nebraska-silicon-lab/Hardware/ETL/FNAL Tooling Designs/Chuck/ETL assy gantry layout.JPG

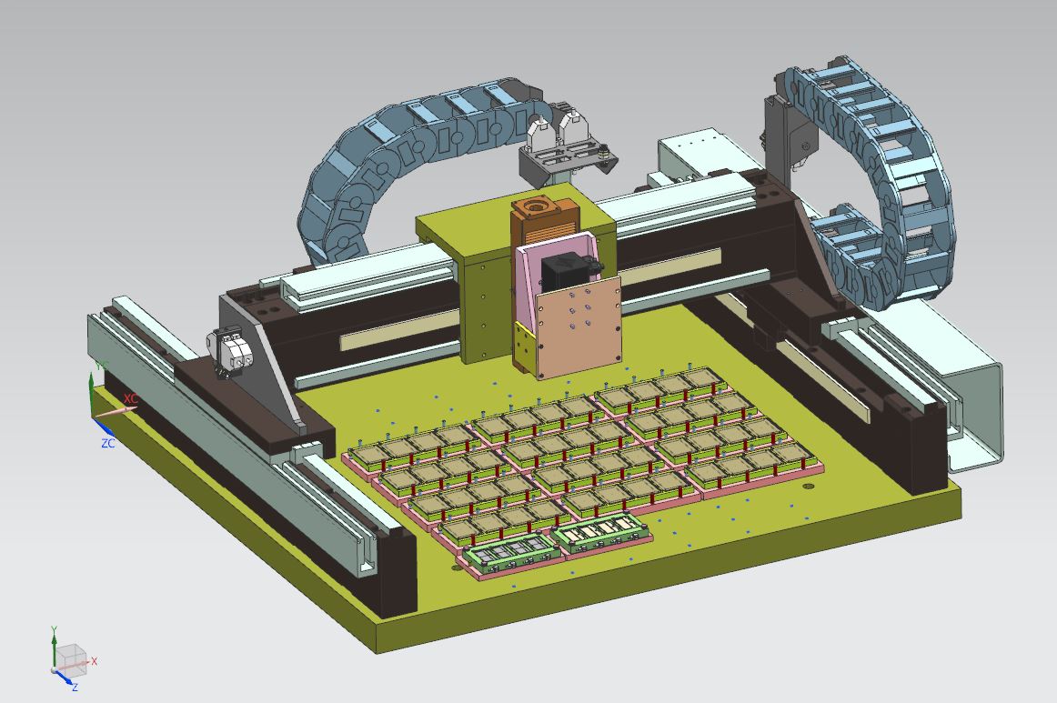
ETL/FNAL Tooling Designs/Chuck/ETL assy gantry layout.JPG
