nebraska-silicon-lab/Hardware/General Gantry/Gantry Hub/Graphics/Front Barrel Jack Label.png

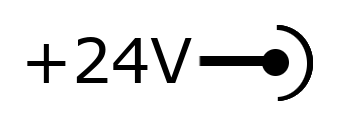
General Gantry/Gantry Hub/Graphics/Front Barrel Jack Label.png
