nebraska-silicon-lab/Hardware/General Gantry/Gantry Hub/Graphics/Front Graphic.png

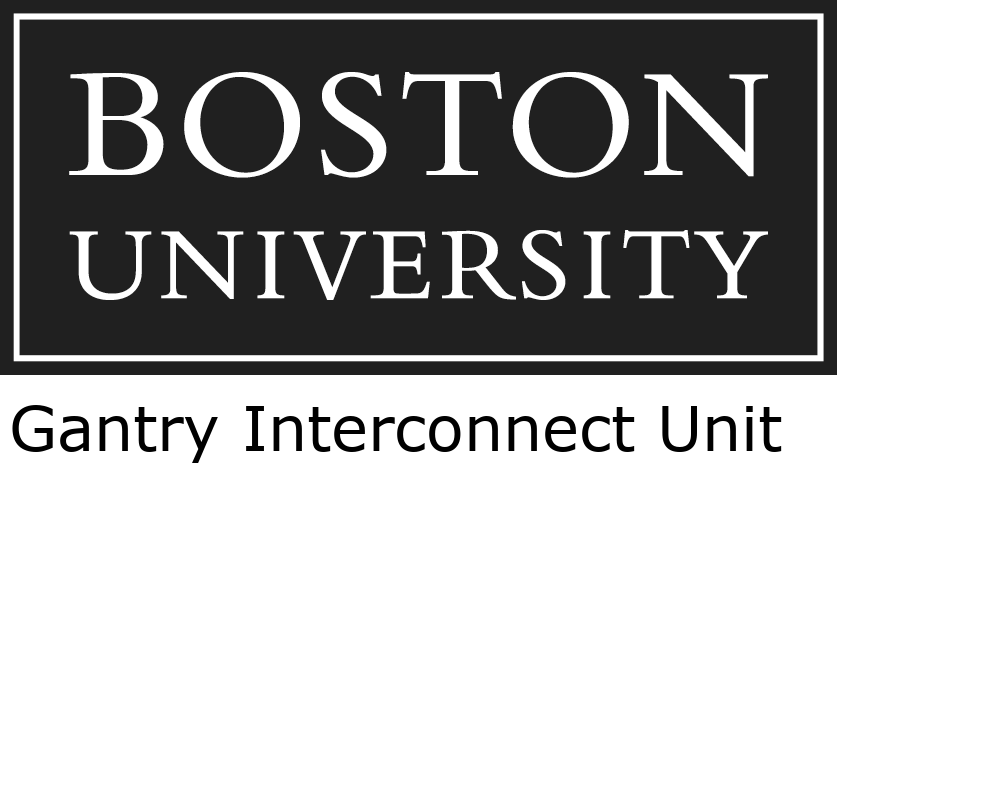
General Gantry/Gantry Hub/Graphics/Front Graphic.png
