nebraska-silicon-lab/Hardware/Wirebonder/Chuck spacer.JPG

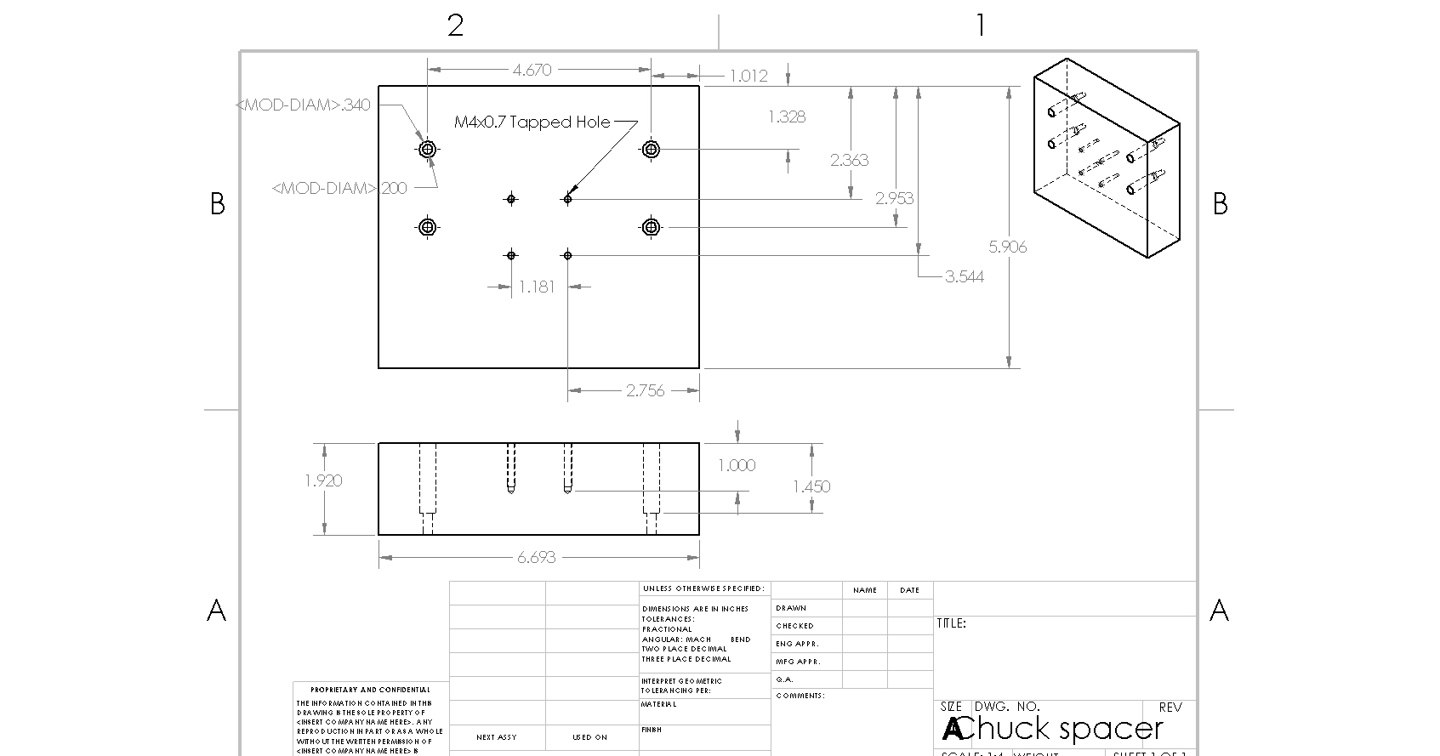
Wirebonder/Chuck spacer.JPG
