nebraska-silicon-lab/Hardware/Work Orders/ETL_blank_inst_workorder.xlsx

Chemistry and Physics & Astronomy |  |  |  |  |  | Daily Work Log
 |  |  |  |  |  | Name | Date | Hrs.
Instrument Shop Billing
Bob Rhynalds rrhynalds@unl.edu
177 JH 0299
472-2780
Cost Object | Department |  |  | Today's Date
26-0521-0189-002 M&S 26-0521-0189-003 labor | Physics & Astronomy
Requested by | Requestor's Phone |  |  | Requestors email
Requestor's Supervisor | Supervisor's Phone |  |  | Supervisor's Dept.
 |  |  |  | Physics & Astronomy
Equipment Name:
Work Instructions:
Comments:
Materials |  | QTY | Unit Cost |  | Total Cost
 |  |  |  |  | $0.00
 |  |  |  |  | $0.00
 |  |  |  |  | $0.00
 |  |  |  |  | $0.00
 |  |  |  |  | $0.00
 |  |  |  |  | $0.00
 |  |  |  |  | $0.00
 |  |  |  |  | $0.00
 |  |  |  |  | $0.00
 |  |  |  |  | $0.00
 |  |  |  |  | $0.00
 |  |  |  |  | $0.00
 |  |  |  |  | $0.00
 |  |  |  |  | $0.00
 |  |  |  |  | $0.00
 |  |  |  |  | $0.00
 |  |  |  |  | $0.00
 |  |  |  |  | $0.00
 |  |  |  |  | $0.00
Total Material Cost: |  |  |  |  | $0.00
 |  |  |  |  |  | Total Hours: |  | 0.00
Date Billed: | Total Hours: |  | SAP#
Total Materials: |  |  |  |  |  |  | Revised 18 Jan. 2013
© 2004-2013 University of Nebraska-Lincoln Physics and Astronomy Department
