nebraska-silicon-lab/Hardware/Work Orders/ETL_blank_elec_workorder.xlsx

Physics Electronic Shop Billing for ETL
Requested by: |  |  | Cost Object: | Supervisor: | Date: |  | Info:
 |  |  | 26-0521-0189-002 M&S -003 Labor | Frank Golf
Purpose:
Material |  |  |  |  |  | Qty | Unit $ | Total $
 |  |  |  |  |  |  |  | $0.00
 |  |  |  |  |  |  |  | $0.00
 |  |  |  |  |  |  |  | $0.00
 |  |  |  |  |  |  |  | $0.00
 |  |  |  |  |  |  |  | $0.00
 |  |  |  |  |  |  |  | $0.00
 |  |  |  |  |  |  |  | $0.00
 |  |  |  |  |  |  |  | $0.00
 |  |  |  |  |  |  |  | $0.00
 |  |  |  |  |  |  |  | $0.00
 |  |  |  |  |  |  |  | $0.00
Total amount $ |  |  |  |  |  |  |  | $0.00
Date | Name | Hours | Comments/Purpose
Total Hours: |  | 0
Date Billed: |  |  | SAP Doc Number:
Total Materials:
Total Hours:
© 2018 University of Nebraska-Lincoln Physics and Astronomy Department
