nebraska-silicon-lab/Hardware/Work Orders/2022_01_MilliQan_Wrapping-Stencil.xlsx

Chemistry and Physics & Astronomy |  |  |  |  |  |  | Daily Work Log
 |  |  |  |  |  |  | Name | Date | Hrs.
Instrument Shop Billing
Bob Rhynalds rrhynalds@unl.edu
177 JH 0299
472-2780
Cost Object |  | Department |  |  | Today's Date
21-0521-4139 |  | Physics & Astronomy |  |  | 2022-01-21
Requested by |  | Requestor's Phone |  |  | Requestors email
Miranda Bryson |  | (3369051250 |  |  | mbryson4@unl.edu
Requestor's Supervisor |  | Supervisor's Phone |  |  | Supervisor's Dept.
Frank Golf |  | (4024726151 |  |  | Physics & Astronomy
Equipment Name: | Milliqan Wrapping Stencil
Work Instructions: |  | Fabricate metal stencil for Milliqan scintillator wrapping
Comments:
Materials |  |  | QTY | Unit Cost |  | Total Cost
 |  |  |  |  |  | $0.00
 |  |  |  |  |  | $0.00
 |  |  |  |  |  | $0.00
 |  |  |  |  |  | $0.00
 |  |  |  |  |  | $0.00
 |  |  |  |  |  | $0.00
 |  |  |  |  |  | $0.00
 |  |  |  |  |  | $0.00
 |  |  |  |  |  | $0.00
 |  |  |  |  |  | $0.00
 |  |  |  |  |  | $0.00
 |  |  |  |  |  | $0.00
 |  |  |  |  |  | $0.00
 |  |  |  |  |  | $0.00
 |  |  |  |  |  | $0.00
 |  |  |  |  |  | $0.00
 |  |  |  |  |  | $0.00
 |  |  |  |  |  | $0.00
 |  |  |  |  |  | $0.00
Total Material Cost: |  |  |  |  |  | $0.00
 |  |  |  |  |  |  | Total Hours: |  | 0.00
Date Billed: |  | Total Hours: |  | SAP#
Total Materials: |  |  |  |  |  |  |  | Revised 18 Jan. 2013
© 2004-2013 University of Nebraska-Lincoln Physics and Astronomy Department
