nebraska-silicon-lab/Hardware/Work Orders/2021_02_TFPX_weight_for_HDI.xlsx

Chemistry and Physics & Astronomy |  |  |  |  |  |  |  | Daily Work Log
 |  |  |  |  |  |  |  | Name | Date | Hrs.
Instrument Shop Billing |  |  |  |  |  |  |  | Keith | 2021-02-16 | 3.00
Bob Rhynalds rrhynalds@unl.edu
177 JH 0299 |  |  |  |  |  |  |  | Keith | 2021-02-17 | 3.00
472-2780
Cost Object |  |  | Department |  |  | Today's Date
M&S | 26-0521-0195-003 |  | Physics |  |  | Feb / 5th / 2021
labor | 26-0521-0195-001
Requested by |  |  | Requestor's Phone |  |  | Requestors email
Changwoo Joo |  |  | 531-218-8542 |  |  | gopchang24@gmail.com
Requestor's Supervisor |  |  | Supervisor's Phone |  |  | Supervisor's Dept.
Ilya Kravchenko |  |  | 402-617-5736 |  |  | Physics
Equipment Name: |  | weight for HDI
Work Instructions: |  |  | Simple wight to press HDI. Making a new one with
more holes to measure the HDI position
Comments:
Materials |  |  |  | QTY | Unit Cost |  | Total Cost
 |  |  |  |  |  |  | $0.00
1/8" endmill |  |  |  | 1.00 | $10.00 |  | $10.00
#56 Dill Bit |  |  |  | 1.00 | $2.50 |  | $2.50
1.0mm Carbide endmill |  |  |  | 1.00 | $8.25 |  | $8.25
 |  |  |  |  |  |  | $0.00
 |  |  |  |  |  |  | $0.00
 |  |  |  |  |  |  | $0.00
 |  |  |  |  |  |  | $0.00
 |  |  |  |  |  |  | $0.00
 |  |  |  |  |  |  | $0.00
 |  |  |  |  |  |  | $0.00
 |  |  |  |  |  |  | $0.00
 |  |  |  |  |  |  | $0.00
 |  |  |  |  |  |  | $0.00
 |  |  |  |  |  |  | $0.00
 |  |  |  |  |  |  | $0.00
 |  |  |  |  |  |  | $0.00
 |  |  |  |  |  |  | $0.00
 |  |  |  |  |  |  | $0.00
Total Material Cost: |  |  |  |  |  |  | $20.75
 |  |  |  |  |  |  |  | Total Hours: |  | 6.00
Date Billed: |  |  | Total Hours: |  | SAP#
Total Materials: |  |  |  |  |  |  |  |  | Revised 18 Jan. 2013
© 2004-2013 University of Nebraska-Lincoln Physics and Astronomy Department
