nebraska-silicon-lab/Hardware/General Gantry/Gantry Tool Rack/Tool Rack Assembly.xlsx

Part Name | File Path (from Gantry folder) | Model Checked | Drawing Name | Drawing Checked | Machined | Assembled | Notes
Top | NewGantryParts\Gantry Full Assembly\Tool Rack | X | Top.idw | X | X | X | working
Sides | NewGantryParts\Gantry Full Assembly\Tool Rack | X | Side.idw | X | X | X | working
Bottom | NewGantryParts\Gantry Full Assembly\Tool Rack | X | Base Plate.idw | X | X | X | working
BackStrap1 | NewGantryParts\Gantry Full Assembly\Tool Rack | X | Back Strap.idw | X | X | X | working
Spring Plungers 84985A58 | NewGantryParts\Gantry Full Assembly\Tool Rack | n/a | n/a | n/a | n/a | X | ordered from McMaster-Carr
SHCS-steel 8-32x0.5 | NewGantryParts\NewParts | n/a | n/a | n/a | n/a | X | ordered from McMaster-Carr
Spring Plungers 84985A15 | NewGantryParts\Gantry Full Assembly\Tool Rack | n/a | n/a | n/a | n/a | X | ordered from McMaster-Carr
