nebraska-silicon-lab/Hardware/General Gantry/Gantry Tool Holder/ToolHolder.xlsx

Sheet: Assembly
Assembly Name | File Path (from Gantry folder) | Model Checked | Drawing Name | Drawing Checked | Machined | Assembled | Notes
ToolHolderAssembly | NewGantryParts>OriginalUCSB>ToolHolder | XX | ToolHolderAssembly | XX |  |  | All machined parts for this assembly are needed at PURDUE and NEBRASKA.
ToolHolderAdapterAssy | \NewGantryParts\NewParts\ToolHolderAdapter | XX | ToolHolderAdapterAssy | XX |  |  | PURDUE does not need another ToolHolderAdapter machined.

Sheet: Tool Holder
Part Name | File Path (from Gantry folder) | Model Checked | Drawing Name | Drawing Checked | Machined | Assembled | Notes
HoseBarbAddOn | NewGantryParts>OriginalUCSB>ToolHolder | XX | HoseBarbAddOn | XX
ContactPuck | NewGantryParts>OriginalUCSB>ToolHolder | XX | ContactPuck | XX |  |  | adjust relief depth for actual micro switch height
DispenserHolder | NewGantryParts>OriginalUCSB>ToolHolder | XX | DispenserHolder | XX
DispenserHolderArm | NewGantryParts>OriginalUCSB>ToolHolder | XX | DispenserHolderArm | XX
DispenserHolderCapturePlate | NewGantryParts>OriginalUCSB>ToolHolder | XX | DispenserHolderCapturePlate | XX
ToolHolderSlugBody | NewGantryParts>OriginalUCSB>ToolHolder | XX | ToolHolderSlugBody | XX
ToolHolderSpool | NewGantryParts>OriginalUCSB>ToolHolder | XX | ToolHolderSpool | XX
Rolling bearing Type 51000 51105(ID 26mm Part) | NewGantryParts>OriginalUCSB>ToolHolder | X | n/a | n/a | n/a |  | 51105 Thrust Bearing 25x42x11 Thrust Bearings(VXB Ball Bearings)
BallBearingBall | NewGantryParts>OriginalUCSB>ToolHolder | X | n/a | n/a | n/a
5454K63_0.125ID_Tube_Barb | NewGantryParts>OriginalUCSB>ToolHolder | n/a | n/a | n/a | n/a
5454K740_0.0625ID_Tube_Barb | NewGantryParts>OriginalUCSB>ToolHolder | n/a | n/a | n/a | n/a
91772A030 | NewGantryParts>OriginalUCSB>ToolHolder | n/a | n/a | n/a | n/a
9396K27 Silicone O-Ring | NewGantryParts>OriginalUCSB>ToolHolder | n/a | n/a | n/a | n/a
9396K153 Silicone O-Ring | NewGantryParts>OriginalUCSB>ToolHolder | n/a | n/a | n/a | n/a
91251A831 | NewGantryParts>OriginalUCSB>ToolHolder | n/a | n/a | n/a | n/a
9452K87 Buna-N O-Ring | NewGantryParts>OriginalUCSB>ToolHolder | n/a | n/a | n/a | n/a
9452K14 Buna-N O-Ring | NewGantryParts>OriginalUCSB>ToolHolder | n/a | n/a | n/a | n/a
9452K15 Buna-N O-Ring | NewGantryParts>OriginalUCSB>ToolHolder | n/a | n/a | n/a | n/a
KSR MicroSwitch | NewGantryParts>OriginalUCSB>ToolHolder | n/a | n/a | n/a | n/a |  | Digi Key Number: 401-1703-1-ND, Manufacturers Number: KSR221GLFS
ToolHolderAdapter | NewGantryParts\NewParts\ToolHolderAdapter | XX | ToolHolderAdapter | XX | X | X | PURDUE does not need another ToolHolderAdapter machined.
92125A211 | NewGantryParts\NewParts\ToolHolderAdapter | n/a | n/a | n/a | n/a
9262K645 Buna-N O-Ring | NewGantryParts\NewParts\ToolHolderAdapter | n/a | n/a | n/a | n/a
92210A151 | NewGantryParts\NewParts\ToolHolderAdapter | n/a | n/a | n/a | n/a
