nebraska-silicon-lab/Hardware/FPIX/UNLHEP-14-01-partlist.txt

Assemblies
==========
UNLHEP-14-01-A-001_BonderChuckWplate.iam
UNLHEP-14-01-A-002_GantryChuckWplate.iam
UNLHEP-14-01-A-003_ChuckW4modules.iam
UNLHEP-14-01-A-004_ChuckOnTrspChuck.iam
UNLHEP-14-01-A-005_HdiGlueWeight.iam
UNLHEP-14-01-A-006_Rubberstamp.iam
UNLHEP-14-01-A-007_Picker.iam
UNLHEP-14-01-A-008_PickerWStamp.iam
UNLHEP-14-01-A-009_StampStorage.iam
UNLHEP-14-01-A-010_GlueResOnChuck.iam

Parts
=====
UNLHEP-14-01-P-001_ModuleChuck.ipt
UNLHEP-14-01-P-002_ChuckForBonder.ipt
UNLHEP-14-01-P-003_Tube4mmID20mm.ipt
UNLHEP-14-01-P-004_ChuckForGantry.ipt
UNLHEP-14-01-P-005_ModuleStencil.ipt
UNLHEP-14-01-P-006_SensorMock.ipt
UNLHEP-14-01-P-007_TransportChuck.ipt
UNLHEP-14-01-P-008_ValveStopper.ipt
UNLHEP-14-01-P-009_BrassWeight.ipt
UNLHEP-14-01-P-010_WeightBlade.ipt
UNLHEP-14-01-P-011_Rubberstamp.ipt
UNLHEP-14-01-P-012_StampPlate.ipt
UNLHEP-14-01-P-013_PickerPlate.ipt
UNLHEP-14-01-P-014_PickerDistanceRing.ipt
UNLHEP-14-01-P-015_PickerStrip.ipt
UNLHEP-14-01-P-016_StampStoragePlate.ipt
UNLHEP-14-01-P-017_GlueReservoit.ipt
UNLHEP-14-01-P-018_PickerRubberPiece.ipt
