nebraska-silicon-lab/Hardware/Work Orders/TFPX_blank_elec_workorder.xlsx

Physics Electronic Shop Billing for TFPX
Requested by: |  |  | Cost Object: | Supervisor: | Date: |  | Info:
 |  |  | M&S 26-0521-0195-003 labor 26-0521-0195-001 | Frank Golf
Purpose:
Material |  |  |  |  |  | Qty | Unit $ | Total $
 |  |  |  |  |  |  |  | $0.00
 |  |  |  |  |  |  |  | $0.00
 |  |  |  |  |  |  |  | $0.00
 |  |  |  |  |  |  |  | $0.00
 |  |  |  |  |  |  |  | $0.00
 |  |  |  |  |  |  |  | $0.00
 |  |  |  |  |  |  |  | $0.00
 |  |  |  |  |  |  |  | $0.00
 |  |  |  |  |  |  |  | $0.00
 |  |  |  |  |  |  |  | $0.00
 |  |  |  |  |  |  |  | $0.00
Total amount $ |  |  |  |  |  |  |  | $0.00
Date | Name | Hours | Comments/Purpose
Total Hours: |  | 0
Date Billed: |  |  | SAP Doc Number:
Total Materials:
Total Hours:
© 2018 University of Nebraska-Lincoln Physics and Astronomy Department
