nebraska-silicon-lab/Hardware/ETL/Irradiation Fixture/Module Holder Full Cover V1.stl

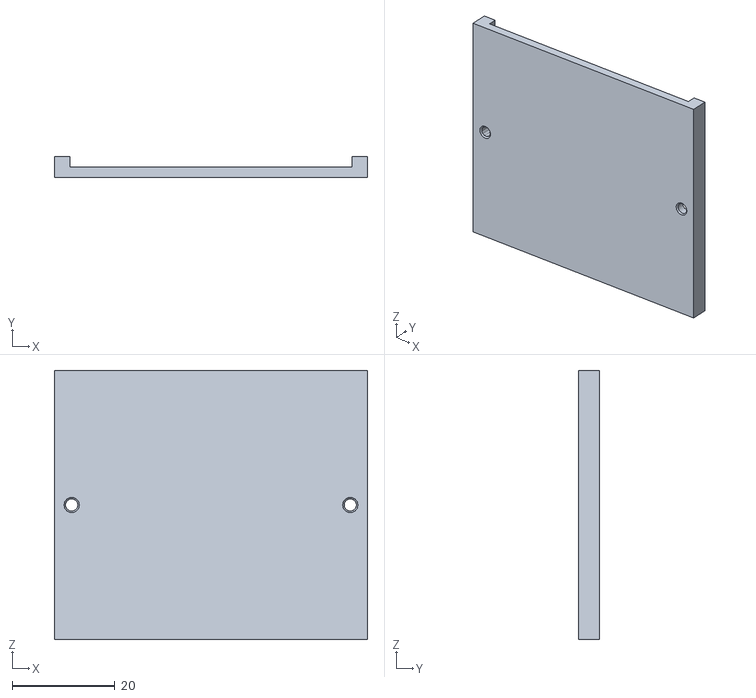
[picture p5: CAD file, 2024-06-04]
ETL/Irradiation Fixture/Module Holder Full Cover V1.stl
61.0 x 4.00 x 52.5
