nebraska-silicon-lab/Hardware/ETL/Module Assembly/Assembly Plate/Assembly Plate Assembly.stp

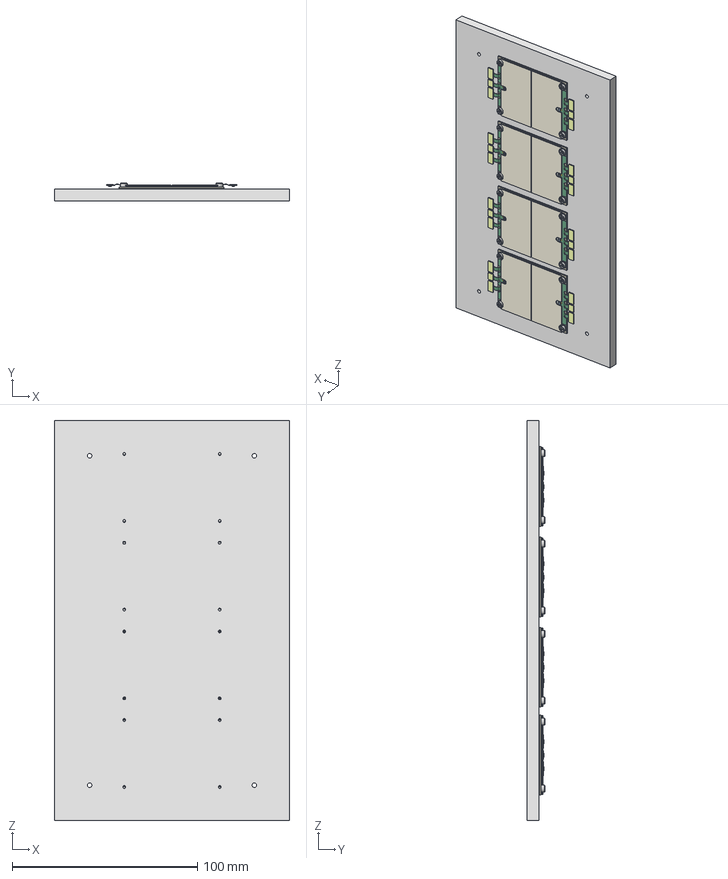
[picture p6: CAD file, 2021-02-12]
ETL/Module Assembly/Assembly Plate/Assembly Plate Assembly.stp
127.0 x 9.64 x 215.9 mm
Assembly Plate
F10109317--_1-MODULE_ CMS2 ETL_ FLEX CIRCUIT x 8
F10109316--_1-MODULE_ CMS2 ETL_ ALN SUBSTRATE x 4
F10112318--_1-MODULE_ CMS2 ETL_ PIXEL SENSOR 1X2 x 8
F10112320--_1-MODULE_ CMS2 ETL_ PIXEL SENSOR UNDERFILL x 8
F10112319--_1-MODULE_ CMS2 ETL_ PIXEL SENSOR READOUT CHIP x 16
F10110221--_1-MODULE_ CMS2 ETL_ FLEX CIRCUIT WIREBONDS x 8
F10112322--_1-MODULE_ CMS2 ETL_ READOUT CHIP MOUNTING FILM x 4
F10112323--_1-MODULE_ CMS2 ETL_ FLEX CIRCUIT MOUNTING FILM x 8
F10110888--_1-MODULE_ CMS2 ETL_ SUBSTRATE MOUNTING THERMAL PAD x 4
F10112938--_1-MODULE_ CMS2 ETL_ SENSOR COVER PLT x 8
F10116301--_1-MODULE_ CMS2 ETL_ SENSOR COVER PLT ADHESIVE x 8
F10109326--_1-WASHER_ BELLEVILLE_ .093IDx.187ODx.01THK_ 17-7 PH STAIN LESS STEEL x 16
FC0041908--_1-SHCS_M2x.4x5LGxFT_SS316L_ROLLED_EP x 16
