nebraska-silicon-lab/Hardware/ETL/modules/throughput mockups/Throughput Mockup Assembly.stp

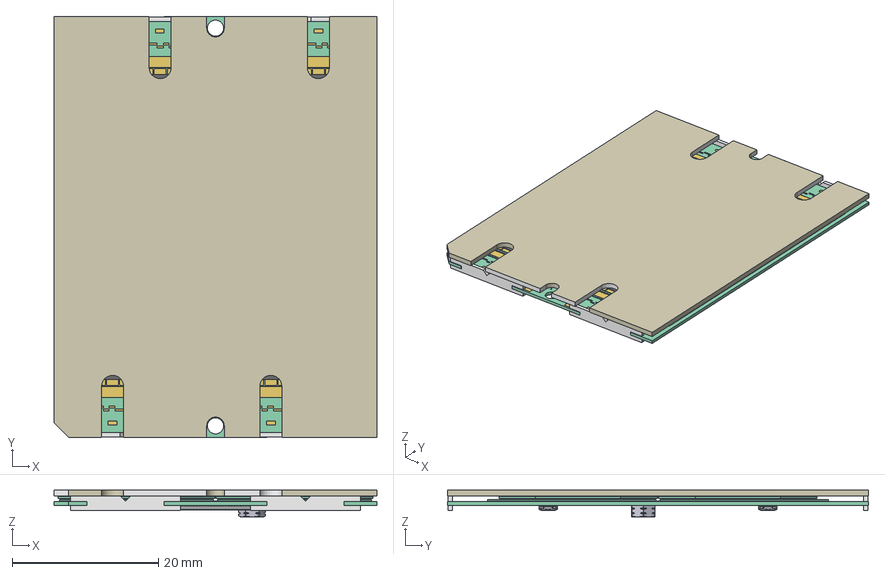
[picture p7: CAD file, 2024-06-04]
ETL/modules/throughput mockups/Throughput Mockup Assembly.stp
44.1 x 57.5 x 3.67 mm
etl_etroc_mockup_v1p1 x 4
etl_lgad_mockup_v1p2 x 4
Coverplate Film
Sensor Placement Film
etl standard baseplate with cutouts
etl_module_pcb_mockup_v3p3p1
insert spacer - v1 x 4
