nebraska-silicon-lab/Hardware/ETL/modules/throughput mockups/throughput mockups/Throughput Mockup Assembly.stp

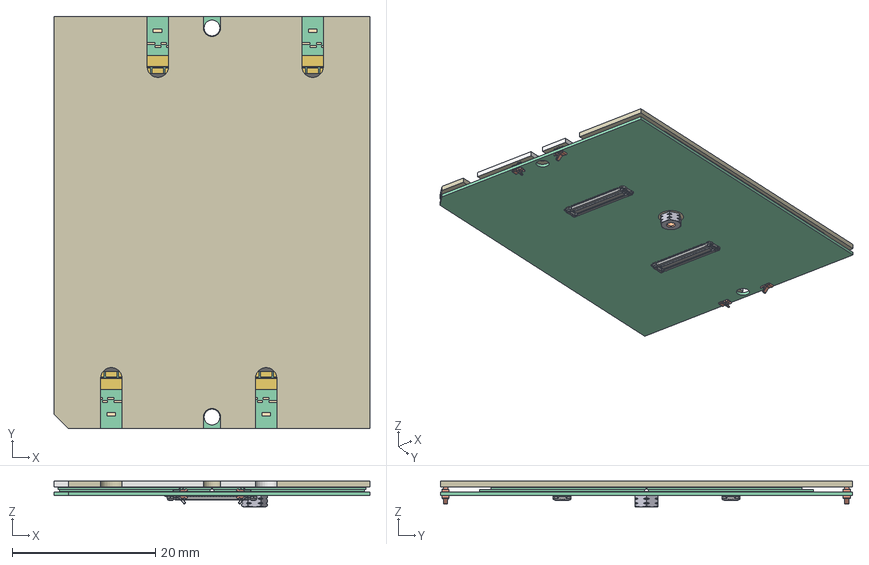
[picture p8: CAD file, 2023-03-06]
ETL/modules/throughput mockups/throughput mockups/Throughput Mockup Assembly.stp
44.1 x 57.5 x 3.60 mm
Pcb_3ce5
PCB_Sketch_3ce5
topPads_3ce5
botPads_3ce5
REF_C-2306334-3_inf x 8
REF_PRODUCT_NAME_1_62E086DE
J2_Board to board, M_613027AA x 2
etl_lgad_mockup_v1p1 x 4
etl_etroc_mockup_v1p1 x 4
Board to board, M x 2
Coverplate Film
Sensor Placement Film
etl standard baseplate with cutouts
