nebraska-silicon-lab/Hardware/ETL/Module Assembly/Weight - V2/step/Weight Assembly.stp

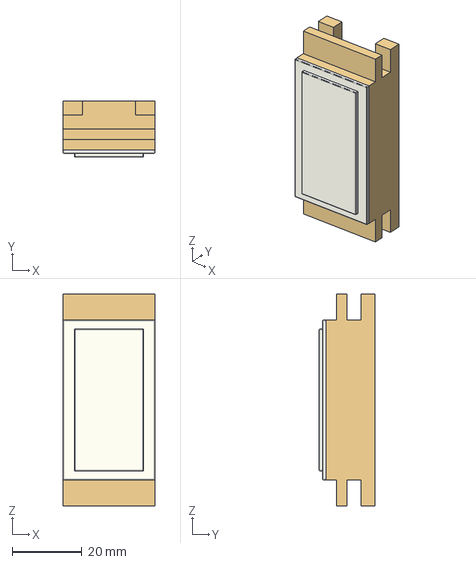
[picture p9: CAD file, 2021-07-19]
ETL/Module Assembly/Weight - V2/step/Weight Assembly.stp
26.3 x 16.0 x 60.7 mm
Stamp Body
Bottom Surface
