nebraska-silicon-lab/Hardware/MilliQan/PMT Mounts/Slab Mount - Fabricated - V2/Slab Mount Assembly - Fabricated - V2.stp

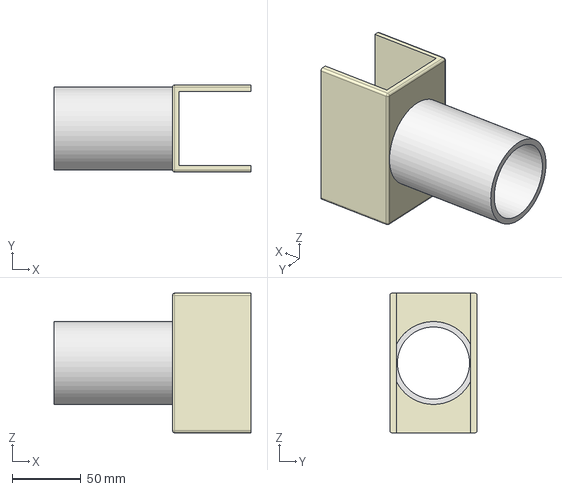
[picture p10: CAD file, 2022-04-20]
MilliQan/PMT Mounts/Slab Mount - Fabricated - V2/Slab Mount Assembly - Fabricated - V2.stp
143.4 x 63.5 x 101.6 mm
U Channel
48925K96_Standard-Wall Unthreaded Rigid PVC Pipe for Water
