nebraska-silicon-lab/Hardware/ETL/Irradiation Fixture/Module Holder Full V1.stl

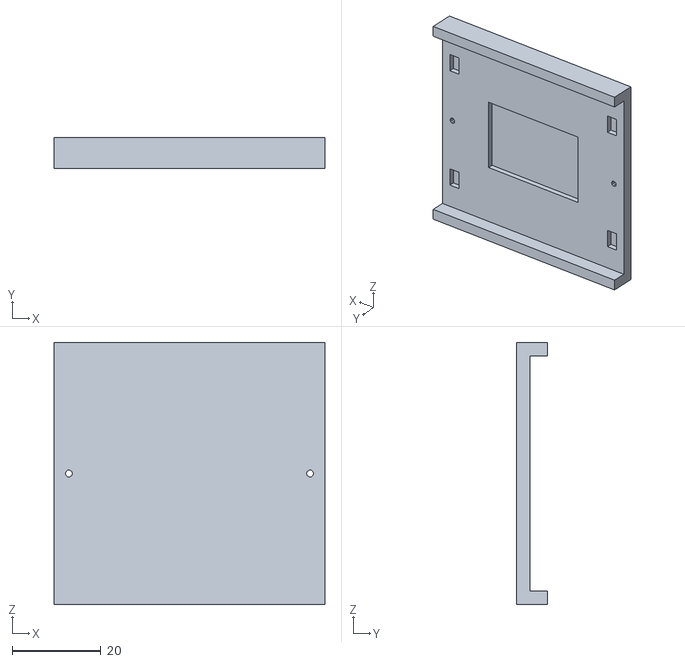
[picture p11: CAD file, 2024-06-04]
ETL/Irradiation Fixture/Module Holder Full V1.stl
61.0 x 7.00 x 59.0
