nebraska-silicon-lab/Hardware/ETL/bump_bonding/ASIC Alignment Tool.stp

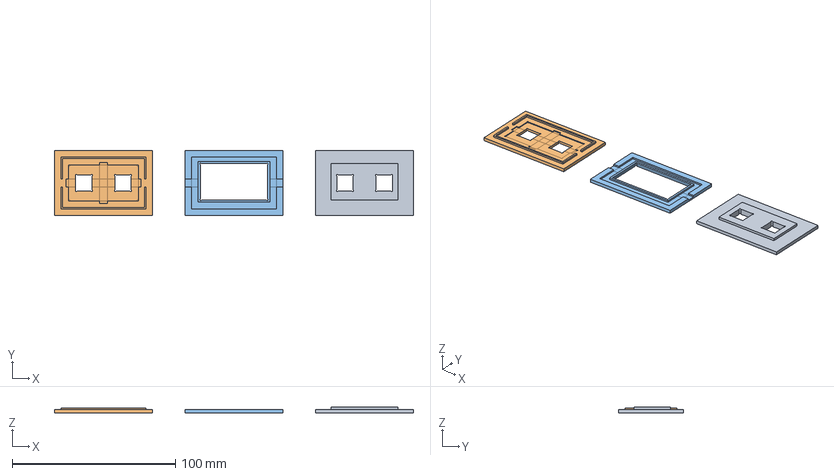
[picture p12: CAD file, 2020-09-22]
ETL/bump_bonding/ASIC Alignment Tool.stp
220.0 x 40.0 x 3.50 mm
