nebraska-silicon-lab/Hardware/ETL/Jigs/Sensor Mount Film Applicator - V2/Module PCB Stencil - V3.dxf

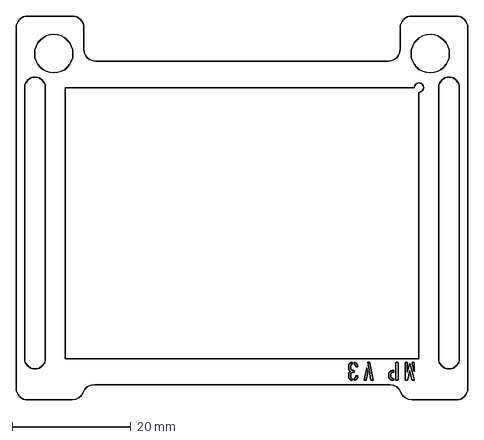
[picture p13: CAD file, 2023-07-11]
ETL/Jigs/Sensor Mount Film Applicator - V2/Module PCB Stencil - V3.dxf
76.2 x 64.8 mm
