nebraska-silicon-lab/Hardware/ETL/Module Assembly/BBM Staging Plate - V2/BBM Staging Plate - V2.stp

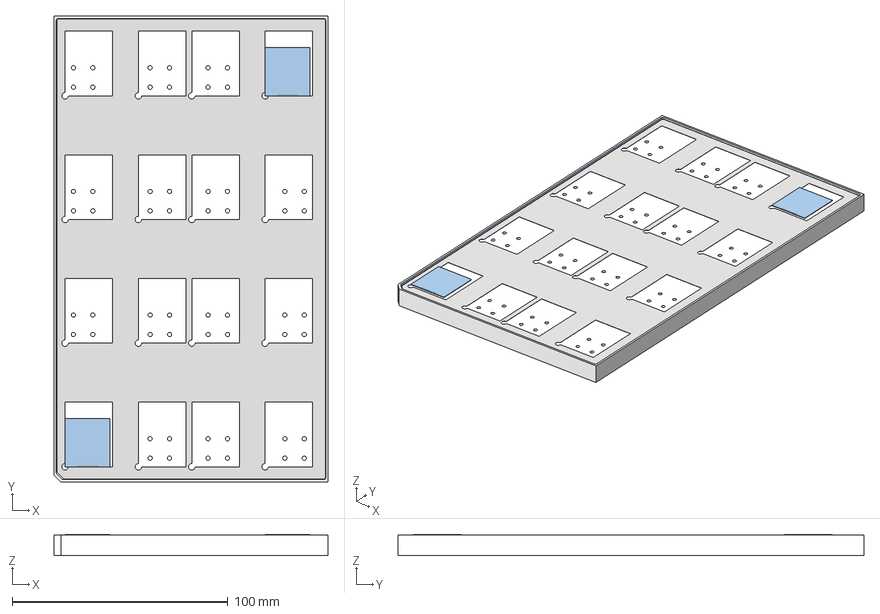
[picture p14: CAD file, 2022-10-10]
ETL/Module Assembly/BBM Staging Plate - V2/BBM Staging Plate - V2.stp
127.0 x 215.9 x 9.78 mm
Assembly Plate
Assembly Stencil
F10112319--_1-MODULE_ CMS2 ETL_ PIXEL SENSOR READOUT CHIP x 2
