nebraska-silicon-lab/Hardware/ETL/Module Assembly/Chuck - 16-pocket V1F/Chuck - 16-pocket - V1F.stp

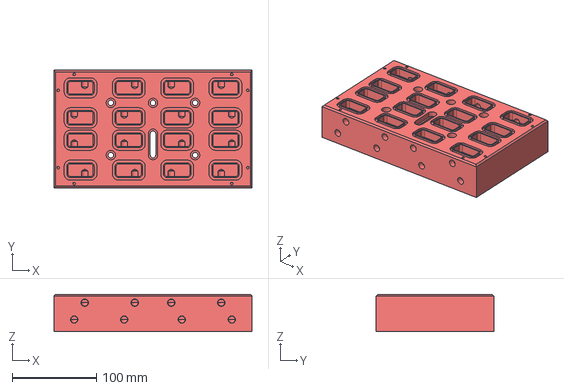
[picture p15: CAD file, 2022-10-10]
ETL/Module Assembly/Chuck - 16-pocket V1F/Chuck - 16-pocket - V1F.stp
234.9 x 139.7 x 44.4 mm
