nebraska-silicon-lab/Hardware/ETL/Module Assembly/Chuck - Octopocket/Chuck - Octopocket.stp

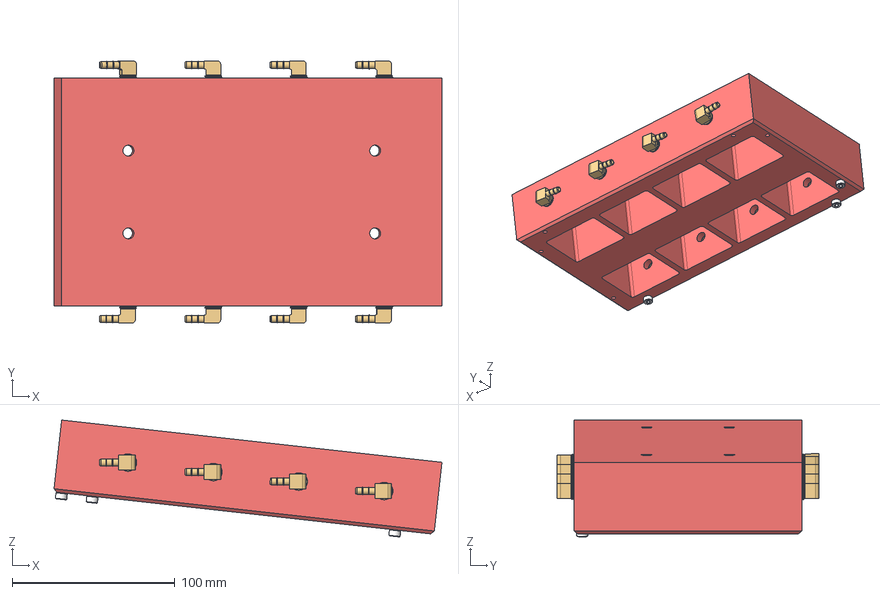
[picture p16: CAD file, 2021-04-07]
ETL/Module Assembly/Chuck - Octopocket/Chuck - Octopocket.stp
238.2 x 161.1 x 71.8 mm
UNLHEP-14-01-P-004_ChuckForGantry
90128A212_ZNC-PLTD ALLOY STL SCKT HEAD CAP SCREW x 3
44555K147_BRASS BARBED TUBE FITTING FOR VACUUM x 8
