nebraska-silicon-lab/Hardware/ETL/Module Assembly/Chuck - V2F/Chuck - V2F.stp

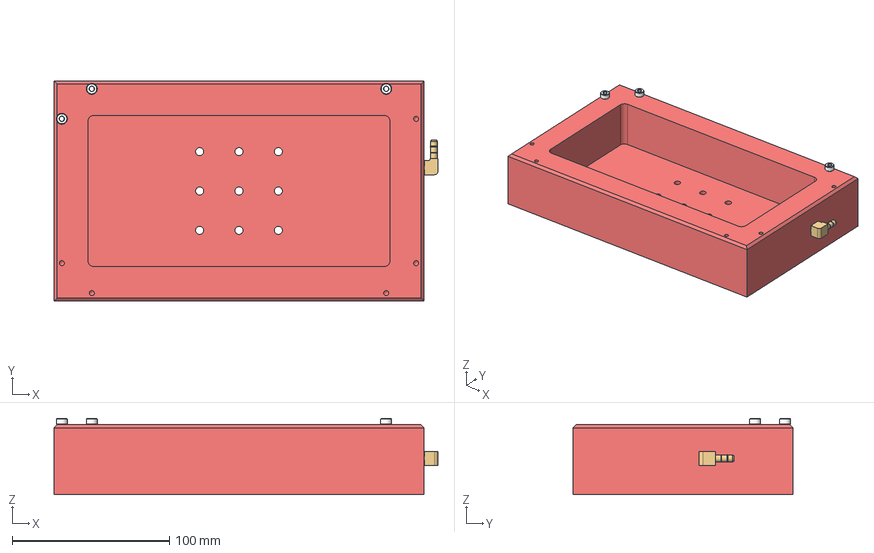
[picture p17: CAD file, 2021-07-19]
ETL/Module Assembly/Chuck - V2F/Chuck - V2F.stp
243.8 x 139.7 x 48.5 mm
UNLHEP-14-01-P-004_ChuckForGantry
90128A212_ZNC-PLTD ALLOY STL SCKT HEAD CAP SCREW x 3
44555K147_BRASS BARBED TUBE FITTING FOR VACUUM
