nebraska-silicon-lab/Hardware/ETL/Module Assembly/Glue Reservoir Plate - V2/Glue Reservoir Plate - V2.stp

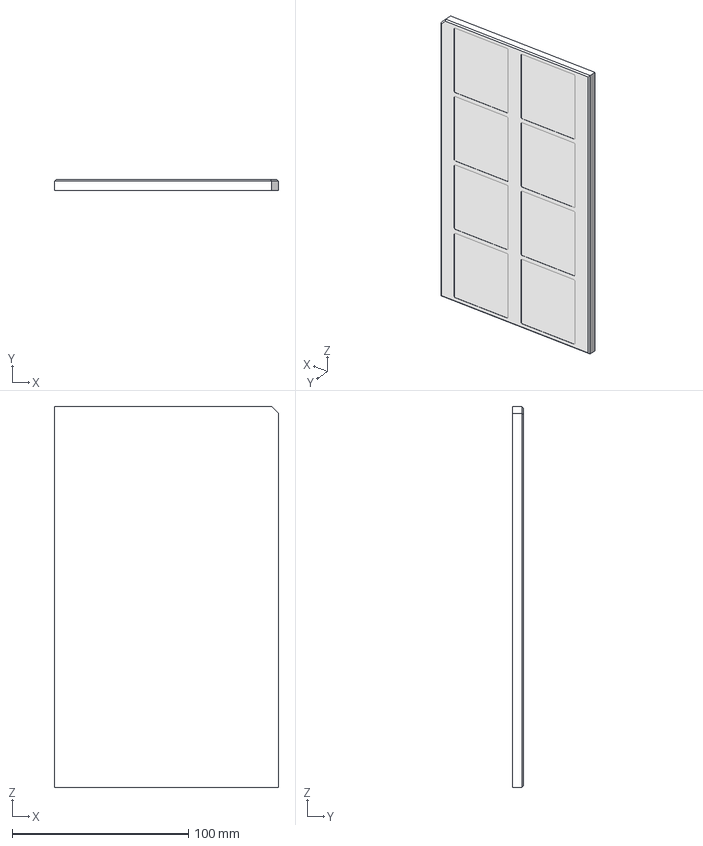
[picture p18: CAD file, 2022-02-14]
ETL/Module Assembly/Glue Reservoir Plate - V2/Glue Reservoir Plate - V2.stp
127.0 x 6.35 x 215.9 mm
