nebraska-silicon-lab/Hardware/ETL/Module Assembly/Grabber Tool - V2/Grabber Tool - V2.stp

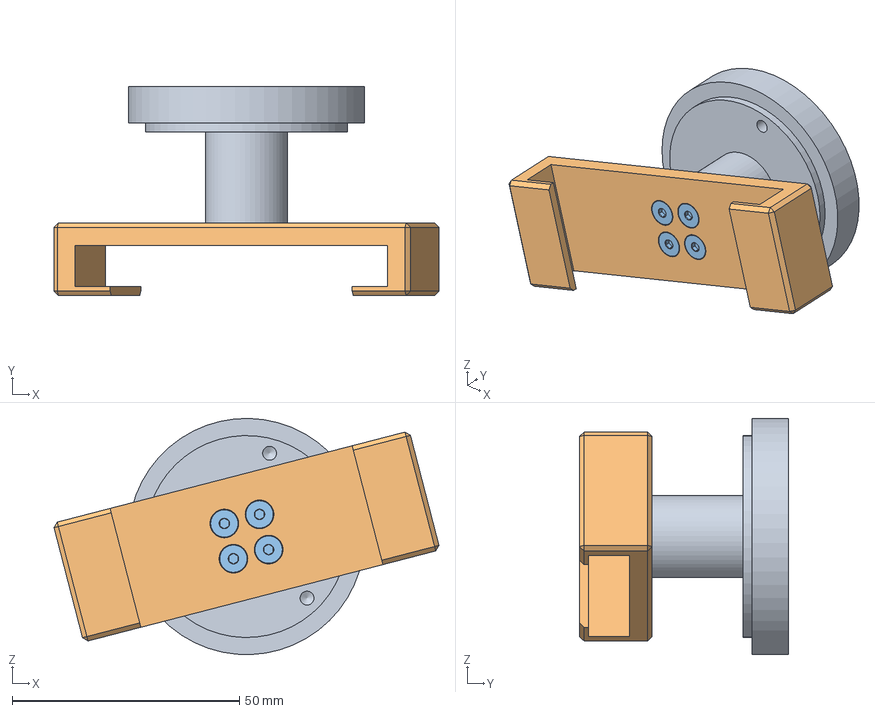
[picture p19: CAD file, 2022-02-14]
ETL/Module Assembly/Grabber Tool - V2/Grabber Tool - V2.stp
84.7 x 46.0 x 51.9 mm
Grabber Base
Grabber Platform
92125A130_TYPE 18-8 SS FLAT-HEAD SOCKET CAP SCREW x 4
