nebraska-silicon-lab/Hardware/ETL/Module Assembly/Module PCB Mockup/etl_module_pcb_mockup_v1.step

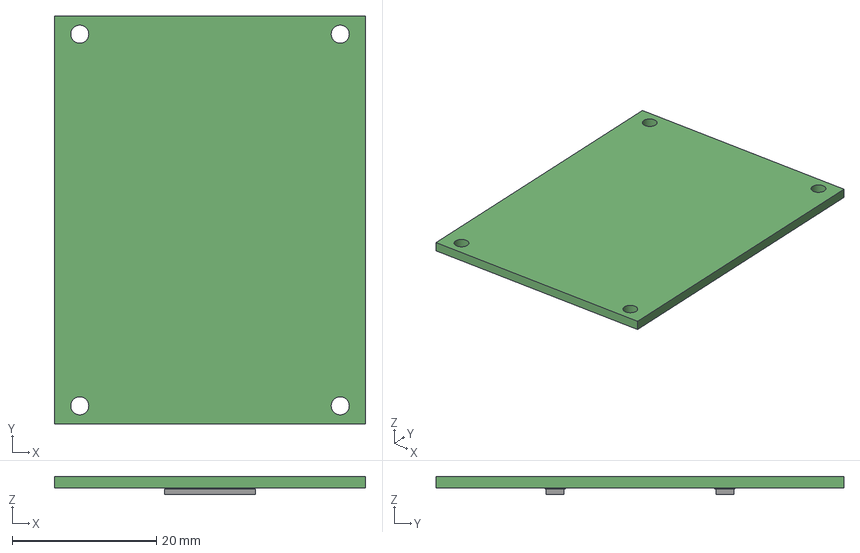
[picture p20: CAD file, 2021-11-09]
ETL/Module Assembly/Module PCB Mockup/etl_module_pcb_mockup_v1.step
43.1 x 56.5 x 2.55 mm
