nebraska-silicon-lab/Hardware/ETL/Module Assembly/Weight - V2/step/Bottom Surface.stp

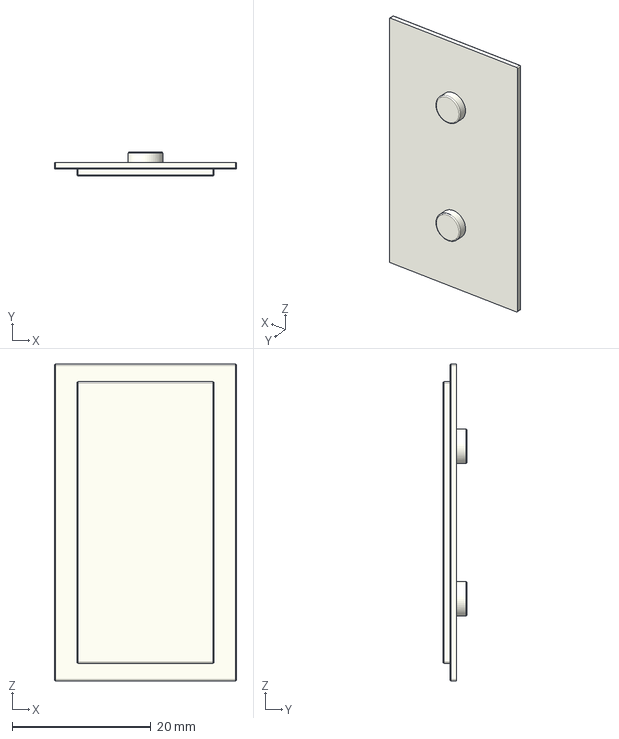
[picture p22: CAD file, 2021-07-19]
ETL/Module Assembly/Weight - V2/step/Bottom Surface.stp
26.3 x 3.50 x 45.7 mm
