nebraska-silicon-lab/Hardware/ETL/Module Assembly/Weight - V2/Weight - V2.stp

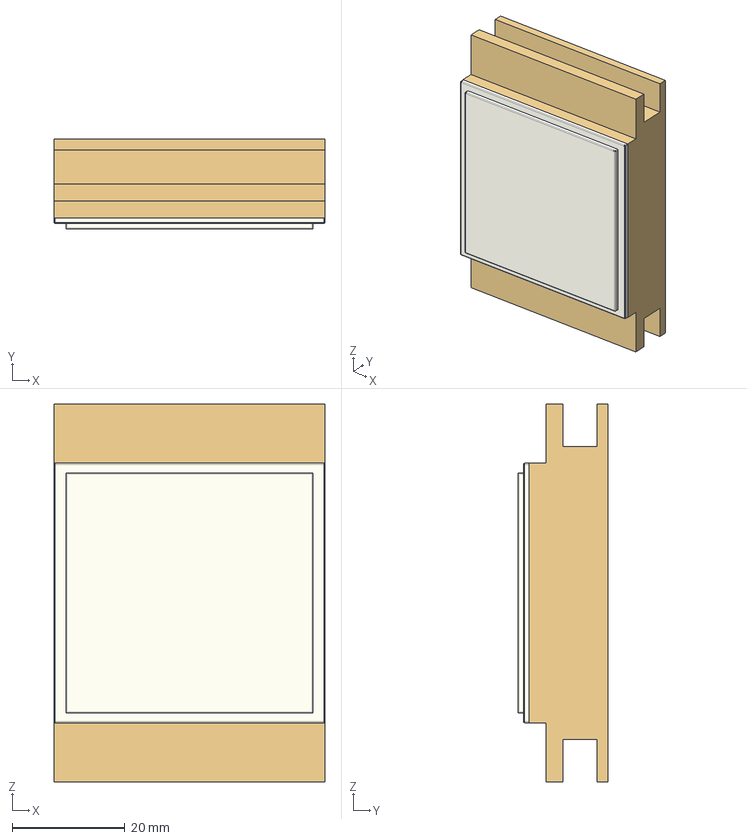
[picture p23: CAD file, 2022-01-28]
ETL/Module Assembly/Weight - V2/Weight - V2.stp
48.0 x 16.0 x 67.0 mm
Stamp Body
Bottom Surface
