nebraska-silicon-lab/Hardware/ETL/module_commissioning/TReTA/hot_plate_bottom.step

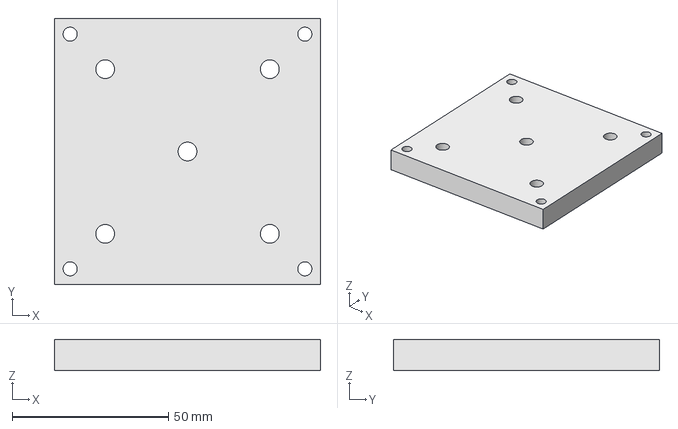
[picture p24: CAD file, 2020-09-22]
ETL/module_commissioning/TReTA/hot_plate_bottom.step
85.0 x 85.0 x 10.0 mm
