nebraska-silicon-lab/Hardware/ETL/modules/BU module V1a/module_V1a.step

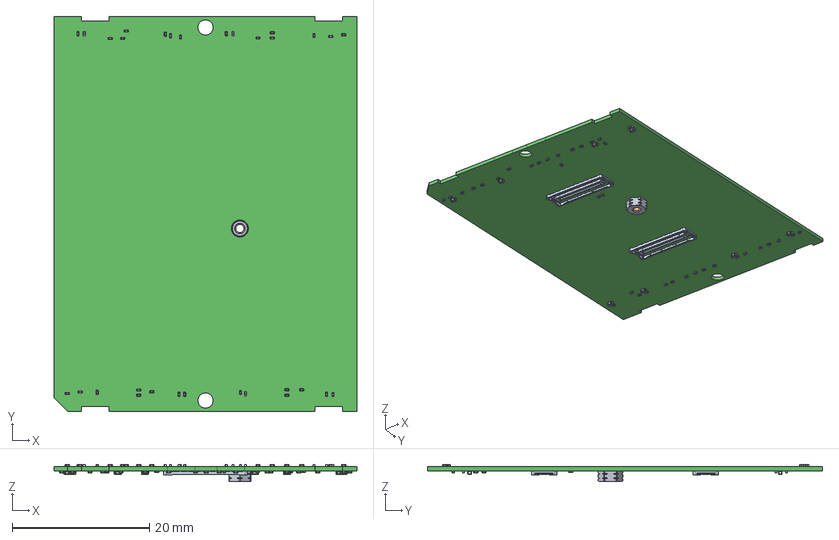
[picture p25: CAD file, 2023-06-12]
ETL/modules/BU module V1a/module_V1a.step
44.1 x 57.5 x 2.54 mm
RESC0603X28N x 12
SMTSO-080-2ET-PennEngineering-3D-03-15-2023
CAPC0603X33N x 56
CAPC1005X55N x 8
