nebraska-silicon-lab/Hardware/ETL/modules/tamale v1.5 Thermal Mockup/etl_module_pcb_thermal_mockup_v3.step

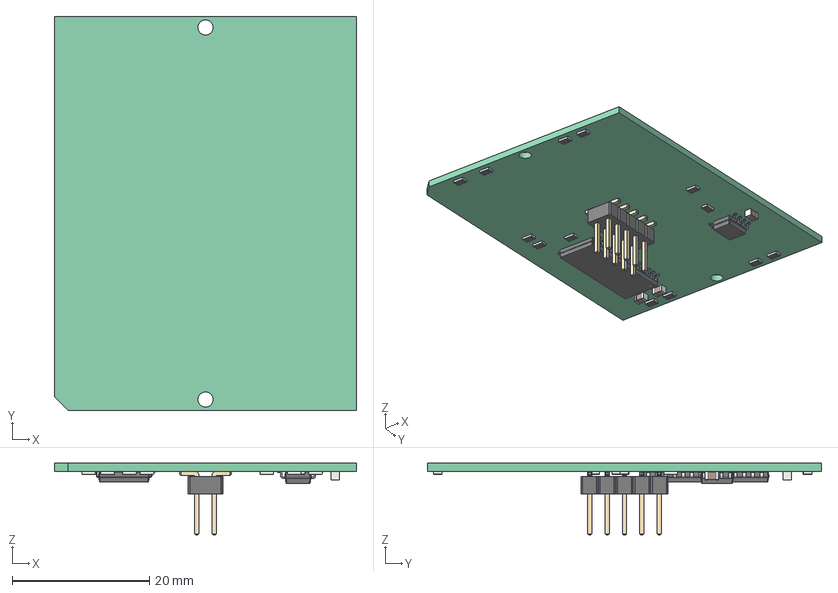
[picture p26: CAD file, 2024-06-04]
ETL/modules/tamale v1.5 Thermal Mockup/etl_module_pcb_thermal_mockup_v3.step
44.1 x 57.5 x 10.5 mm
Local_CS_a824
Pcb_a824
PCB_Sketch_a824
U6_SOIC_8_39x49mm_P127mm_2d7ca25d4c39
R13_R_0805_2012Metric_0bdda5f4ecf0 x 13
C2_C_0805_2012Metric_0e093ad6aa1c x 3
J3_PinHeader_2x05_P254mm_Vertical_SMD_8a7a4e189375
U5_SOIC_28W_75x187mm_P127mm_5574e2bc734c
