nebraska-silicon-lab/Hardware/General Gantry/Gantry Hub/Enclosure/Bottom.stp

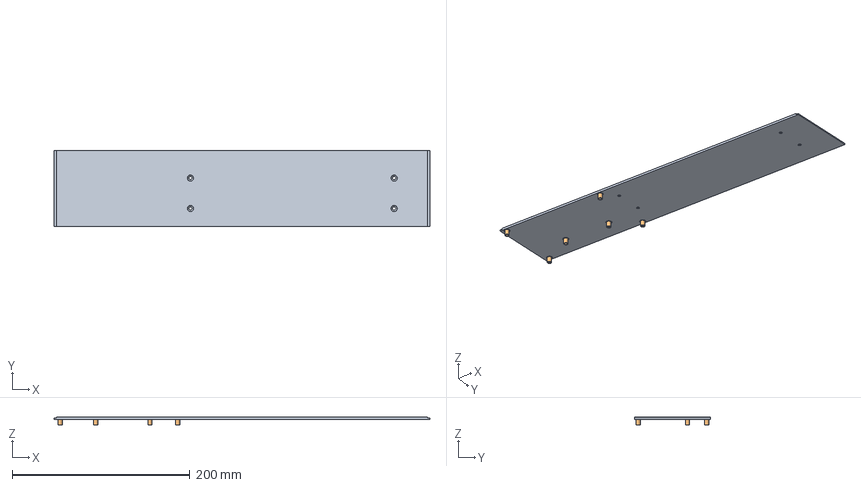
[picture p27: CAD file, 2024-06-12]
General Gantry/Gantry Hub/Enclosure/Bottom.stp
423.0 x 85.0 x 8.50 mm
