nebraska-silicon-lab/Hardware/General Gantry/Gantry Hub/Hub Router PCB/CUI_DEVICES_PJ-037A.step

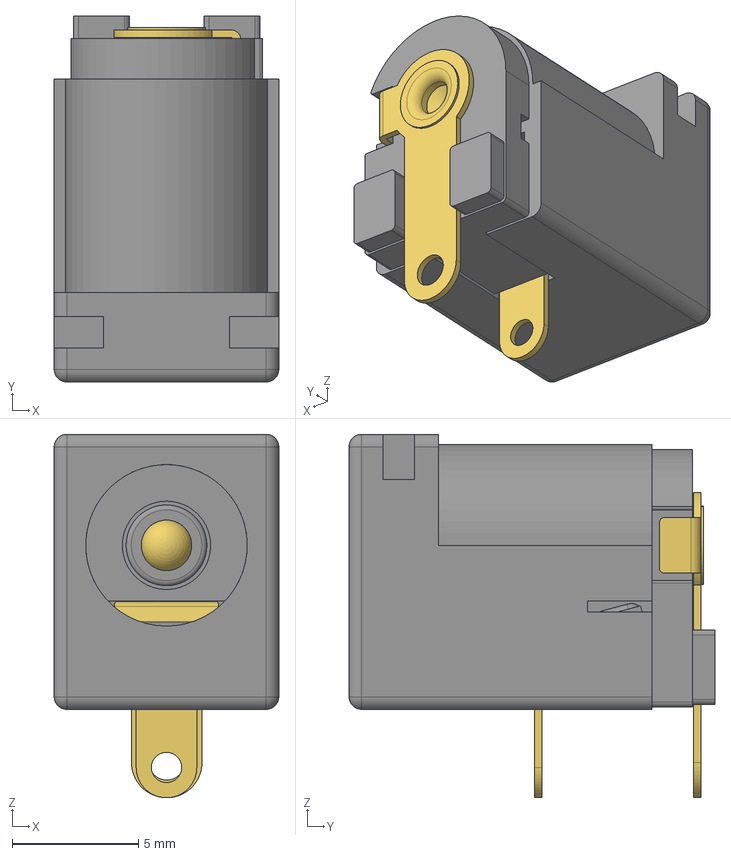
[picture p28: CAD file, 2024-06-12]
General Gantry/Gantry Hub/Hub Router PCB/CUI_DEVICES_PJ-037A.step
8.90 x 14.5 x 14.4 mm
