nebraska-silicon-lab/Hardware/General Gantry/Gantry Hub/R4JxxxxILFFx.stp

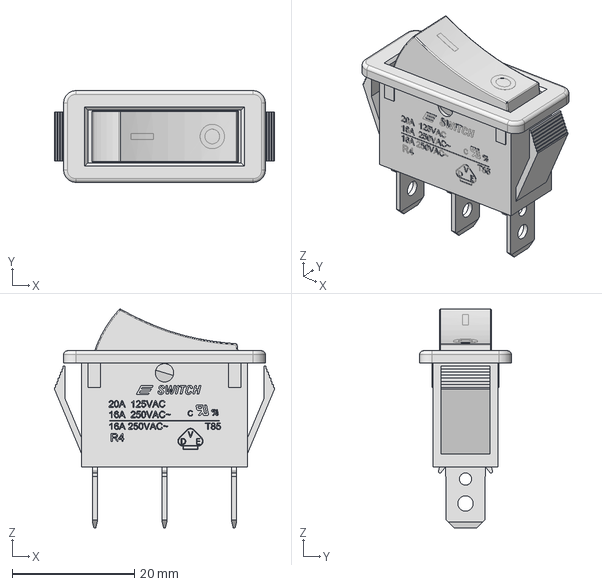
[picture p29: CAD file, 2024-06-12]
General Gantry/Gantry Hub/R4JxxxxILFFx.stp
36.0 x 15.0 x 35.8 mm
