nebraska-silicon-lab/Hardware/MilliQan/PMT Mounts/Slab Mount - 3D Printed - V1/pmtmountbottom.stp

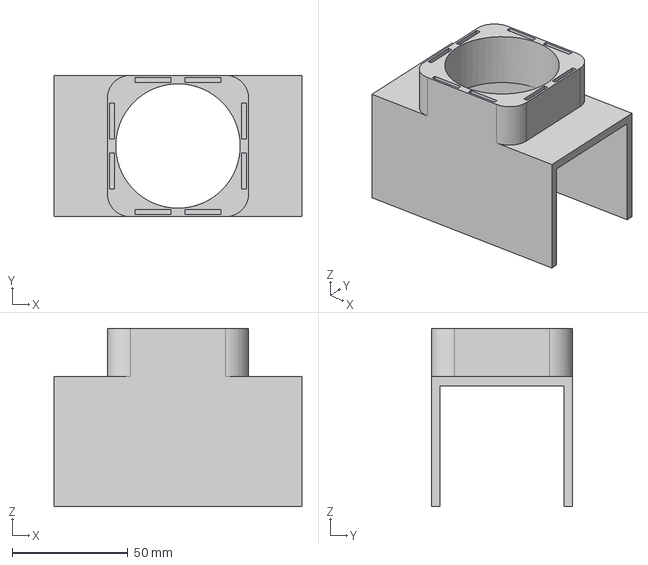
[picture p30: CAD file, 2021-11-08]
MilliQan/PMT Mounts/Slab Mount - 3D Printed - V1/pmtmountbottom.stp
107.0 x 61.0 x 76.8 mm
