nebraska-silicon-lab/Hardware/TFPX/Picker Tool/Platform A.stp

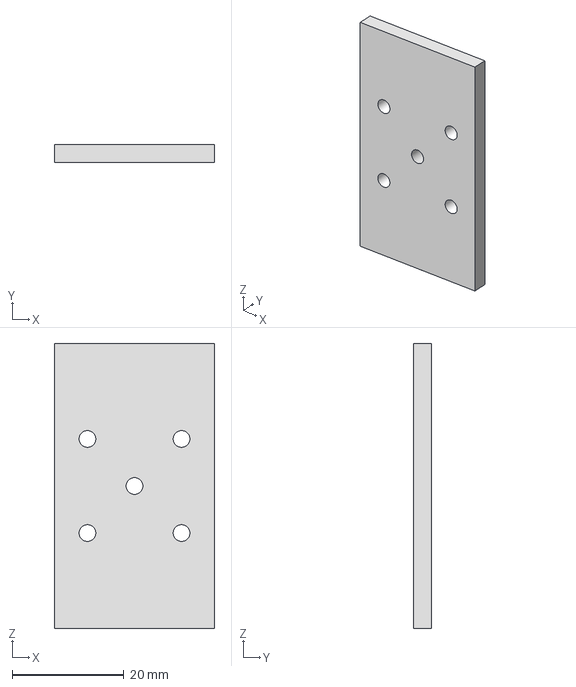
[picture p31: CAD file, 2022-04-20]
TFPX/Picker Tool/Platform A.stp
28.7 x 3.17 x 51.0 mm
