nebraska-silicon-lab/Hardware/ETL/Irradiation Fixture/Module Cradle V1.stp

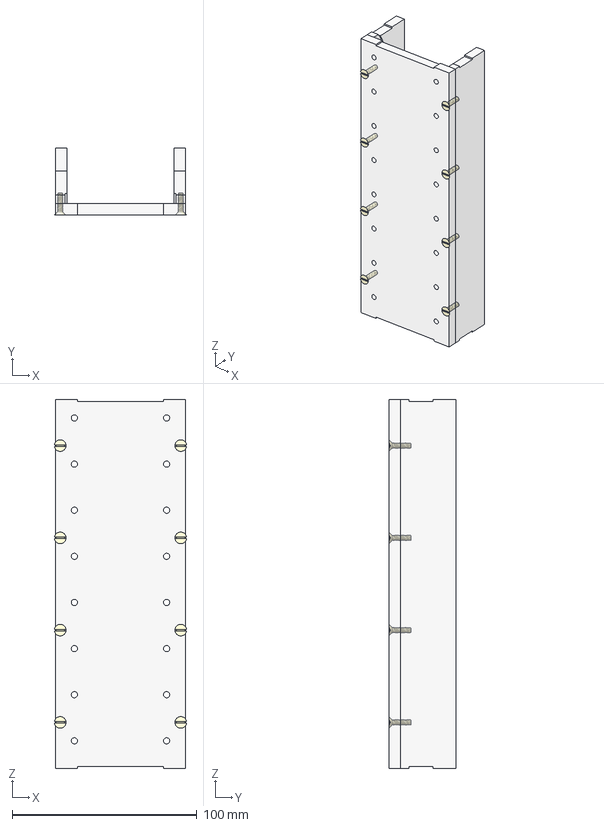
[picture p32: CAD file, 2024-06-04]
ETL/Irradiation Fixture/Module Cradle V1.stp
71.6 x 36.4 x 200.0 mm
Module Cradle Left V1
Base V1
Module Cradle Right V1
93840A122_Off-White Nylon Slotted Flat Head Screws x 8
