nebraska-silicon-lab/Hardware/ETL/modules/tamale v1.5 Thermal Mockup/Module Cover.stl

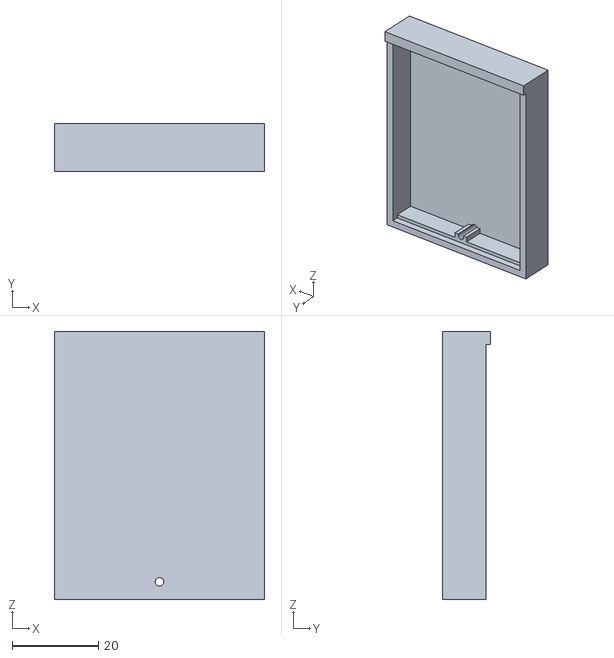
[picture p34: CAD file, 2024-06-04]
ETL/modules/tamale v1.5 Thermal Mockup/Module Cover.stl
48.6 x 11.0 x 62.0
