nebraska-silicon-lab/Hardware/General Gantry/Gantry Hub/178-037-513.STEP

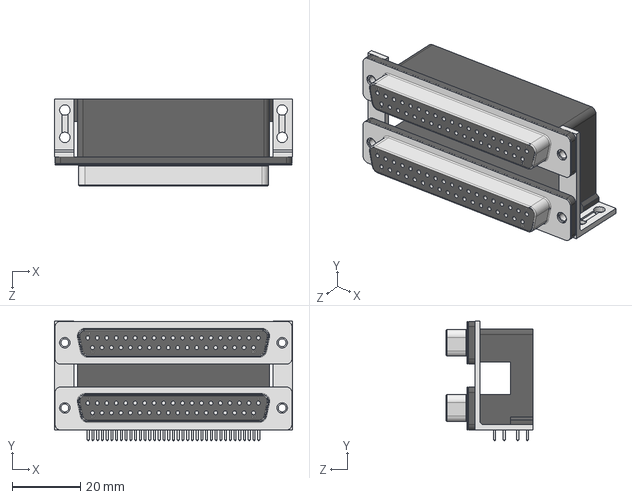
[picture p35: CAD file, 2024-06-12]
General Gantry/Gantry Hub/178-037-513.STEP
69.5 x 35.0 x 25.4 mm
