nebraska-silicon-lab/Hardware/General Gantry/Gantry Hub/Enclosure/Front.stp

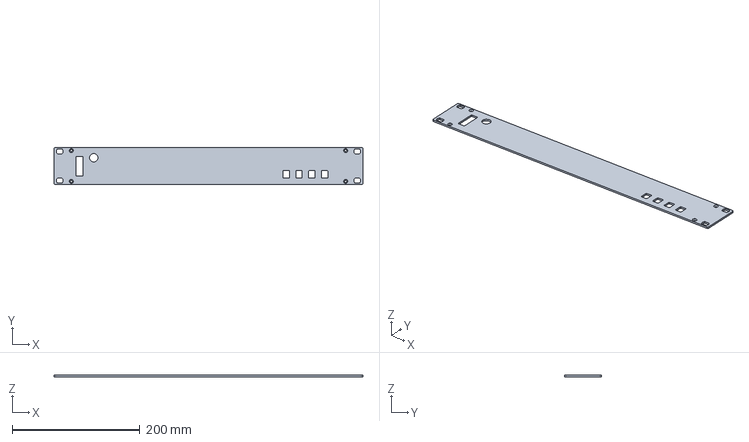
[picture p36: CAD file, 2024-06-12]
General Gantry/Gantry Hub/Enclosure/Front.stp
483.0 x 57.6 x 2.50 mm
