nebraska-silicon-lab/Hardware/MilliQan/PMT Mounts/Slab Mount - 3D Printed - V1/pmtmounttopmale.stp

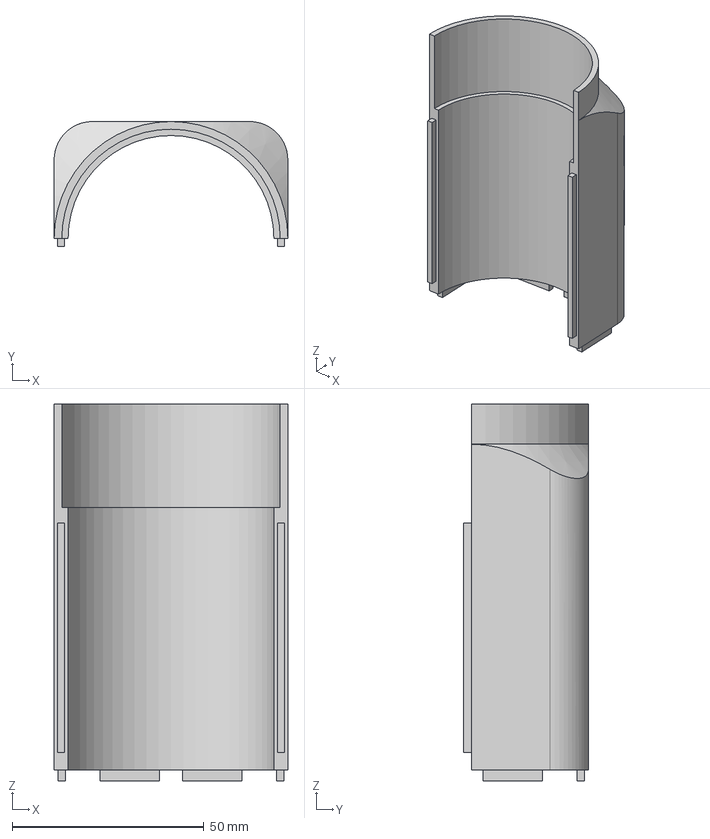
[picture p37: CAD file, 2021-11-08]
MilliQan/PMT Mounts/Slab Mount - 3D Printed - V1/pmtmounttopmale.stp
61.0 x 32.6 x 98.4 mm
