nebraska-silicon-lab/Hardware/TFPX/RD53a Gluing Form/RD53a Gluing Form V2.stl

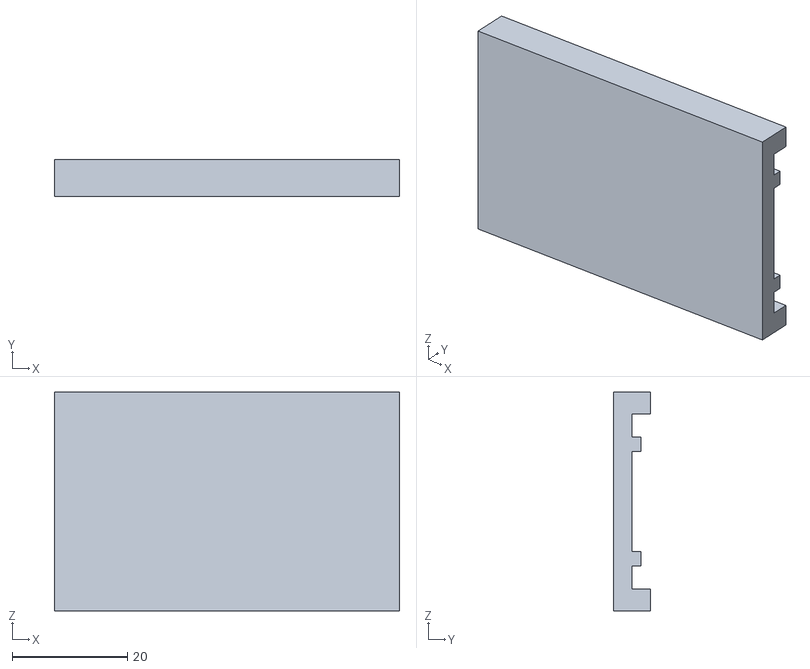
[picture p38: CAD file, 2023-07-11]
TFPX/RD53a Gluing Form/RD53a Gluing Form V2.stl
60.0 x 6.35 x 38.0
