nebraska-silicon-lab/Hardware/ETL/Irradiation Fixture/Module Holder Cover V1.stp

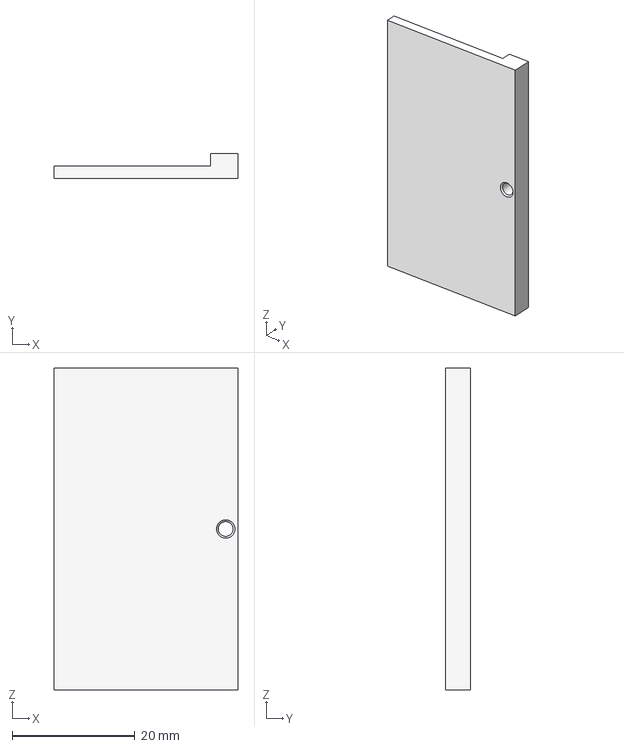
[picture p39: CAD file, 2024-06-04]
ETL/Irradiation Fixture/Module Holder Cover V1.stp
30.0 x 4.00 x 52.5 mm
