nebraska-silicon-lab/Hardware/ETL/Jigs/Sensor Mount Film Applicator - V2/Sensor Mount Film Stencil - V3.dxf

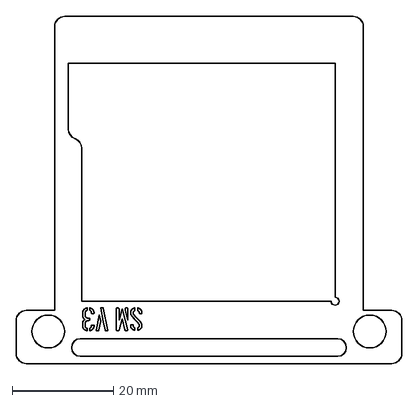
[picture p40: CAD file, 2023-07-11]
ETL/Jigs/Sensor Mount Film Applicator - V2/Sensor Mount Film Stencil - V3.dxf
76.2 x 68.6 mm
