nebraska-silicon-lab/Hardware/ETL/Module Assembly/Weight - V2/step/Weight Body.stp

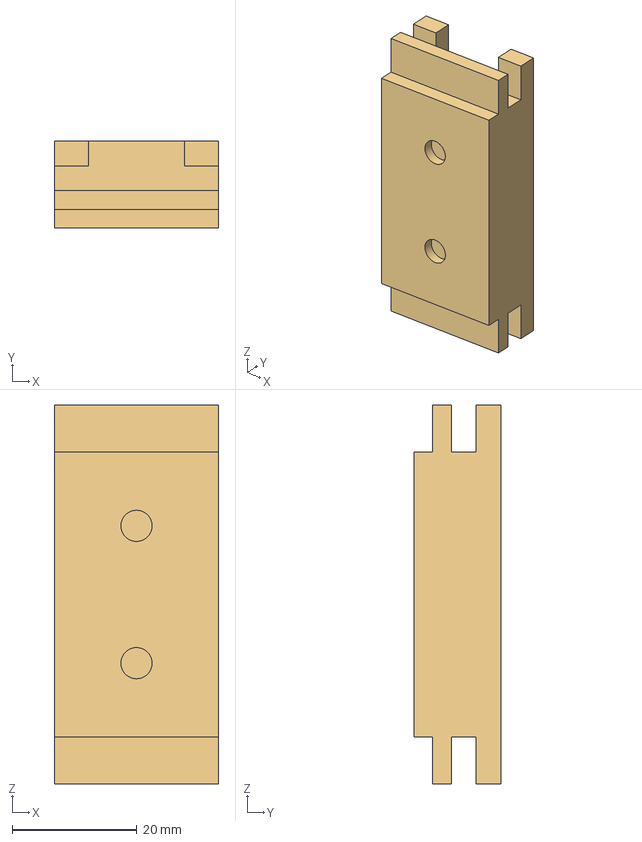
[picture p42: CAD file, 2021-07-19]
ETL/Module Assembly/Weight - V2/step/Weight Body.stp
26.3 x 14.0 x 60.7 mm
