nebraska-silicon-lab/Hardware/ETL/module_commissioning/TReTA/heater_foil.step

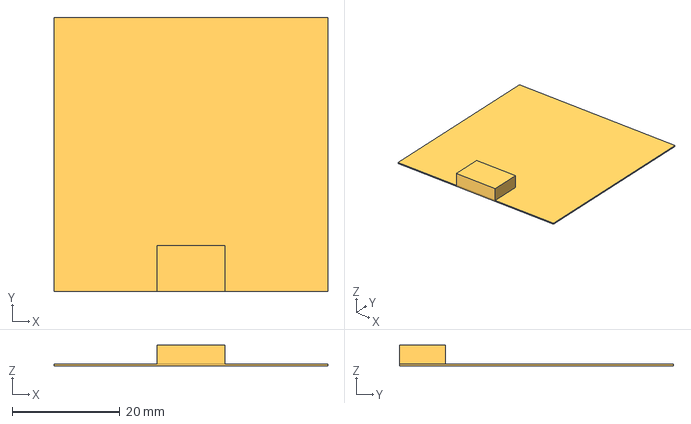
[picture p43: CAD file, 2020-09-22]
ETL/module_commissioning/TReTA/heater_foil.step
50.8 x 50.8 x 3.81 mm
