nebraska-silicon-lab/Hardware/ETL/modules/throughput mockups/Baseplate v1.5.dxf

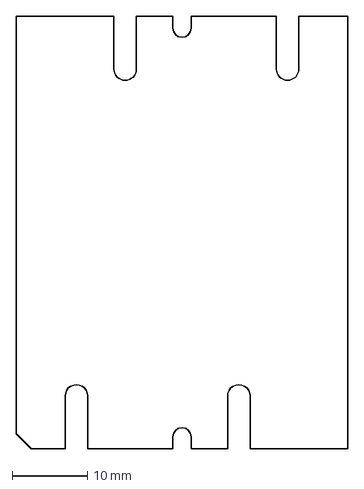
[picture p44: CAD file, 2023-03-06]
ETL/modules/throughput mockups/Baseplate v1.5.dxf
44.1 x 57.5 mm
