nebraska-silicon-lab/Hardware/General Gantry/FNAL Tool Holder Adapter/step/Tool Holder.stp

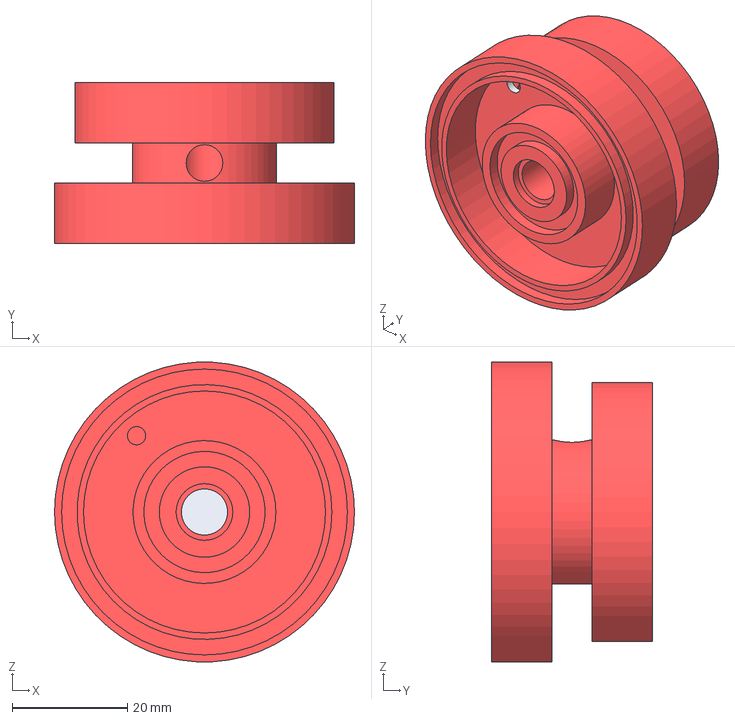
[picture p45: CAD file, 2021-05-21]
General Gantry/FNAL Tool Holder Adapter/step/Tool Holder.stp
52.1 x 27.9 x 52.0 mm
