nebraska-silicon-lab/Hardware/General Gantry/Gantry Hub/e_0870.0001i002.step

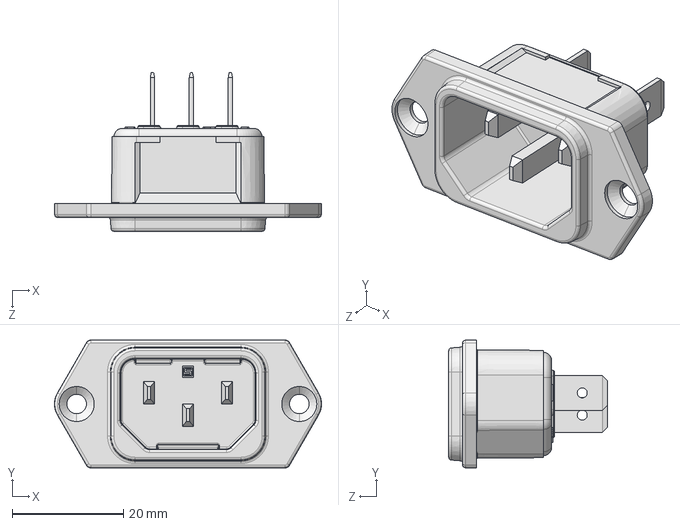
[picture p46: CAD file, 2024-06-12]
General Gantry/Gantry Hub/e_0870.0001i002.step
48.0 x 23.0 x 28.5 mm
