nebraska-silicon-lab/Hardware/General Gantry/Gantry Hub/Enclosure/Back.stp

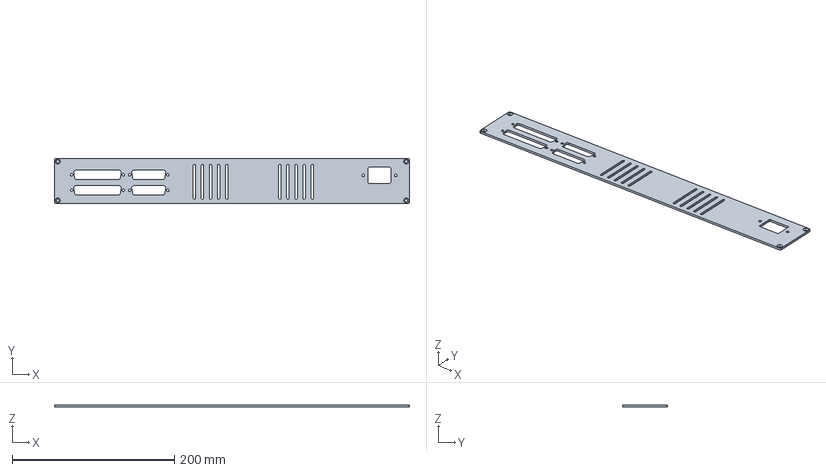
[picture p47: CAD file, 2024-06-12]
General Gantry/Gantry Hub/Enclosure/Back.stp
437.0 x 56.0 x 2.50 mm
