nebraska-silicon-lab/Hardware/General Gantry/Hose Clamp/Hose Clamp.stl

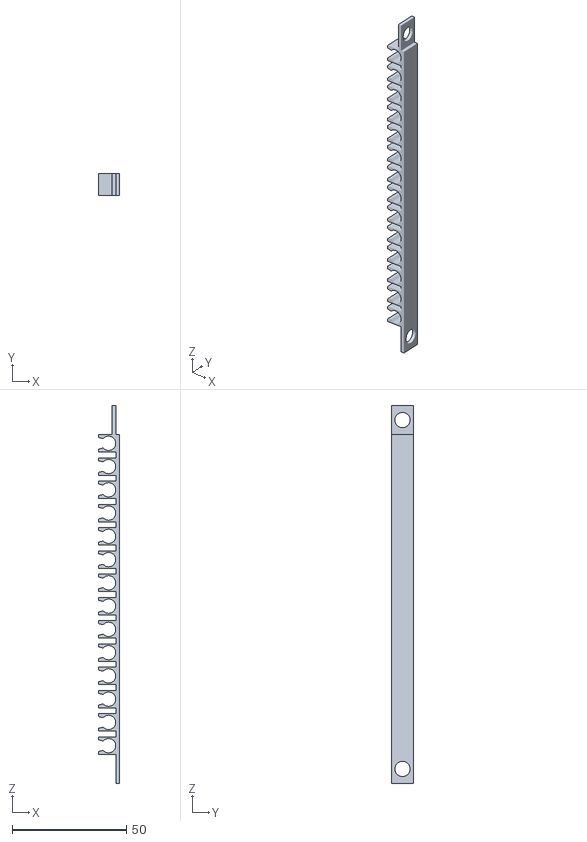
[picture p48: CAD file, 2023-06-12]
General Gantry/Hose Clamp/Hose Clamp.stl
9.14 x 9.52 x 165.1
