nebraska-silicon-lab/Hardware/MilliQan/PMT Mounts/Slab Mount - 3D Printed - V1/pmtmounttopfemale.stp

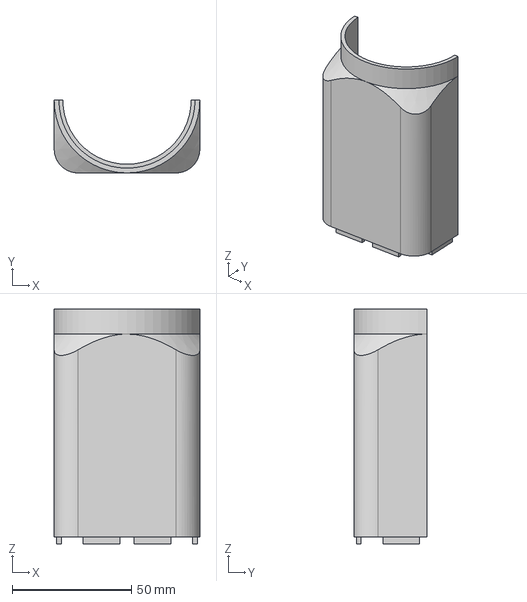
[picture p49: CAD file, 2021-11-08]
MilliQan/PMT Mounts/Slab Mount - 3D Printed - V1/pmtmounttopfemale.stp
61.0 x 30.5 x 98.4 mm
