nebraska-silicon-lab/Hardware/Pull Tester/step_56336.step

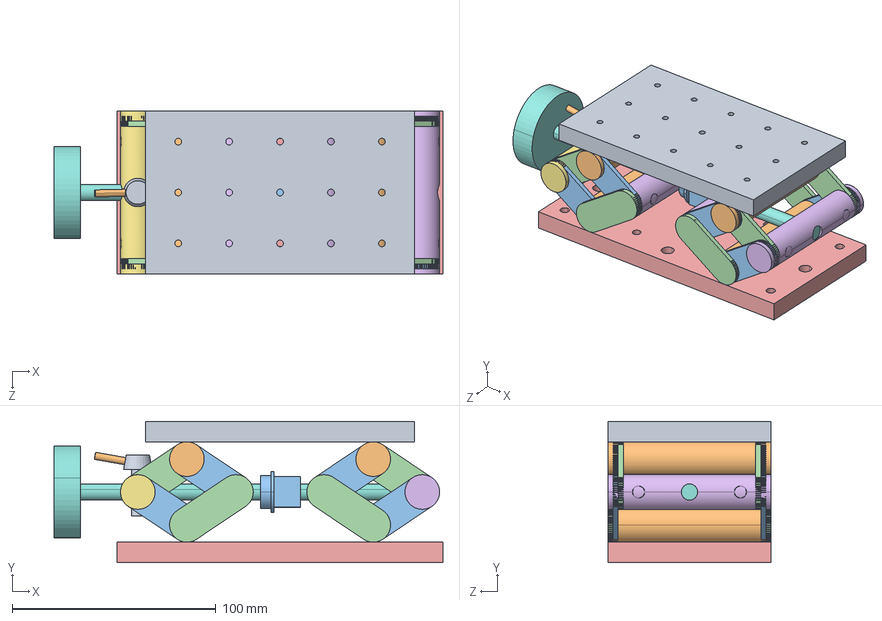
[picture p50: CAD file, 2022-01-28]
Pull Tester/step_56336.step
191.0 x 69.3 x 80.0 mm
