nebraska-silicon-lab/Hardware/ETL/module_commissioning/TReTA/thermister.step

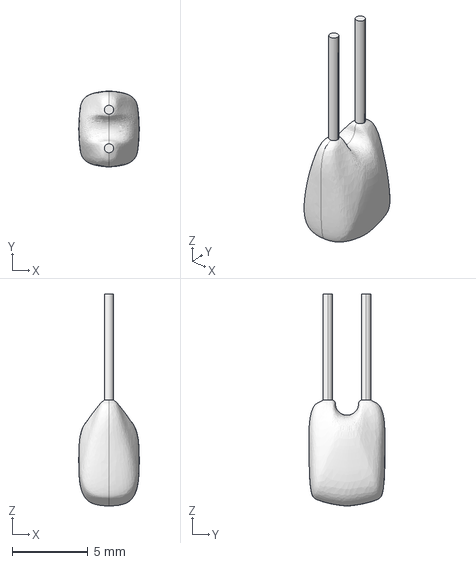
[picture p51: CAD file, 2020-09-22]
ETL/module_commissioning/TReTA/thermister.step
4.00 x 5.01 x 14.0 mm
