nebraska-silicon-lab/Hardware/General Gantry/Gantry Hub/178-025-513.STEP

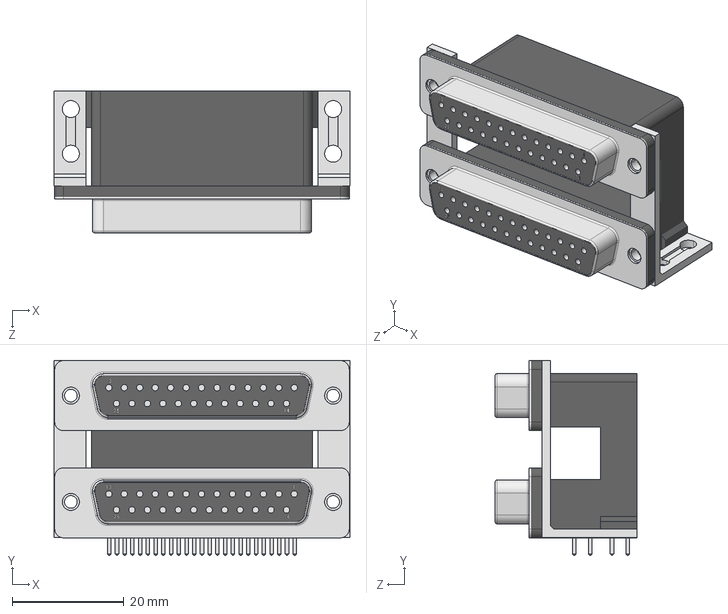
[picture p52: CAD file, 2024-06-12]
General Gantry/Gantry Hub/178-025-513.STEP
53.0 x 35.0 x 25.4 mm
