nebraska-silicon-lab/Hardware/General Gantry/Hose Clamp/Hose Clamp V3.stl

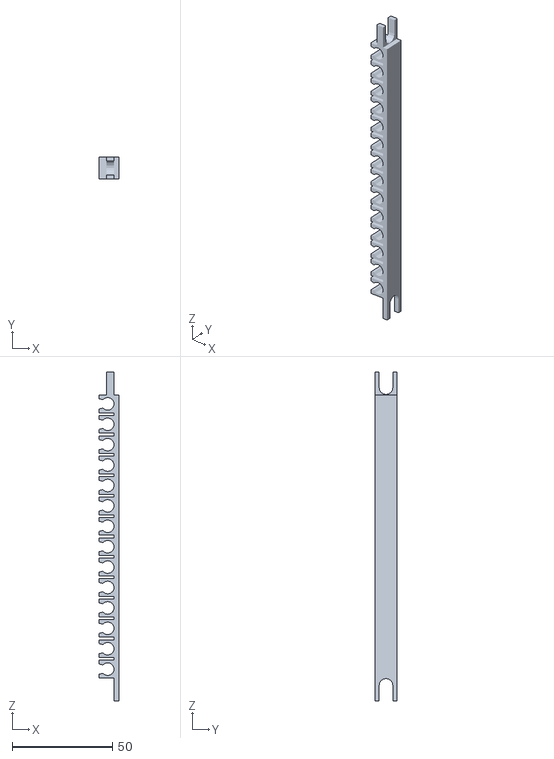
[picture p53: CAD file, 2023-06-12]
General Gantry/Hose Clamp/Hose Clamp V3.stl
10.1 x 11.1 x 163.8
