nebraska-silicon-lab/Hardware/ETL/Irradiation Fixture/Module Holder V1.stp

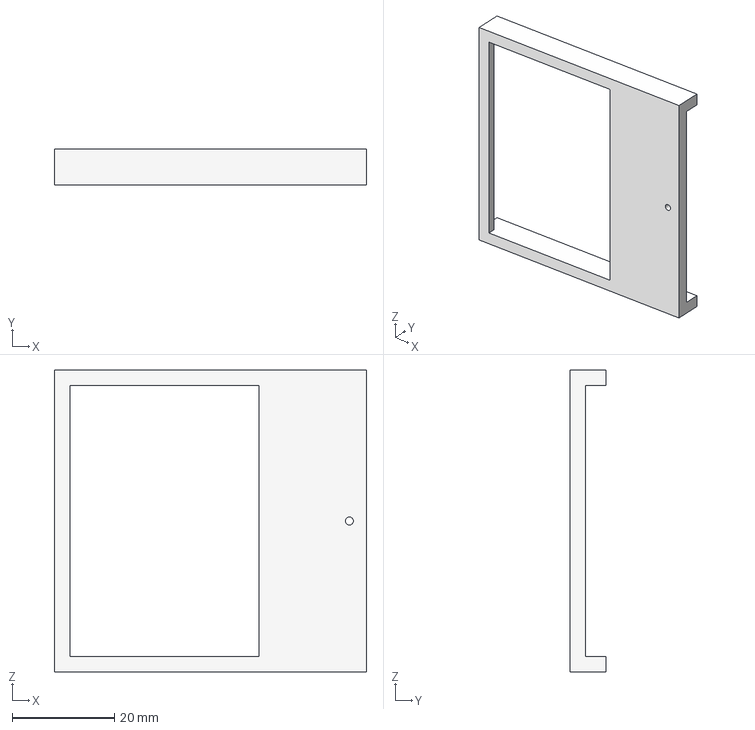
[picture p54: CAD file, 2024-06-04]
ETL/Irradiation Fixture/Module Holder V1.stp
61.0 x 7.00 x 59.0 mm
