nebraska-silicon-lab/Hardware/ETL/module_commissioning/TReTA/cold_plate_bottom.step

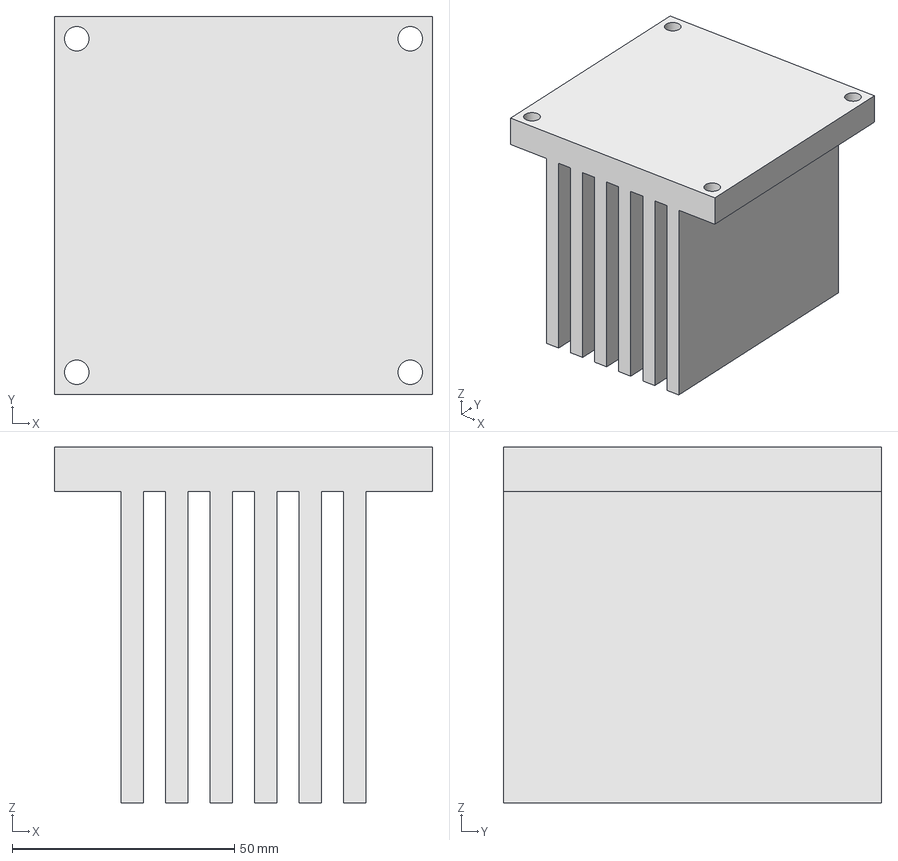
[picture p55: CAD file, 2020-09-22]
ETL/module_commissioning/TReTA/cold_plate_bottom.step
85.0 x 85.0 x 80.0 mm
