nebraska-silicon-lab/Hardware/ETL/module_commissioning/TReTA/thermal_cond_tester.step

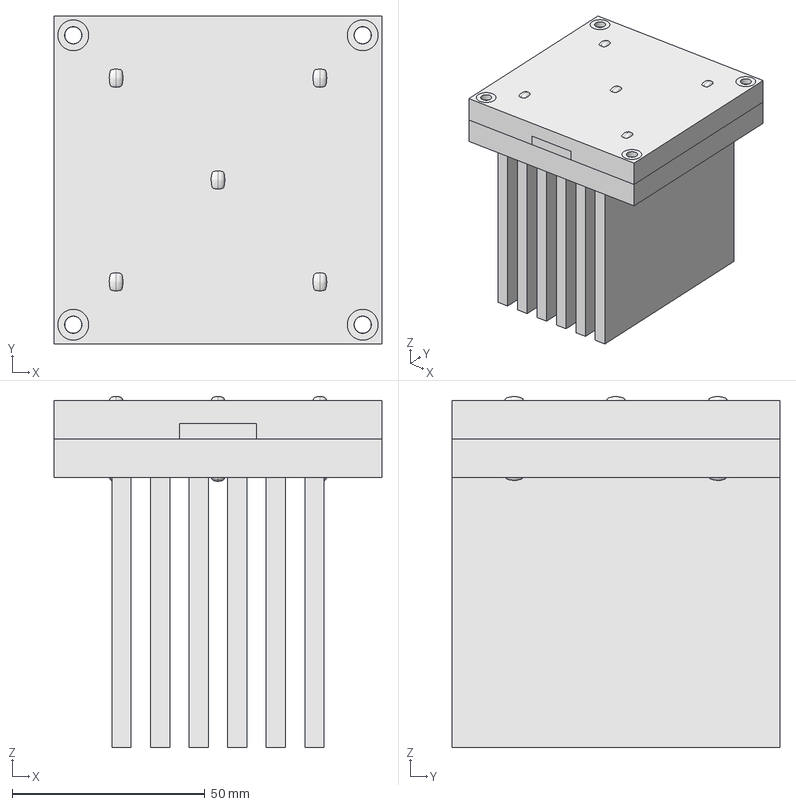
[picture p56: CAD file, 2020-09-22]
ETL/module_commissioning/TReTA/thermal_cond_tester.step
85.0 x 85.0 x 91.0 mm
Heater_Foil
Hot_Plate_Top
Hot_Plate_Bottom
Thermister_1
Thermister_2
Thermister_3
Thermister_4
Thermister_5
Cold_Plate_Top
Thermistor_6
Thermistor_7
Thermistor_8
Thermistor_9
Thermistor_10
Cold_Plate_Bottom
