nebraska-silicon-lab/Hardware/(list of files, cad)

Other CAD files:
ETL/Module Assembly/Assembly Plate - boss mounting/Assembly Plate - boss mounting.dwg
ETL/Module Assembly/Assembly Plate/Assembly Plate.dwg
ETL/Module Assembly/Chuck - OctopocketF/Chuck - OctopocketF.stp
ETL/modules/throughput mockups/throughput mockups/Templates/English/ANSI (in).dwg
ETL/modules/throughput mockups/throughput mockups/Templates/Metric/DIN.dwg
ETL/modules/throughput mockups/throughput mockups/Templates/standard.dwg
MilliQan/Slab Templates/Slab Template- 1 piece v2.step
TFPX/dry air cabinet/Phase II/bigcab-shelf_layout.FCStd
Wirebonder/Chuck.dwg
ETL/module_commissioning/TReTA/cold_plate_top.step
ETL/modules/throughput mockups/throughput mockups/Baseplate v1.5.dwg
ETL/modules/throughput mockups/throughput mockups/Templates/Metric/JIS.dwg
ETL/modules/throughput mockups/wbp.dwg
MilliQan/Slab Templates/Slab Template- 3 piece v2.step
ETL/modules/throughput mockups/throughput mockups/Templates/Metric/ISO.dwg
ETL/modules/throughput mockups/throughput mockups/Templates/Metric/BSI.dwg
ETL/modules/throughput mockups/throughput mockups/Templates/Metric/GOST.dwg
ETL/modules/throughput mockups/throughput mockups/Templates/Metric/GB.dwg
ETL/module_commissioning/TReTA/hot_plate_top.step
ETL/modules/throughput mockups/throughput mockups/Templates/Metric/ANSI (mm).dwg
ETL/FNAL Gantry/F10129268--_1-ASSY_ CMS2 ETL_ SMALLER AEROTECH GANTRY TOP LEVEL ASSEMBLY __ES13805-1__stp.iam
ETL/FNAL Gantry/F10129269--_1-GANTRY_ CMS2 ETL_ SMALLER AEROTECH GANTRY __ES13805-1_.ipt
ETL/FNAL Gantry/F10129270--_1-ASSY_ CMS2 ETL_ CAMERA MOUNT FIXTURE ASSEMBLY_MODEL.iam
ETL/FNAL Gantry/F10129271--_1-MOTOR_ AEROTECH_ Z-AXIS STEPPER MOTOR __ATS100-100-TT2-LI1_.ipt
ETL/FNAL Gantry/F10129272--_1-MOTOR_ AEROTECH_ THETA-AXIS STEPPER MOTOR __BMS100_.ipt
ETL/FNAL Gantry/F10129333--_1-FIXTURE_ AEROTECH_ THETA MOTOR MOUNTING FIXTURE.ipt
ETL/FNAL Gantry/F10129334--_1-REACH_ CMS2 ETL_ SMALLER AEROTECH GANTRY REACHOUT.ipt
ETL/FNAL Gantry/F10129608--_1-FIXTURE_ CMS2 ETL_ CAMERA MOUNT FIXTURE1.ipt
ETL/FNAL Gantry/F10129609--_1-FIXTURE_ CMS2 ETL_ CAMERA MOUNT FIXTURE2.ipt
ETL/FNAL Gantry/F10129610--_1-FIXTURE_ CMS2 ETL_ CAMERA MOUNT FIXTURE3.ipt
ETL/FNAL Gantry/FC0005855--_1-SHCS_M3x.5x8LGxFT_SS18-8.ipt
ETL/FNAL Gantry/FC0005871--_1-SHCS_M4x.7x8LGxFT_SS18-8.ipt
ETL/FNAL Tooling Designs/Chuck/F10112938--_1-MODULE_ CMS2 ETL_ SENSOR COVER PLT.ipt
ETL/FNAL Tooling Designs/Chuck/F10129336--_1-ASSY_ CMS2 ETL_ AL-N BASEPLATE HOLDING ASSEMBLY.stp
ETL/FNAL Tooling Designs/Chuck/F10129572--_1-FIXTURE_ CMS2 ETL_ AL-N BASEPLATE HOLDING BASE FIXTURE1.stp
ETL/FNAL Tooling Designs/Chuck/F10129574--_1-FIXTURE_ CMS2 ETL_ AL-N BASEPLATE HOLDING TOP FIXTURE2.stp
ETL/FNAL Tooling Designs/Chuck/F10129575--_1-FIXTURE_ CMS2 ETL_ VACUUM CHUCK- SENSOR PACKAGE TOP FIXTURE.ipt
ETL/FNAL Tooling Designs/Chuck/F10129575--_1-FIXTURE_ CMS2 ETL_ VACUUM CHUCK- SENSOR PACKAGE TOP FIXTURE.stp
ETL/FNAL Tooling Designs/Chuck/F10129576--_1-FIXTURE_ CMS2 ETL_ VACUUM CHUCK- SENSOR PACKAGE BASE FIXTURE.ipt
ETL/FNAL Tooling Designs/Chuck/F10129576--_1-FIXTURE_ CMS2 ETL_ VACUUM CHUCK- SENSOR PACKAGE BASE FIXTURE.stp
ETL/FNAL Tooling Designs/Chuck/F10129577--_1-ASSY_ CMS2 ETL_ VACUUM CHUCK- SENSOR PACKAGE ASSY.iam
ETL/FNAL Tooling Designs/Chuck/F10129577--_1-ASSY_ CMS2 ETL_ VACUUM CHUCK- SENSOR PACKAGE ASSY.stp
ETL/FNAL Tooling Designs/Chuck/FC0043161--_1-FITTING_ BARBED ADAPTER ELBOW_ 1_8 ID TUBE TO _10-32.ipt
ETL/FNAL Tooling Designs/Chuck/FC0043485--_1-DOWEL PIN_M6ODx16LG_AS.ipt
ETL/FNAL Tooling Designs/Chuck/FC0067267--_1-THUMB SCREW_ M3_0.5_ 16MM LG_ MCMASTER 9601A058.ipt
ETL/FNAL Tooling Designs/Gantry - Glue Reservoir/F10132544--_1-FIXTURE_ CMS2 ETL_ GLUE RESERVOIR FIXTURE.stp
ETL/FNAL Tooling Designs/Gantry - Glue Reservoir/F10132545--_1-ASSY_ CMS2 ETL_ GLUE RESERVOIR ASSY.stp
ETL/Irradiation Fixture/91420A003_Steel Phillips Flat Head Screws/91420A003_Steel Phillips Flat Head Screws.ipt
ETL/Irradiation Fixture/93840A122_Off-White Nylon Slotted Flat Head Screws/93840A122_Off-White Nylon Slotted Flat Head Screws.ipt
ETL/Irradiation Fixture/Beam Profile.ipt
ETL/Irradiation Fixture/Glass Slide Spacer V1.ipt
ETL/Irradiation Fixture/Irradiation Fixture V1.iam
ETL/Irradiation Fixture/Kapton Cover.ipt
ETL/Irradiation Fixture/Module Cradle Base V1.ipt
ETL/Irradiation Fixture/Module Cradle Left V1.ipt
ETL/Irradiation Fixture/Module Cradle Right V1.ipt
ETL/Irradiation Fixture/Module Cradle V1.dwg
ETL/Irradiation Fixture/Module Cradle V1.iam
ETL/Irradiation Fixture/Module Cradle V1.ipn
ETL/Irradiation Fixture/Module Holder Cover V1.ipt
ETL/Irradiation Fixture/Module Holder Full Cover V1.ipt
ETL/Irradiation Fixture/Module Holder Full V1.ipt
ETL/Irradiation Fixture/Module Holder V1.ipt
ETL/Irradiation Fixture/Module with Cover V1.iam
ETL/Irradiation Fixture/Module with Full Cover V1.iam
ETL/Jigs/FNAL - V1/F10148122--_1-ASSY_ CMS2 ETL_ SENSOR _ FLEX FILMS MONUTING ASSY.stp
ETL/Jigs/FNAL - V1/F10148123--_1-FIXTURE_ CMS2 ETL_ AL-N BASE HOLDING FIXTURE.stp
ETL/Jigs/FNAL - V1/F10148124--_1-FIXTURE_ CMS2 ETL_ SENSOR FILM HOLDING FIXTURE.stp
ETL/Jigs/FNAL - V1/F10148125--_1-ASSY_ CMS2 ETL_ SENSOR FILM HOLDING FIXTURE ASSY.stp
ETL/Jigs/FNAL - V1/F10161928--_1-FIXTURE_ CMS2 ETL_ 16X16 SENSOR SUB-ASSY ALIGNMENT FIXTURE.stp
ETL/Jigs/FNAL - V1/F10161929--_1-PIN_ CMS2 ETL_ 16X16 FIXTURE ALIGNMENT PIN.stp
ETL/Jigs/FNAL - V1/F10161930--_1-FIXTURE_ CMS2 ETL_ 16X16 FIXTURE VACUUM BACKPLATE.stp
ETL/Jigs/FNAL - V1/F10161931--_1-ASSY_ CMS2 ETL_ 16X16 SENSOR-SUB ASSY ALIGNMENT FIXTURE ASSY.stp
ETL/Jigs/FNAL - V1/F10161932--_1-ASSY_ CMS2 ETL_ 16X16 SENSOR SUB-ASSY TO Al-N GLUING ASSY.stp
ETL/Jigs/FNAL - V1/F10161944--_1-FIXTURE_ CMS2 ETL_ 16X16 COVERPLATE ALIGNMENT FIXTURE.stp
ETL/Jigs/FNAL - V1/F10161945--_1-FIXTURE_ CMS2 ETL_ 16X16 COVERPLATE FILM HOLDING FIXTURE.stp
ETL/Jigs/FNAL - V1/F10161947--_1-ASSY_ CMS2 ETL_ 16X16 COVERPLATE ALIGNMENT FIXTURE ASSY.stp
ETL/Jigs/FNAL - V1/F10161948--_1-ASSY_ CMS2 ETL_ 16X16 SENSOR SUB-ASSY TO COVERPLATE GLUING ASSY.stp
ETL/Jigs/FNAL - V1/F10161949--_1-ASSY_ CMS2 ETL_ 16X16 COVERPLATE FILM HOLDING FIXTURE ASSY.stp
ETL/Jigs/FNAL - V1/F10161950--_1-ASSY_ CMS2 ETL_ 16X16 SENSOR SUB-ASSY TO COVERPLATE FILM GLUING ASSY.stp
ETL/Jigs/Sensor Mount Film Applicator - V1/51025K323_Brass Push-to-Connect Tube Fitting for Air.ipt
ETL/Jigs/Sensor Mount Film Applicator - V1/91099A104_Passivated 18-8 Stainless Steel Phillips Flat Head Screw.ipt
ETL/Jigs/Sensor Mount Film Applicator - V1/91772A238_Passivated 18-8 Stainless Steel Pan Head Phillips Screw.ipt
ETL/Jigs/Sensor Mount Film Applicator - V1/Base - V1.ipt
ETL/Jigs/Sensor Mount Film Applicator - V1/Baseplate Film Stencil - V1.dxf
ETL/Jigs/Sensor Mount Film Applicator - V1/Baseplate Film Stencil - V1.ipt
ETL/Jigs/Sensor Mount Film Applicator - V1/Hinge - V1.ipt
ETL/Jigs/Sensor Mount Film Applicator - V1/Module PCB Stencil - V1-1.dwg
ETL/Jigs/Sensor Mount Film Applicator - V1/Module PCB Stencil - V1.dxf
ETL/Jigs/Sensor Mount Film Applicator - V1/Module PCB Stencil - V1.ipt
ETL/Jigs/Sensor Mount Film Applicator - V1/Pin - V1.ipt
ETL/Jigs/Sensor Mount Film Applicator - V1/Sensor Mount Film Applicator - V1.iam
ETL/Jigs/Sensor Mount Film Applicator - V1/Sensor Mount Film Stencil - V1.dxf
ETL/Jigs/Sensor Mount Film Applicator - V1/Sensor Mount Film Stencil - V1.ipt
ETL/Jigs/Sensor Mount Film Applicator - V1/Stencil Clamp - V1.ipt
ETL/Jigs/Sensor Mount Film Applicator - V1/Top - V1.ipt
ETL/Jigs/Sensor Mount Film Applicator - V2/3766A81_Extreme-Temperature Food Industry Vacuum Cup.STEP
ETL/Jigs/Sensor Mount Film Applicator - V2/3766A81_Extreme-Temperature Food Industry Vacuum Cup.ipt
ETL/Jigs/Sensor Mount Film Applicator - V2/51025K323_Brass Push-to-Connect Tube Fitting for Air.ipt
ETL/Jigs/Sensor Mount Film Applicator - V2/91099A104_Passivated 18-8 Stainless Steel Phillips Flat Head Screw.ipt
ETL/Jigs/Sensor Mount Film Applicator - V2/91251A168_Black-Oxide Alloy Steel Socket Head Screw.STEP
ETL/Jigs/Sensor Mount Film Applicator - V2/91251A168_Black-Oxide Alloy Steel Socket Head Screw.ipt
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
