nebraska-silicon-lab/Hardware/Work Orders/2023_04_ETL_Tamale-Assembly-Plate-V5.pdf

© 2004-2013 University of Nebraska-Lincoln Physics and Astronomy Department

### Equipment Name:

QTY | Unit Cost | Total Cost

Comments:

Materials

Bob Rhynalds rrhynalds@unl.edu 177 JH 0299

## Instrument Shop Billing

### Daily Work Log

Chemistry and Physics & Astronomy | Name | Date | Hrs.

472-2780

Cost Object | Department | Today's Date
26-0521-0189-002 M&S 26-0521-0189-003 labor | Physics & Astronomy | 4/18/2023
Requested by | Requestor's Phone | Requestors email
Caleb Fangmeier | 402 768 1358 | cfangmeier3@unl.edu
Requestor's Supervisor | Supervisor's Phone | Supervisor's Dept.
Frank Golf | | Physics & Astronomy

Revised 18 Jan. 2013

Total Hours:

Fabrication of 1 Tamale Assembly Plate V5

### Work Instructions:

### Total Material Cost:

Date Billed: | Total Hours: | SAP#
Total Materials:
