nebraska-silicon-lab/Hardware/(threads)

Thread 1 (2020-07-22):

Dry Air Cabinet

cfangmeier, 2020-07-22:
Require a cabinet providing dry storage for ETL and TFPX modules.

The proposed design consists of two boxes, each with dimensions of 21"x24"x18" (height x width x depth). Each box will have its own dry air intake and support 7 drawers with nominal 2 5/8" separation. The top drawer in each unit will be taller to accommodate taller objects. The drawers should be mounted on slides to allow easy access to the whole drawer. The entire body and shelves should be electrically grounded to eliminate the risk of electrostatic shock.

cfangmeier, 2020-08-24:
The shelves for the cabinet have been fabricated and delivered. They are currently in the instrument shop.

cfangmeier, 2020-12-07:
The cabinet body has been assembled. Next steps are constructing and mounting the doors.

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

cfangmeier, 2020-12-16:
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

Doors mounted on dry air cabinet

cfangmeier, 2021-01-19:
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

Closed 2021-01-19.

Thread 2 (2020-07-22):

Tool Holder Assembly and Adapter

cfangmeier, 2020-07-22:
To be fabricated as per the designs in [here](https://github.com/nebraska-silicon-lab/CAD/tree/master/General%20Gantry/Gantry%20Tool%20Holder) with the following modifications:

  - Remove the dispenser holder and dispenser holder arm
  - Remove the microswitches
  - The `ToolHolderSpool` and the `ToolHolderSlug` can be combined into a single piece.
  - The barb supplying the inner vacuum should be shifted to be more easily accessible and the same size as the other barb.

cfangmeier, 2020-07-29:
The updated CAD drawing of the tool holder has been uploaded.

https://github.com/nebraska-silicon-lab/CAD/tree/master/General%20Gantry/Gantry%20Tool%20Holder%20-%20Phase%20II

cfangmeier, 2020-09-16:
The tool holder assembly is finished except for taping the bolt holes. The adapter assembly has not been started yet (but is next in line).

cfangmeier, 2020-09-25:
The tool holder and adapter have been finished and are installed on the gantry

Closed 2020-09-25.

Thread 3 (2020-07-22):

Tool Rack

cfangmeier, 2020-07-22:
To be fabricated as per the [designs](https://github.com/nebraska-silicon-lab/CAD/tree/master/General%20Gantry/Gantry%20Tool%20Rack).

cfangmeier, 2020-09-16:
The tool rack is finished. However, the spring-pins that the tools rest on still need to be ordered and installed. Bob has the part numbers and will order them.

cfangmeier, 2020-09-22:
The Tool rack is finished and installed on the gantry table. However, the spring-pins that were specified in the original drawing are too tall which results in the tools not sitting properly in the rack. Will need to replace with shorter ones.

Closed 2020-10-22.

Thread 4 (2020-07-22):

ETL Prototype Chuck

cfangmeier, 2020-07-22:
Have a chuck made as per the drawings [here](https://github.com/nebraska-silicon-lab/CAD/tree/master/ETL/Chuck)

cfangmeier, 2021-01-13:
The design has been changed. The new design is here: https://github.com/nebraska-silicon-lab/CAD/tree/master/ETL/Module%20Assembly/Chuck

cfangmeier, 2021-02-05:
[final design](https://github.com/nebraska-silicon-lab/Hardware/tree/master/ETL/Module%20Assembly/Chuck)

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

2 chucks are on order.

cfangmeier, 2021-02-19:
2 Chucks delivered. Need to install vacuum fittings to finish. I will order them.
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

Closed 2021-02-19.

Thread 5 (2020-07-29):

ETL Cooling Plate Section

cfangmeier, 2020-07-29:

cfangmeier, 2020-08-26:
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

The plate and tube have been fabricated and holes drilled to support single-side mounting of modules. The modules that will be mounted on the reverse-side will be shifted 50% of their width and will require additional mounting holes.

fgolf, 2020-08-26:
We want the holes on the other (let's call it front) side to be a mirror image of what is here, i.e. the holes shown (back side) have a row of modules along the top and bottom with a service hybrid in between.  The holes on the other (front) side would mount a row of modules shadowing the service hybrid on the back side and rows of service hybrids shadowing the modules on the back side.

cfangmeier, 2020-12-07:
The Plates were glued together today. Below image shows the glue application

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

Keith notes:

> There are a few small areas with no glue dots. I used a q-tip and added some small dots by hand in those areas to hopefully have even coverage.

After applying the glue, Keith filled in any remaining voids around the pipe with thermal paste before placing the top piece and weighing the whole thing down.

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

cfangmeier, 2020-12-10:
I retrieved the plate from the shop. Shown below is the plate staged with 1 service hybrid and 12 modules, of which 4 currently have heaters and only one has the heater glued on.

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

One issue I discovered with the service-hybrid is that when I adjusted the design to use some better connectors I accidentally removed the mounting holes (Dang EDA software!). To compensate for this, we can drill holes through the PCBs ourselves, but will need to use non-conductive screws to avoid shorting out the board. Something in the ballpark of [1] should work. I don't think this will dramatically reduce the usefulness of this mockup because (1) we are more concerned with the modules than the service hybrid and (2) most of the cooling is happening through the PCB-disc contact area, not through the mounting screws.

[1] https://www.mcmaster.com/screws/head-type~socket/material~plastic/

Closed 2020-12-10.

Thread 6 (2020-08-24):

Gel-pak Vacuum Release

cfangmeier, 2020-08-24:
The [gel-pak holders](https://www.si-cnx.com/products/microelectronics-packaging/vacuum-release-tray/) that we routinely use to ship and store silicon pieces require a vacuum base to easily release their cargo. The shop will produce 2 such holders for use in the lab.

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

cfangmeier, 2020-09-16:
A couple of these have been finished by the shop. I did a quick test, however, and found that the gel-paks fit too tightly onto the holder. They will be modified to use a looser fit to avoid this.

cfangmeier, 2020-09-25:
Three gel-pak vacuum releases have been finished and are in the clean room

Closed 2020-09-25.

Thread 7 (2020-08-26):

Bellows and Flange Assemblies

cfangmeier, 2020-08-26:
We need to produce bellows and flange assemblies. We have in hand:

  - 1x completed assembly for reference
  - 6x bare bellows
  - 2x flanges

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

We will need five additional pairs of flanges fabricated and, together with the current pair, they need to be attached to the bellows.

Drawings of the flanges are here:
[Flange 1](https://github.com/nebraska-silicon-lab/CAD/files/5130687/VacuumBellowsFlange_1.pdf)
[Flange 2](https://github.com/nebraska-silicon-lab/CAD/files/5130689/VacuumBellowsFlange_2.pdf)

They are identical but for slightly different hole sizes.

cfangmeier, 2020-08-26:
At Purdue, it was found that keeping the top and bottom flanges parallel during gluing is a challenge. To help with this an alignment jig was produced. Unfortunately, the original jig (and it's drawings) have been lost to the sands of time, but the designer was able to sketch out the basic idea of the jig:

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

The scale of the base is 2" x 2" x 1/2". The rods seem to support the flanges from their outside edge, but I could be wrong about that.

cfangmeier, 2020-09-22:
Finished and shipped to Purdue

Closed 2020-09-22.

Thread 8 (2020-08-26):

Bump bond alignment jig

cfangmeier, 2020-08-26:
A modified version of the bump bonding alignment jig for Santa Barbara has been designed and we have been asked to produce a couple of sets. Here are some photos hilighting the changes:

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

And here is the design file: [ASIC Alignment Tool.stp](https://github.com/nebraska-silicon-lab/CAD/raw/master/ETL/bump_bonding/ASIC%20Alignment%20Tool.stp)

cfangmeier, 2020-09-16:
This has been fabricated and shipped to UCSB.

Closed 2020-09-16.

Thread 9 (2020-08-26):

TFPX Vacuum Picker Assembly

cfangmeier, 2020-08-26:
Using the new vacuum picker "head" (right) as well as scavenged parts from a Phase I stamp tool (left), we can assembly a TFPX-style vacuum picker tool.

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

cfangmeier, 2020-09-16:
The assembly is complete and in the clean room.

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

Closed 2020-09-16.

Thread 10 (2020-09-02):

TFPX Adapter for wirebonder

cfangmeier, 2020-09-02:
See description here:

https://docs.google.com/presentation/d/1nTy8LJqv1Ra1XPof8GMl2GLWNYe8yZCwbIcrrU_f4FA/edit?usp=sharing

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

cfangmeier, 2020-09-03:
From Matthew:

> The pins are parts from McMaster but I will have to dig up the purchase order when I am in at work tomorrow or Thursday.  They need to be placed fairly precisely so that the module carrier will not get stuck, so I would recommend also buying an undersize stubby drill bit and an undersize reamer which will allow you to press fit them to about 10 um precision.  If you just let your machinists know that the spacing between them is a critical dimension (which I will have to look up) then they can probably do the machining better than I could, but it will be important to explain the constraints to them.

And

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

This information, together with some measurements of the existing Phase I plate, should be sufficient to design an prototype chuck for the wirebonder.

cfangmeier, 2020-11-23:
The design for the new plate is available here:
https://github.com/nebraska-silicon-lab/CAD/blob/master/Pull%20Tester/TFPX%20Plate.ipt

cfangmeier, 2021-02-05:
[Updated design](https://github.com/nebraska-silicon-lab/Hardware/tree/master/TFPX/Wirebonding%20Plate) for new chuck

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

cfangmeier, 2021-04-08:
Finished. Copy of #23

Closed 2021-04-08.

Thread 12 (2021-01-08):

ETL Picker Tool

cfangmeier, 2021-01-08:
Designs here:

https://github.com/nebraska-silicon-lab/CAD/tree/master/ETL/Module%20Assembly/Picker%20Tool

cfangmeier, 2021-02-05:
The picker tool has been finished placed on the gantry tool rack. The shop didn't order a pair of suction cups, but it turns out that the suction cups it uses are the same as what are used in the TFPX picker. So I temporarily just installed some of the extra suction cups that Matthew sent us.

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

Closed 2021-02-05.

Thread 14 (2021-01-08):

ETL Glue Stamp

cfangmeier, 2021-01-08:
Designs here:

https://github.com/nebraska-silicon-lab/CAD/tree/master/ETL/Module%20Assembly/Glue%20Stamp

cfangmeier, 2021-01-19:
Received and placed on gantry table.

cfangmeier, 2021-02-11:
The rubber stamp arrived. I trimmed the excess and used double-sided tape to attach it to the brass piece. Note that having the stamp perfectly centered/straight is not necessary since it will need to be calibrated anyway.

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

Closed 2021-01-19.

Thread 15 (2021-02-05):

ETL Assembly Plate

cfangmeier, 2021-02-05:
1 [Assembly Plate](https://github.com/nebraska-silicon-lab/Hardware/tree/master/ETL/Module%20Assembly/Assembly%20Plate)

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

cfangmeier, 2021-02-19:
Received 2 plates.

1 @ 1/2" thickness (original design)
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

and 1 @ 1/4" thickness (above and final-ish) design, shown w/ 4 ETL base-plates attached.
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

Closed 2021-02-19.

Thread 16 (2021-02-05):

ETL BBM Staging Plate

cfangmeier, 2021-02-05:
1 [BBM Staging Plate](https://github.com/nebraska-silicon-lab/Hardware/tree/master/ETL/Module%20Assembly/BBM%20Staging%20Plate)

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

cfangmeier, 2021-03-04:
Received. I attempted to glue the stencil onto the base, but I put on too much glue and it leaked out onto the staging areas. However, 3 positions are still usable and this isn't the final design anyway.

Bottom line: we can use this part for some initial studies of pick & place w/ ETL tooling.

Closed 2021-03-04.

Thread 17 (2021-02-05):

Wirebonder Chuck

cfangmeier, 2021-02-05:
[New chuck](https://github.com/nebraska-silicon-lab/Hardware/tree/master/Wirebonder) for wirebonder. Shown below with existing spacer.

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

Work Order: [link](https://github.com/nebraska-silicon-lab/Hardware/blob/master/Work%20Orders/2021_02_TFPX_wirebonder-chuck.pdf)

cfangmeier, 2021-03-23:
Fabrication complete. Shipped to Omaha for hard coating.

cfangmeier, 2021-04-08:
Hard coating complete. In lab, but requires different vacuum adapter than currently installed. [this](https://www.mcmaster.com/7397N114/) should work

cfangmeier, 2021-04-21:
New adapter arrived and chuck installed.

Closed 2021-04-21.

Thread 18 (2021-02-05):

Wirebond Pull-tester

cfangmeier, 2021-02-05:
[Design](https://github.com/nebraska-silicon-lab/Hardware/tree/master/Pull%20Tester) of wirebond pull-tester is in progress. Current version is shown below with an ETL assembly plate.

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

Outstanding issues

- [ ] Find way to rotate hook
- [ ] Find working Camera/microscope setup to assist alignment.

cfangmeier, 2021-02-05:
I tested one [camera option](https://www.amazon.com/gp/product/B06WD843ZM/ref=ppx_yo_dt_b_asin_title_o00_s00?ie=UTF8&psc=1) by seeing the quality and ease of use in imaging wirebonds.

The image quality is just barely passable. Shown below is about the best I could manage, and another image showing the overall arrangement.

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

My biggest complaint is that the quality of the capture software is horrendous. It is also not so easy to adjust any camera parameters. Based on this, I don't recommend this camera for the pull tester.

cfangmeier, 2021-02-07:
A higher quality version of this device might be promising. Here's one option:

https://www.mcmaster.com/1058T24/

cfangmeier, 2021-02-09:
Another higher quality version

  - Camera: https://www.edmundoptics.com/p/10x-200x-usb-digital-microscope-high-resolution/29122/
  - Stand: https://www.edmundoptics.com/p/flex-arm-stand/28629/

Closed 2022-10-10.

Thread 20 (2021-02-22):

2nd ETL Cooling Plate Section

cfangmeier, 2021-02-22:
Fabricate another disc section just as in #5. Build to same design as before.

Work order: [link](https://github.com/nebraska-silicon-lab/Hardware/blob/master/Work%20Orders/2021_02_ETL_Second-Cooling-Plate.pdf)

cfangmeier, 2021-03-01:
Additional details:

The fitting for connecting to the CO2 system is:

https://www.swagelok.com/en/catalog/Product/Detail?part=SS-4-VCR-6-400

This unit must be pressure tested to 150 bar. This should be done at UNL.

fgolf, 2021-03-01:
@cfangmeier Thanks.  Can you check with the shop if they are able to perform the pressure test?

cfangmeier, 2021-03-01:
Will do.

cfangmeier, 2021-04-08:
Design has had to be modified due to high pressure requirements of C02 cooling leading to the replacement of aluminum tubing with stainless steel tubing. The SS tubing cannot be easily bent to the small bending radius.

Modified design: [Al mockup plate.pdf](https://github.com/nebraska-silicon-lab/Hardware/files/6280811/Al.mockup.plate.pdf)

cfangmeier, 2021-04-27:
After discussion with Keith, the decision was made to build a custom tool for bending the tubing. This is just because the bending radius, while not unreasonably small anymore, is not one of the standard values that benders are made in.

fgolf, 2021-04-27:
Before embarking on this let's get an estimate so that it isn't crazy
expensive.

On Tue, Apr 27, 2021 at 2:33 PM Caleb Fangmeier ***@***.***>
wrote:

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

--
Best regards,
Frank

cfangmeier, 2021-04-27:
I discussed this with Keith and he estimated it would be on the order of a few hundred bucks (certainly <1000). Do you want a more formal estimate?

fgolf, 2021-04-27:
That's fine then, go ahead.

On Tue, Apr 27, 2021 at 2:38 PM Caleb Fangmeier ***@***.***>
wrote:

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

--
Best regards,
Frank

cfangmeier, 2021-07-29:
Finished and pressure tested.

Closed 2021-07-29.

Thread 21 (2021-03-08):

ETL Gantry chuck rework

cfangmeier, 2021-03-08:
Two existing chucks should be reworked to V2 designs. One to V2 and one to V2F.

[work order](https://github.com/nebraska-silicon-lab/Hardware/blob/master/Work%20Orders/2021_03_ETL_gantryChuckRework.pdf)

cfangmeier, 2021-03-23:
Reworks are complete. Shipped to Omaha for hard coating.

cfangmeier, 2021-04-08:
Hard coating complete. 1 shipped to FNAL, other in lab.

Closed 2021-04-08.

Thread 23 (2021-03-09):

TFPX Wirebonder Plate

cfangmeier, 2021-03-09:
Fabrication of 1 TFPX Wirebonder Plate

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

[work order](https://github.com/nebraska-silicon-lab/Hardware/blob/master/Work%20Orders/2021_03_TFPX_WirebondingPlate.pdf)

cfangmeier, 2021-04-08:
Done and in lab.

Closed 2021-04-08.

Thread 26 (2021-04-08):

BBM Staging Plate

cfangmeier, 2021-04-08:
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

[work order](https://github.com/nebraska-silicon-lab/Hardware/blob/master/Work%20Orders/2021_04_ETL_BBMStagingPlate.pdf)

cfangmeier, 2021-05-03:
Components complete. Shop will glue together to finish.

cfangmeier, 2021-05-21:
Finished and in lab.

Closed 2021-05-21.

Thread 28 (2021-04-08):

Glue Stamp Staging Plate

cfangmeier, 2021-04-08:
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

[work order](https://github.com/nebraska-silicon-lab/Hardware/blob/master/Work%20Orders/2021_04_ETL_GlueStampStagingPlate.pdf)

cfangmeier, 2021-04-19:
Finished and in lab

Closed 2021-04-19.

Thread 29 (2021-04-21):

TFPX Carrier blank for wirebonding

cfangmeier, 2021-04-21:
The TFPX wirebonding plate has 2 spots for module carriers. This is a blank to cover the vacuum of an unused spot.

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

[work order](https://github.com/nebraska-silicon-lab/Hardware/blob/master/Work%20Orders/2021_04_TFPX_CarrierBlank.pdf)

cfangmeier, 2021-05-03:
Finished and in lab.

Closed 2021-05-03.
