nebraska-silicon-lab/Hardware/Pull Tester/prnt_12692.pdf

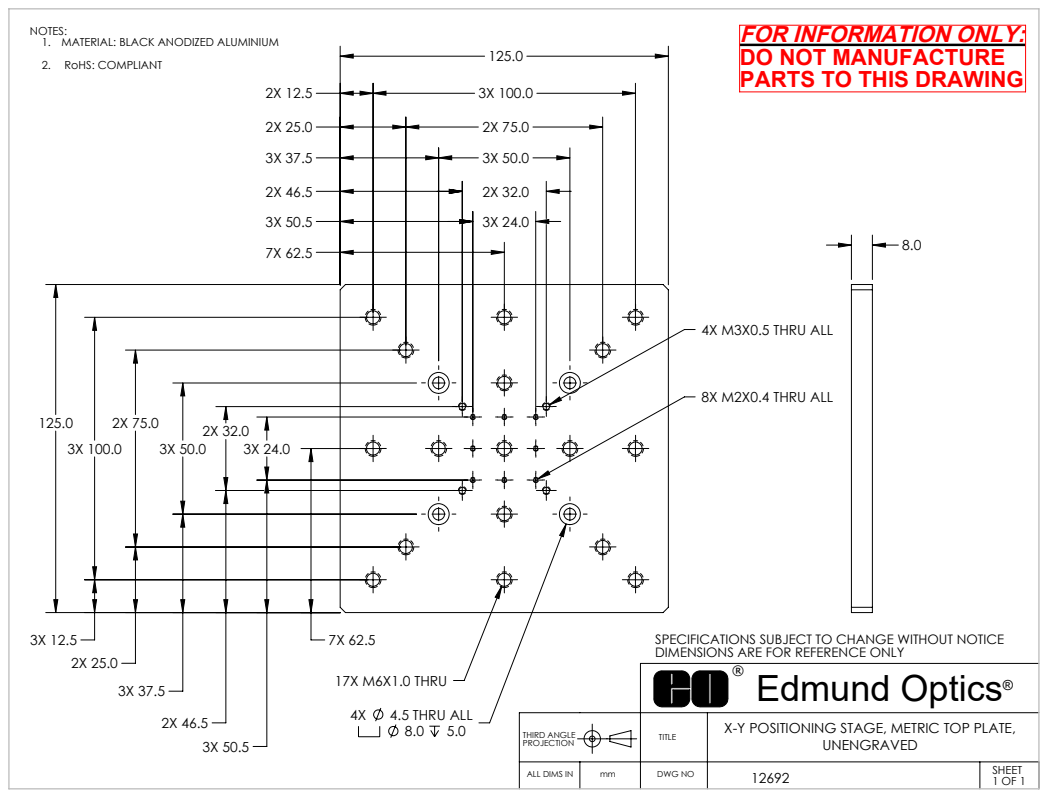
[picture p57: page 1]
THIRD ANGLE; 17X M6X1.0 THRU; 4.5 THRU ALL; 4X M3X0.5 THRU ALL; 8X M2X0.4 THRU ALL; DWG NO; 1 OF 1 ALL DIMS IN

NOTES:
1. MATERIAL: BLACK ANODIZED ALUMINIUM
2. RoHS: COMPLIANT

FOR INFORMATION ONLY:
DO NOT MANUFACTURE
PARTS TO THIS DRAWING

SPECIFICATIONS SUBJECT TO CHANGE WITHOUT NOTICE
DIMENSIONS ARE FOR REFERENCE ONLY
Edmund Optics®

X-Y POSITIONING STAGE, METRIC TOP PLATE,
