nebraska-silicon-lab/Hardware/ETL/Module Assembly/Picker Tool - V2/Picker Tool - V2.pdf

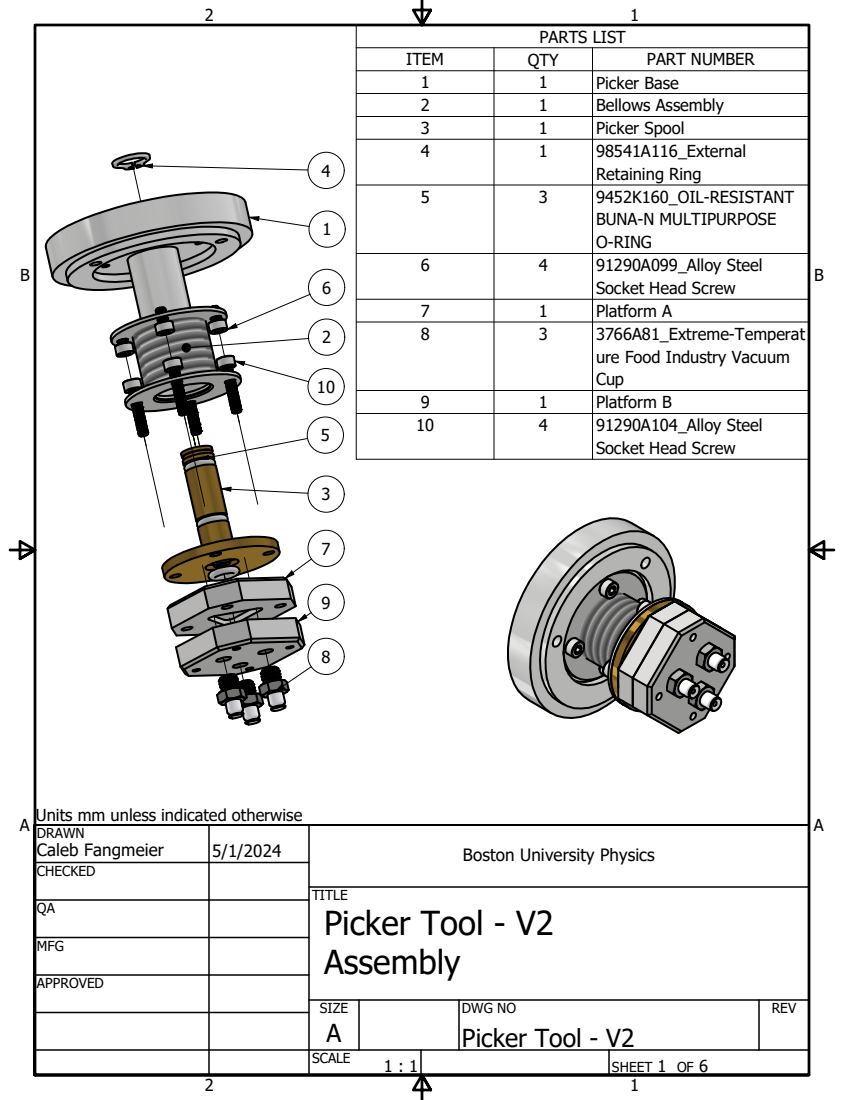
[picture p58: page 1]
Picker Tool - V2

PARTS LIST

ITEM | QTY | PART NUMBER
1 | 1 | Picker Base
2 | 1 | Bellows Assembly
3 | 1 | Picker Spool
4 | 1 | 98541A116_External Retaining Ring

5 | 3 | 9452K160_OIL-RESISTANT BUNA-N MULTIPURPOSE O-RING

6 | 4 | 91290A099_Alloy Steel Socket Head Screw

7 | 1 | Platform A
8 | 3 | 3766A81_Extreme-Temperat ure Food Industry Vacuum Cup

9 | 1 | Platform B
10 | 4 | 91290A104_Alloy Steel Socket Head Screw

Units mm unless indicated otherwise

DRAWN Caleb Fangmeier | 5/1/2024 | Boston University Physics

CHECKED

MFG

APPROVED

SIZE A | DWG NO Picker Tool - V2 | REV

SCALE | | SHEET 1 OF 6

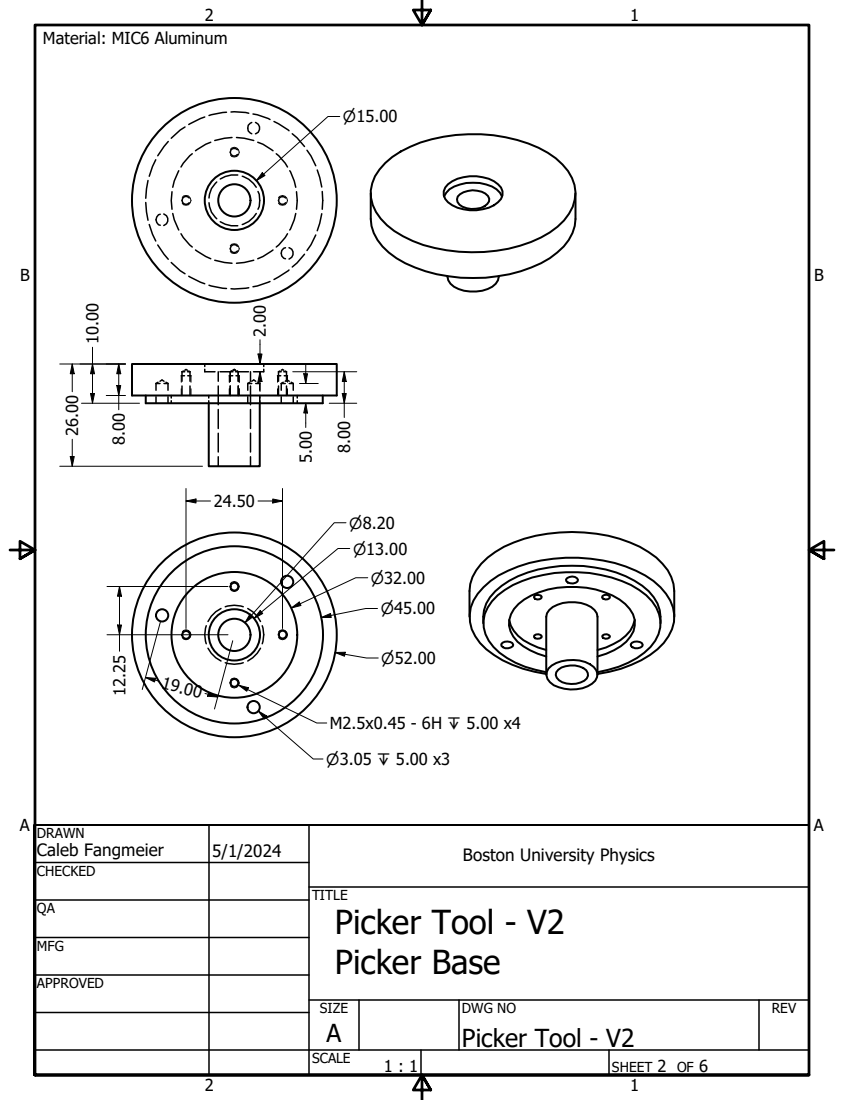
[picture p59: page 2]
Picker Tool - V2 Picker Base; Material: MIC6 Aluminum

DRAWN Caleb Fangmeier | 5/1/2024 | Boston University Physics

CHECKED

MFG

APPROVED

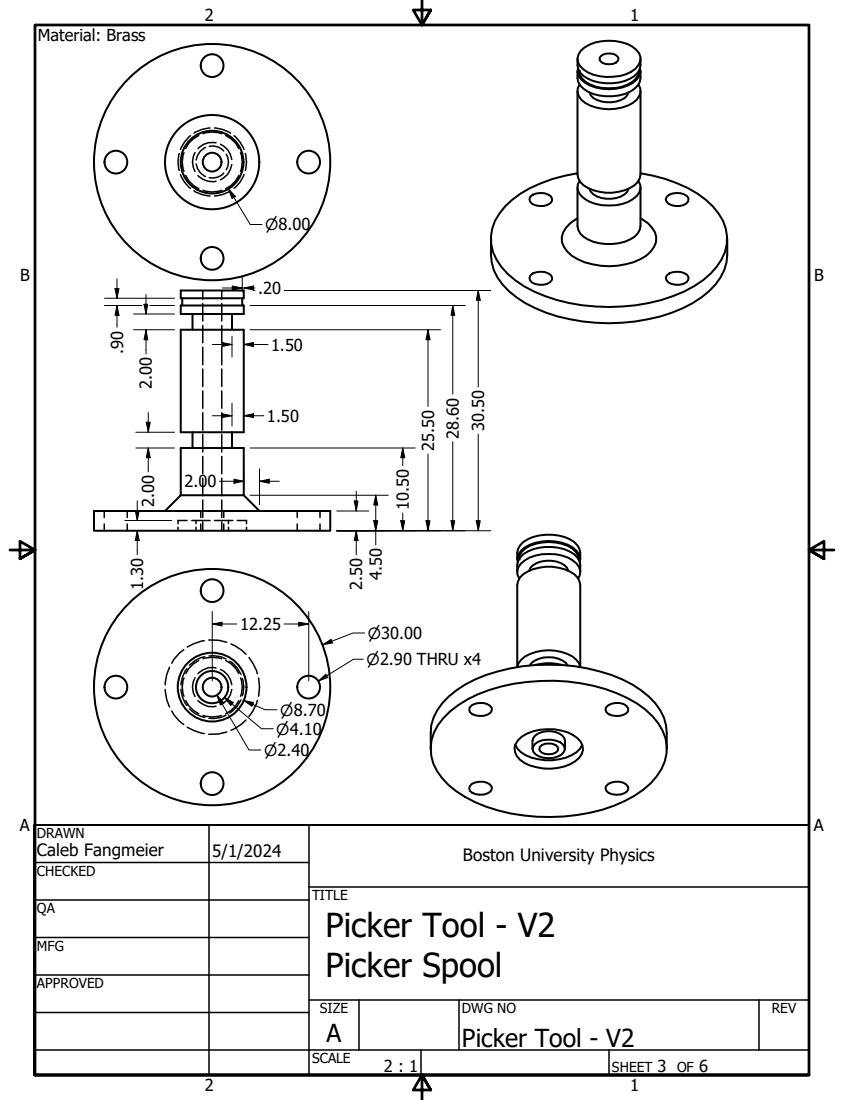
[picture p60: page 3]
Picker Tool - V2 Picker Spool; ⌀2.90 THRU x4; Material: Brass

DRAWN Caleb Fangmeier | 5/1/2024 | Boston University Physics

CHECKED

MFG

APPROVED

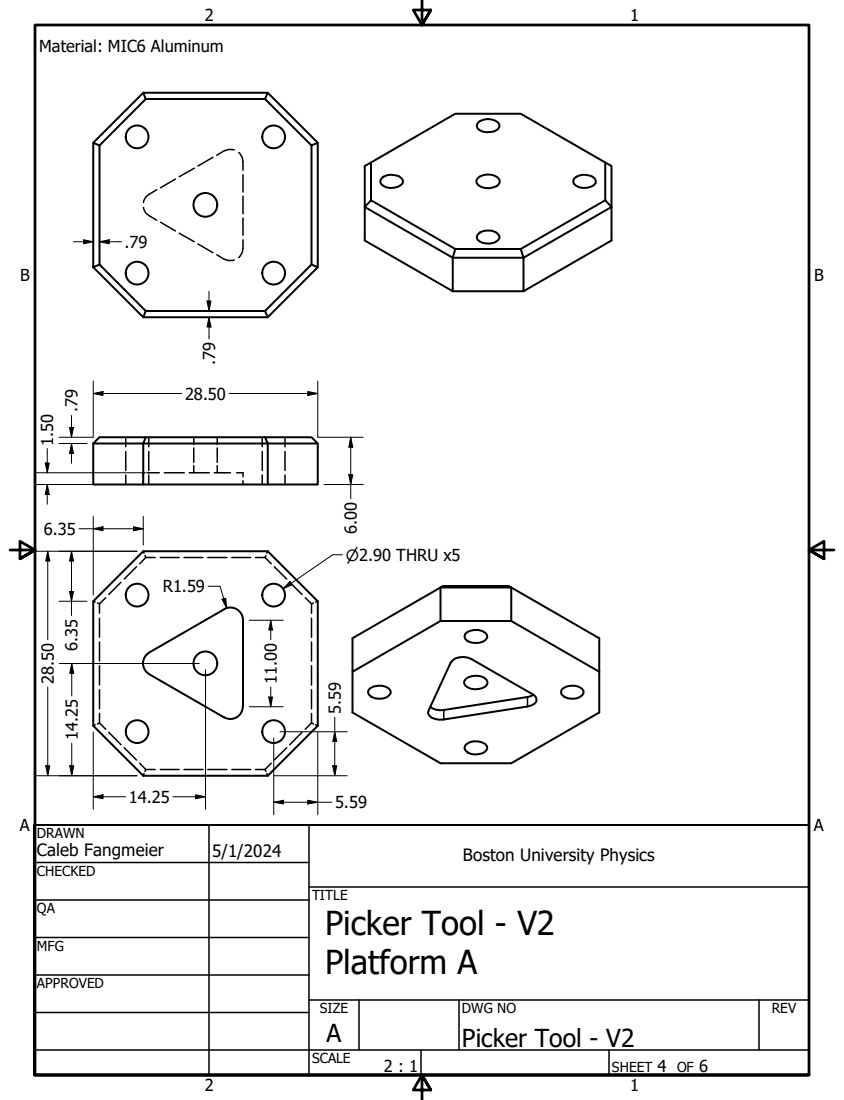
[picture p61: page 4]
Picker Tool - V2 Platform A; ⌀2.90 THRU x5

DRAWN Caleb Fangmeier | 5/1/2024 | Boston University Physics

CHECKED

MFG

APPROVED

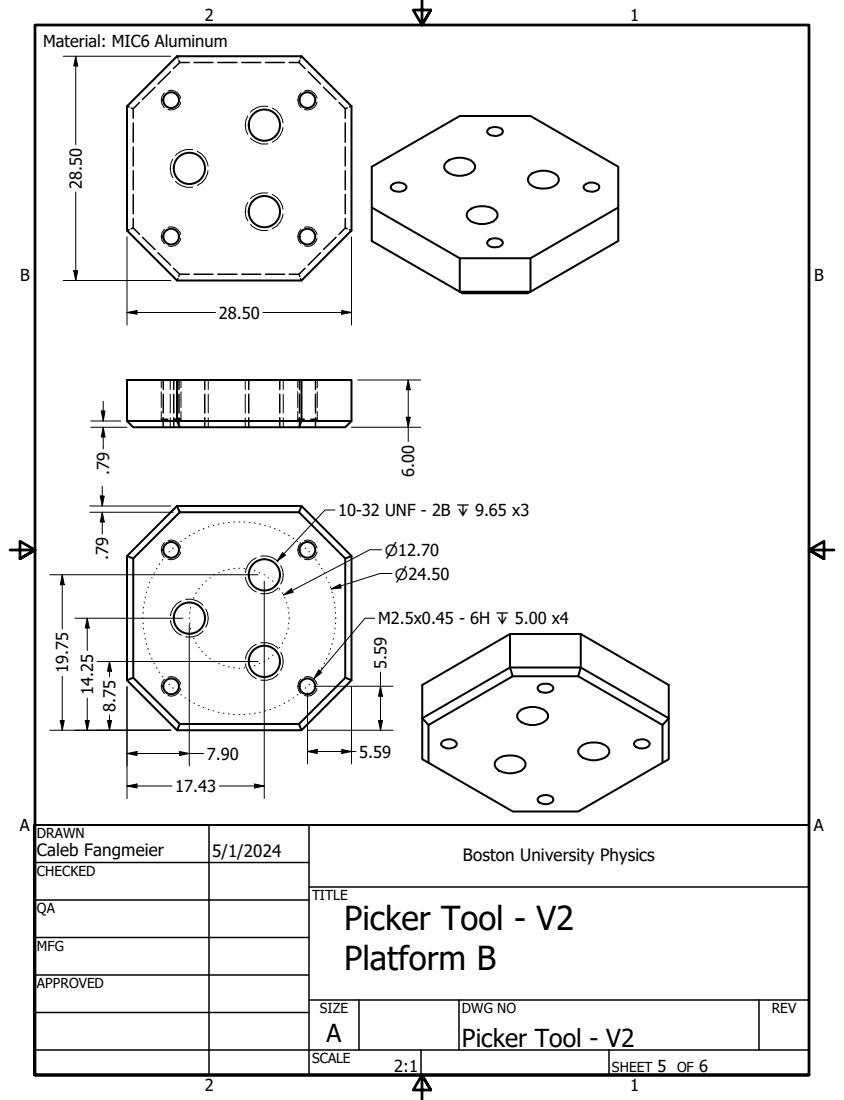
[picture p62: page 5]
Picker Tool - V2 Platform B; 10-32 UNF - 2B ↧ 9.65 x3

DRAWN Caleb Fangmeier | 5/1/2024 | Boston University Physics

CHECKED

MFG

APPROVED

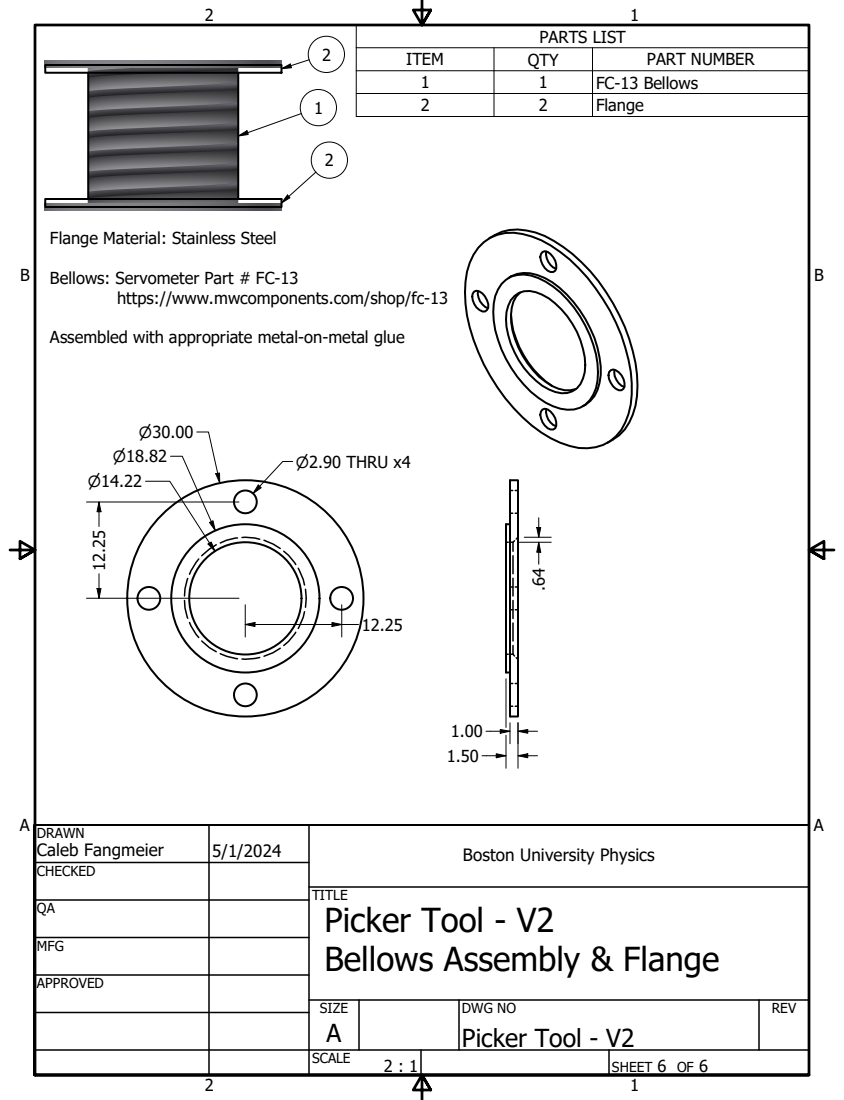
[picture p63: page 6]
⌀2.90 THRU x4

PARTS LIST

ITEM | QTY | PART NUMBER
1 | 1 | FC-13 Bellows
2 | 2 | Flange

Flange Material: Stainless Steel

Bellows: Servometer Part # FC-13

https://www.mwcomponents.com/shop/fc-13

Assembled with appropriate metal-on-metal glue

DRAWN Caleb Fangmeier | 5/1/2024 | Boston University Physics

CHECKED

TITLE
Picker Tool - V2
Bellows Assembly & Flange

MFG

APPROVED
