nebraska-silicon-lab/Hardware/ETL/Module Assembly/Assembly Plate/Assembly Plate.pdf

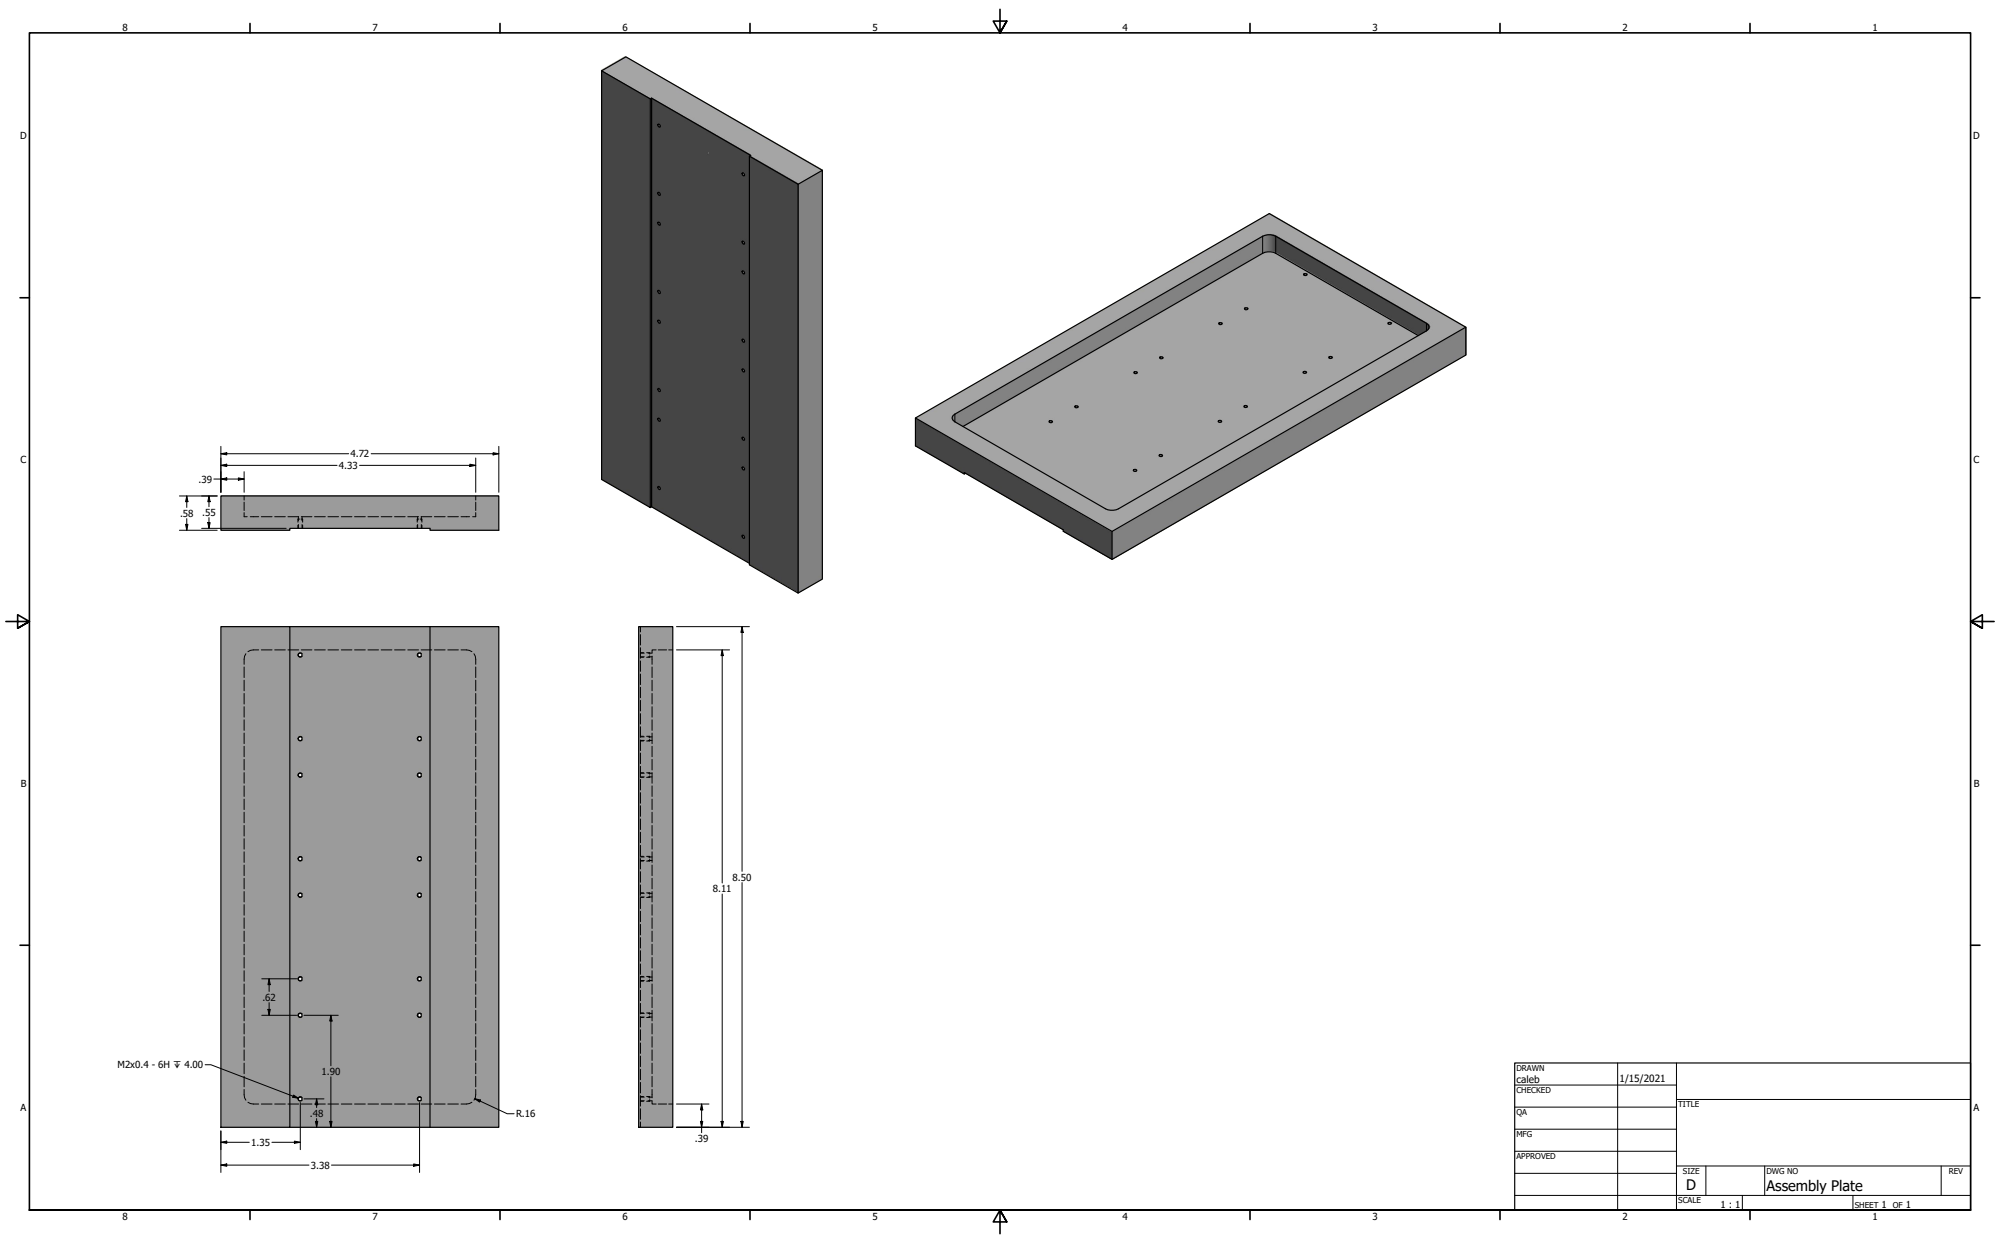
[picture p64: page 1]

DRAWN caleb | 1/15/2021

CHECKED

MFG

APPROVED

SIZE D | DWG NO Assembly Plate | REV

SCALE 1 : 1 | | SHEET 1 OF 1
