nebraska-silicon-lab/Hardware/General Gantry/Gantry Tool Rack/PDF Drawing Files/Tool Rack Assembly.pdf

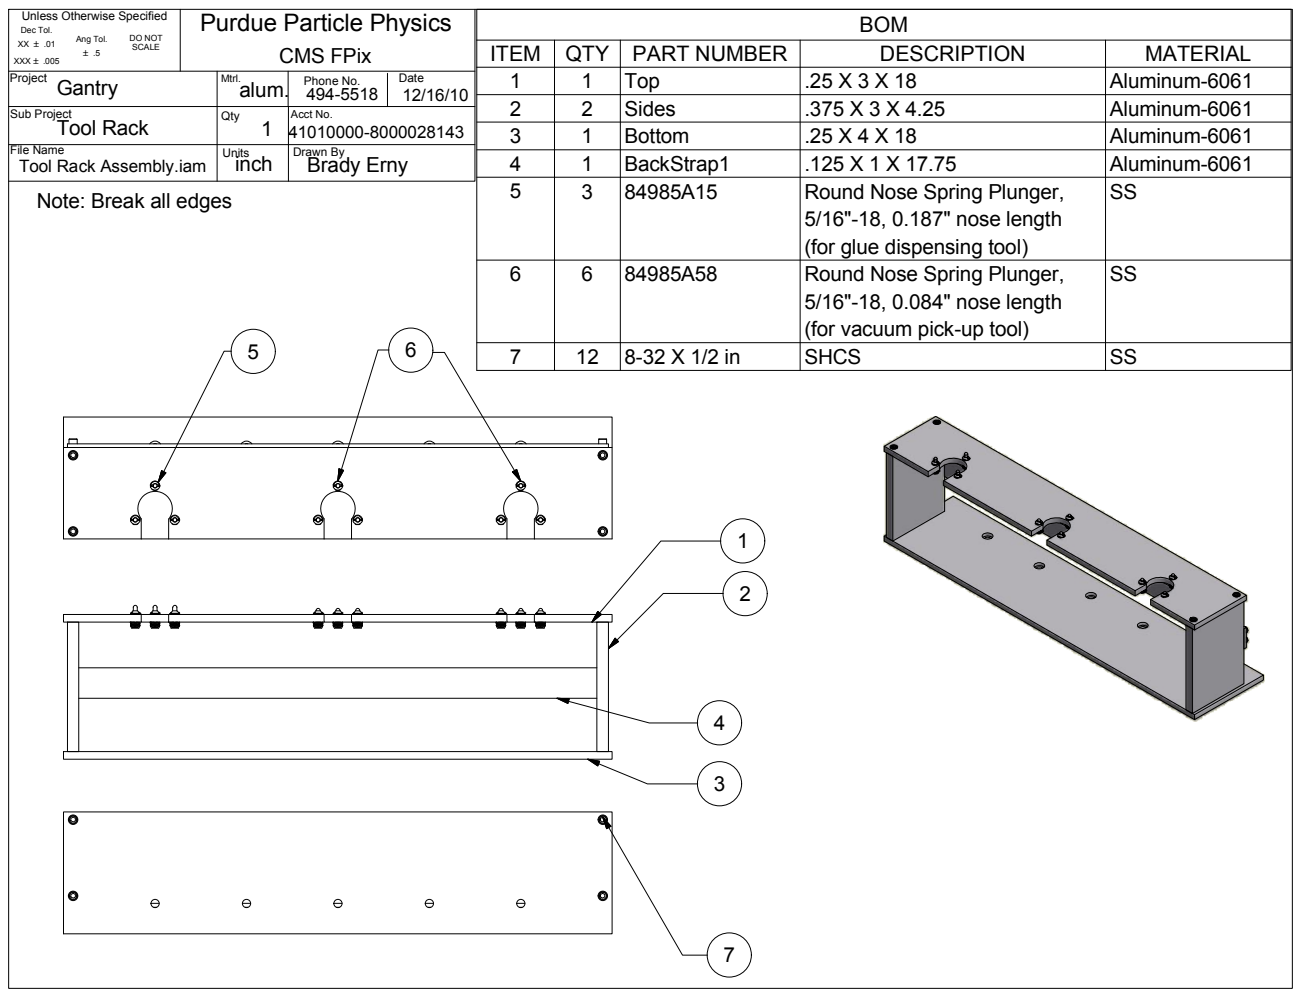
[picture p65: page 1]
BOM; ITEM; QTY; PART NUMBER; DESCRIPTION; MATERIAL; Top; Aluminum-6061; Sides; Bottom; BackStrap1; Round Nose Spring Plunger,; SHCS; Acct No.; Phone No. 494-5518; Mtrl.; Date; Drawn By Brady Erny; Units; Dec Tol. XX B .01; XXX B .005; DO NOT SCALE; Sub Project; Project; Ang Tol. B .5; Qty; CMS FPix; Gantry; Tool Rack; alum.; inch

Unless Otherwise Specified

Purdue Particle Physics

File Name
Tool Rack Assembly.iam
Note: Break all edges

5/16"-18, 0.187" nose length
(for glue dispensing tool)
5/16"-18, 0.084" nose length
(for vacuum pick-up tool)
