nebraska-silicon-lab/Hardware/ETL/FNAL Tooling Designs/Chuck/F10129572---DWG1.pdf

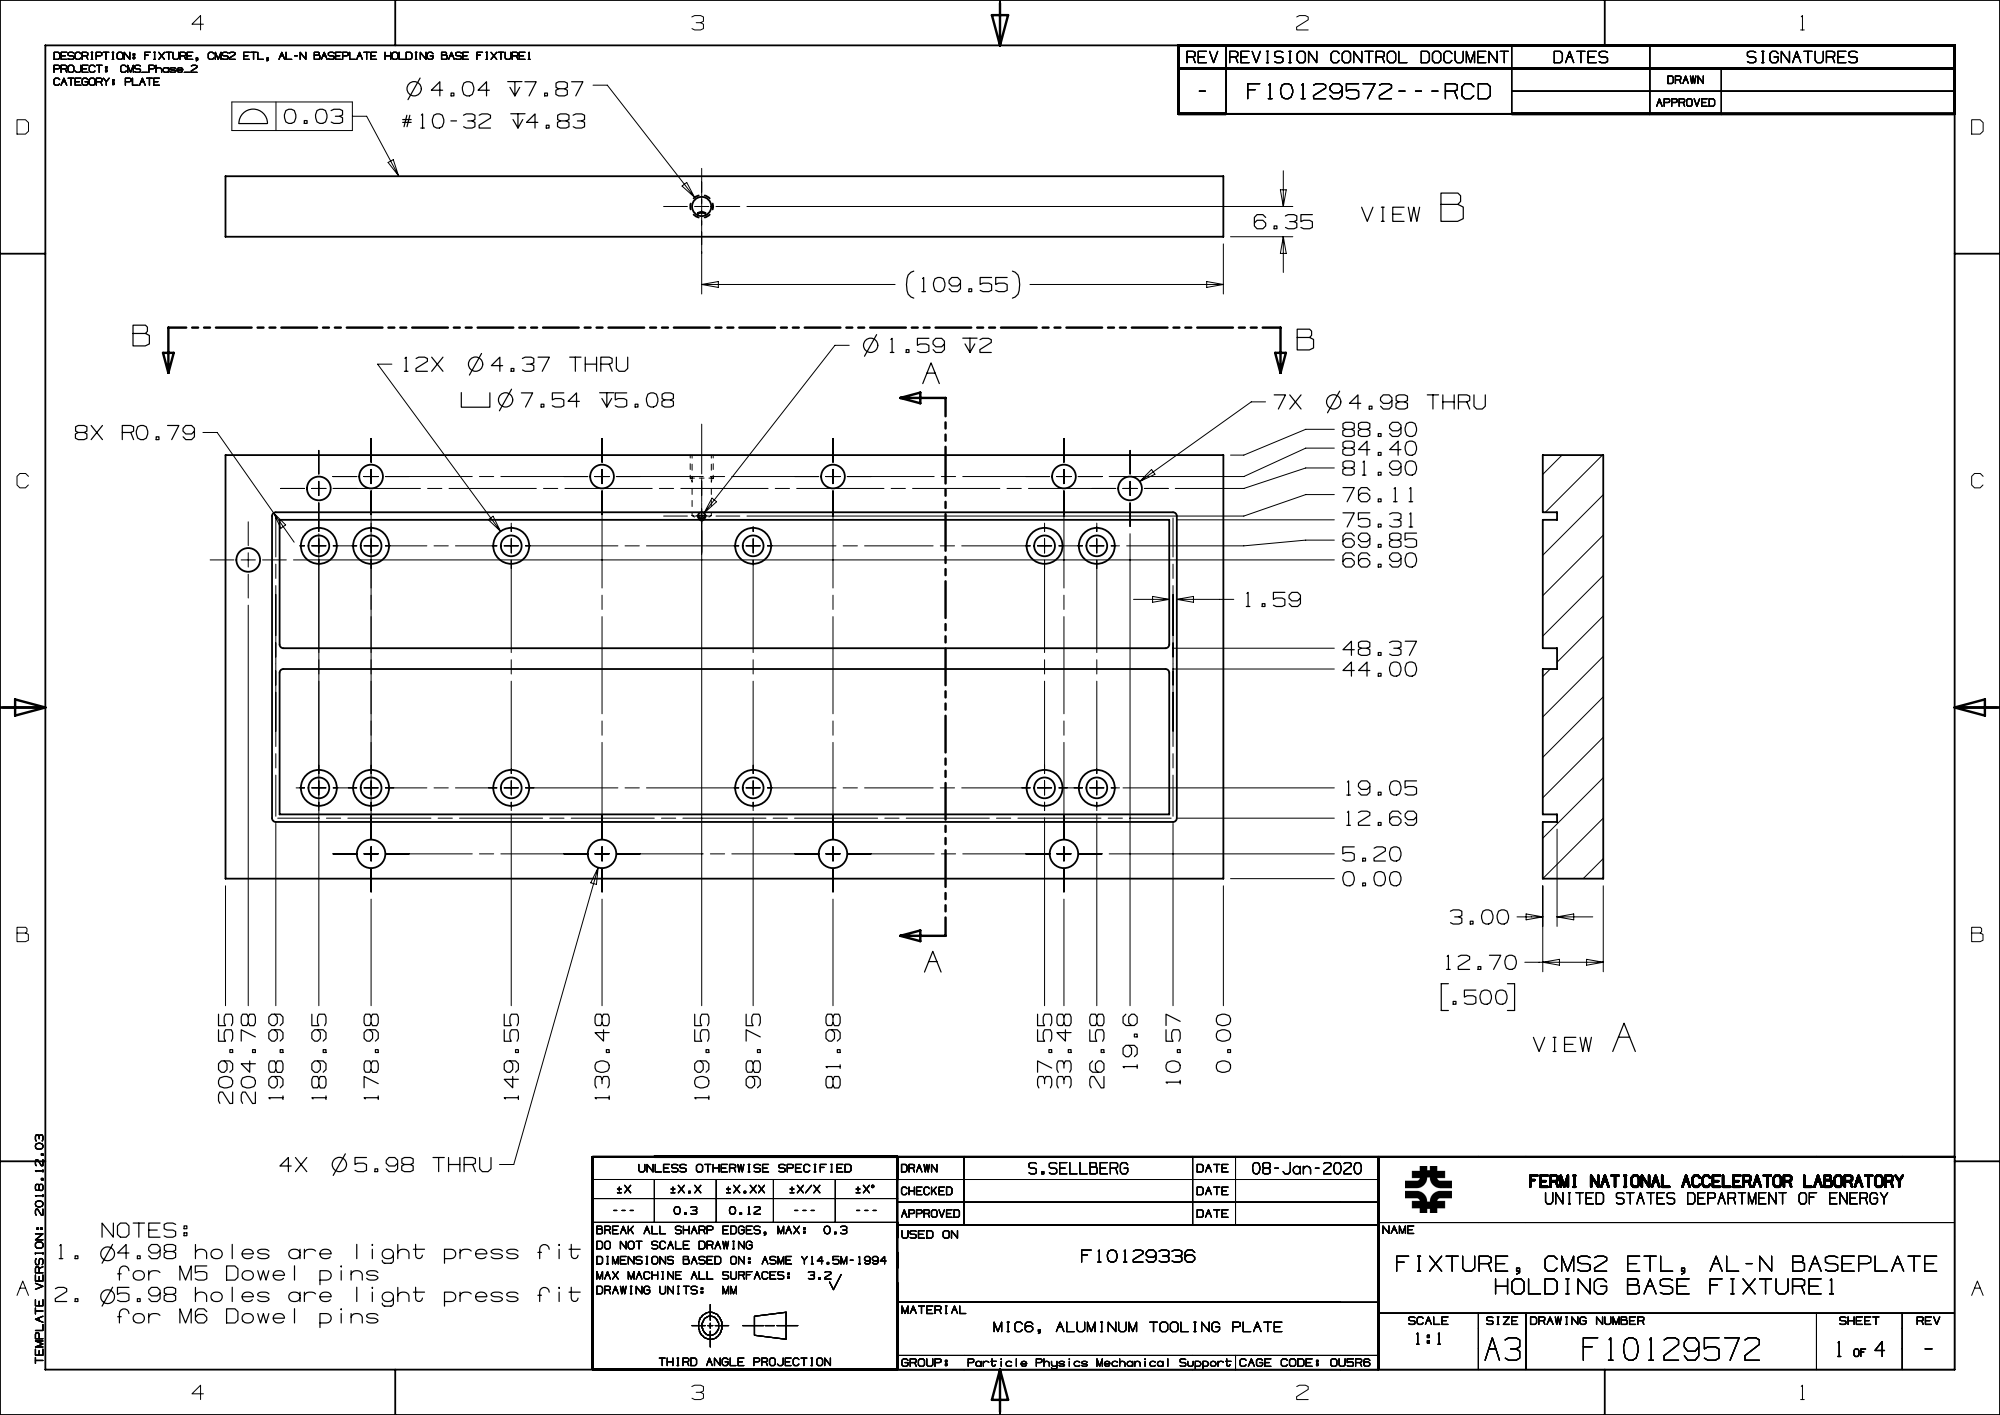
[picture p66: page 1]
