nebraska-silicon-lab/Hardware/ETL/FNAL Tooling Designs/Chuck/F10129572---DWG2.pdf

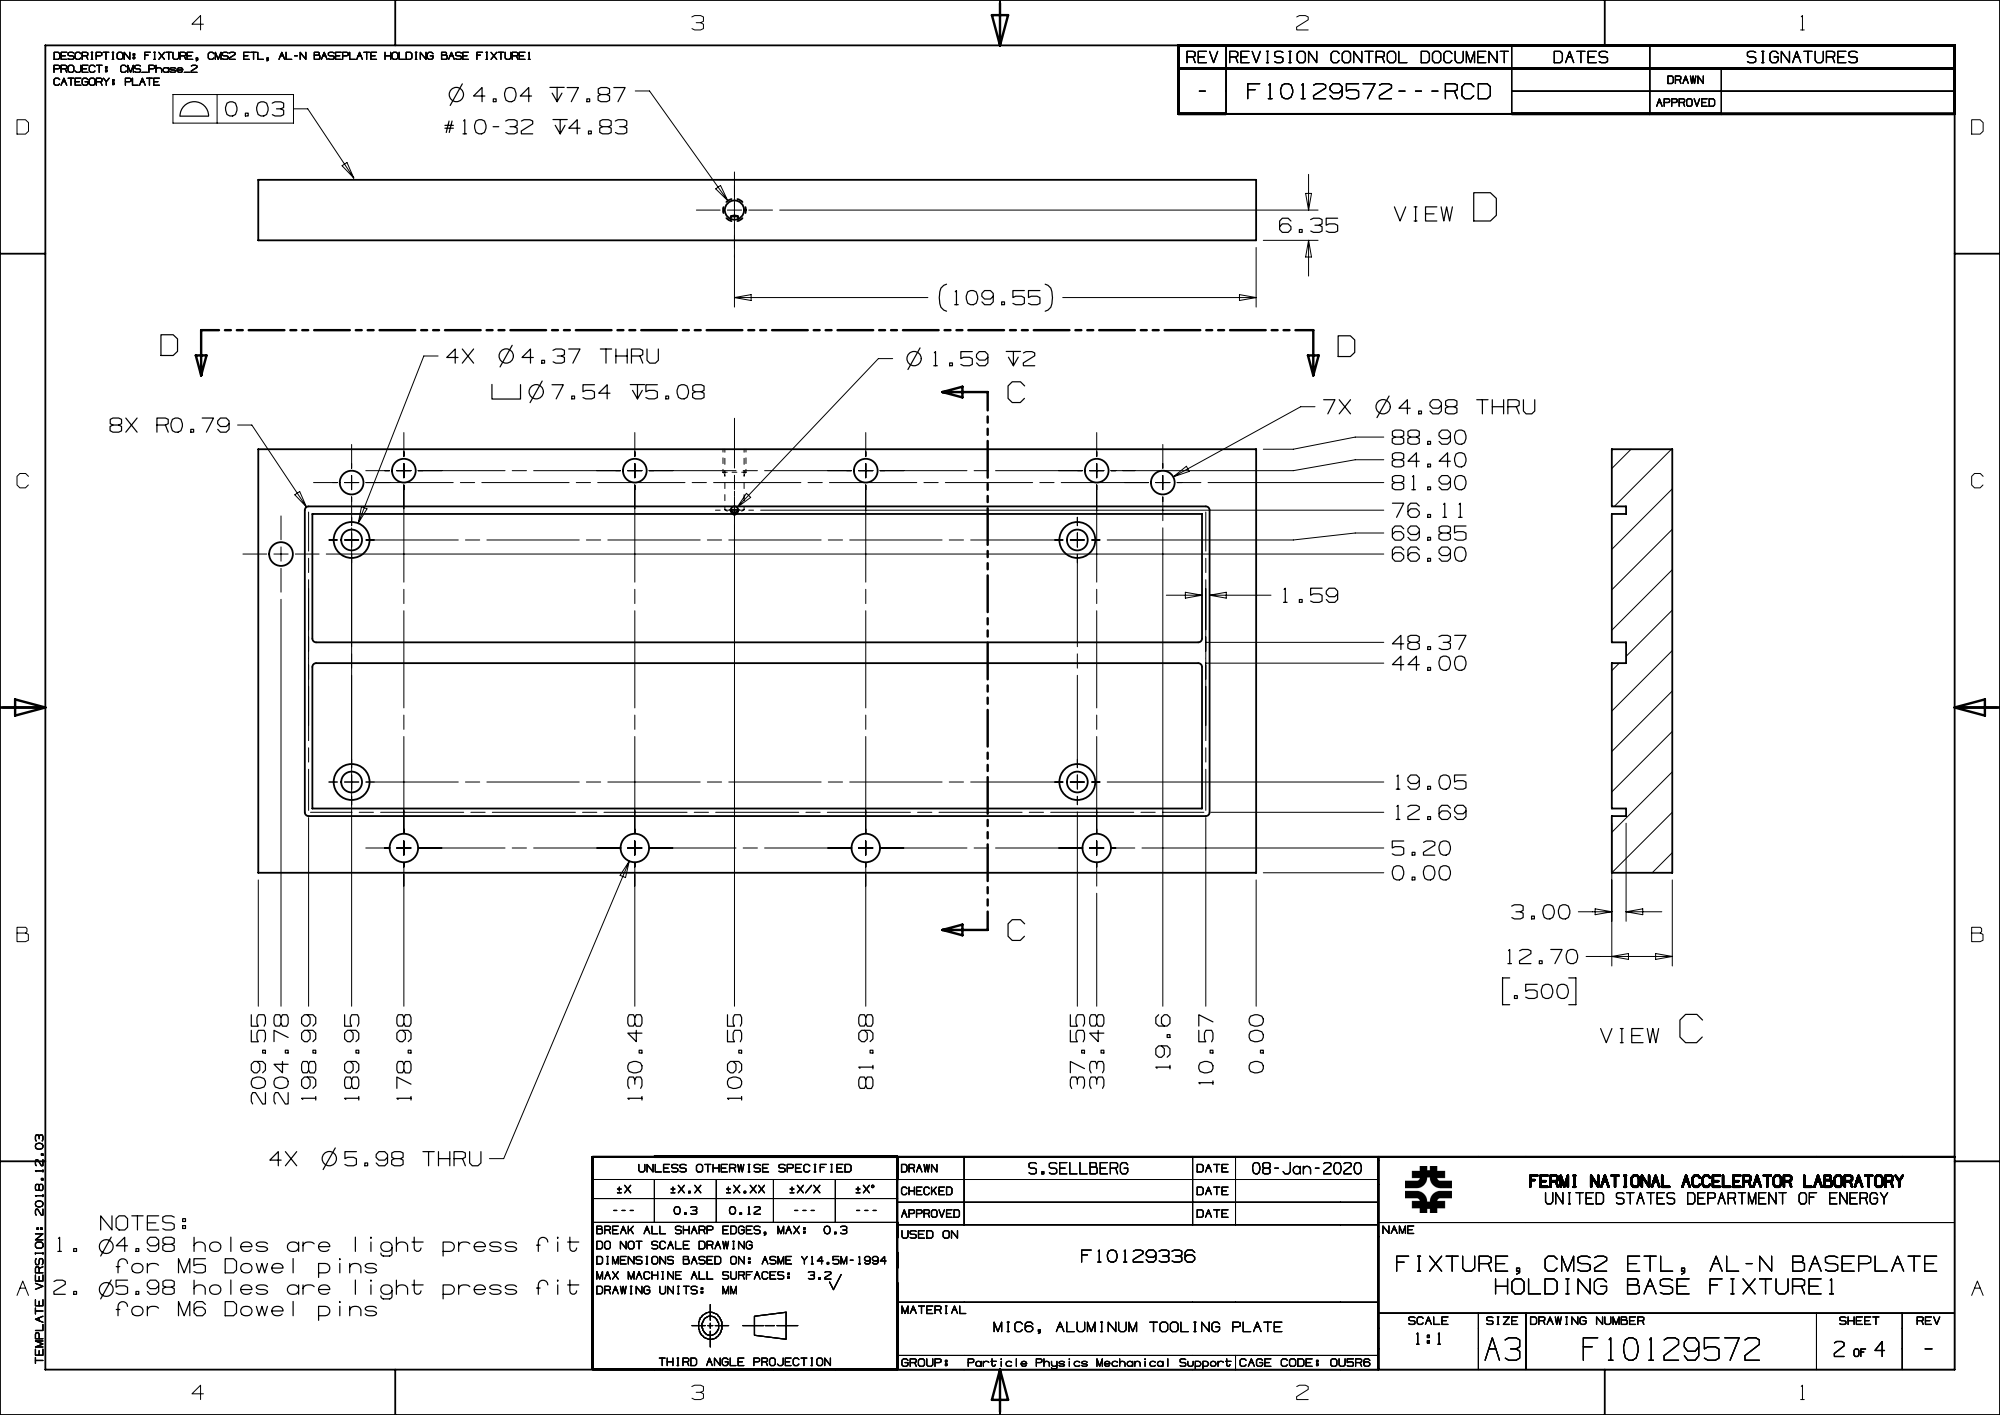
[picture p67: page 1]
