nebraska-silicon-lab/Hardware/ETL/FNAL Tooling Designs/Chuck/F10129572---DWG3.pdf

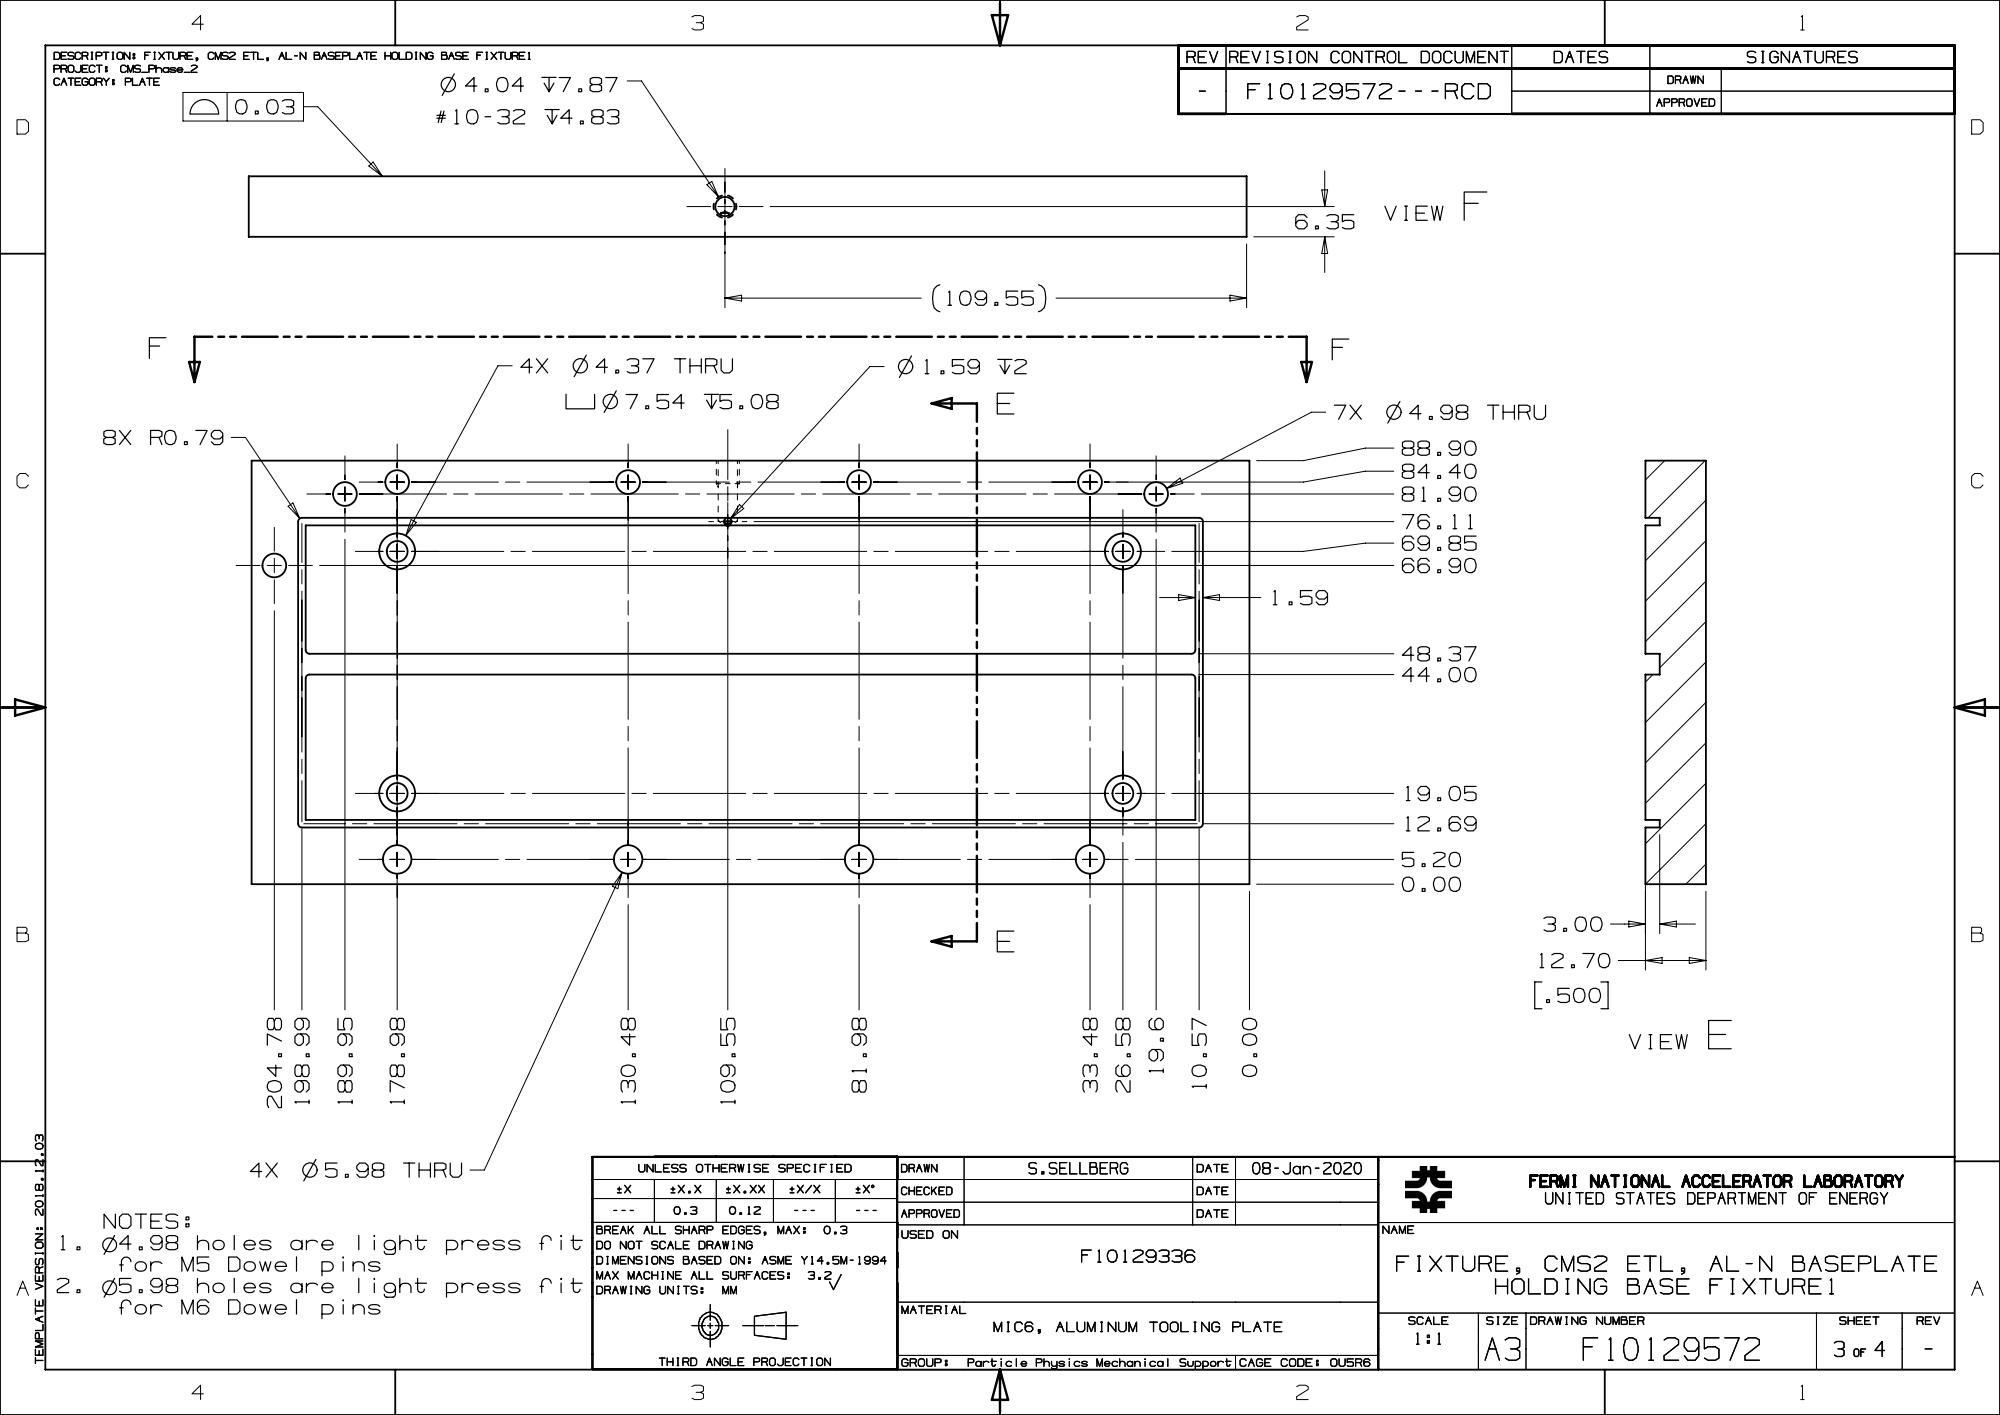
[picture p68: page 1]
