nebraska-silicon-lab/Hardware/ETL/FNAL Tooling Designs/Chuck/F10129572---DWG4.pdf

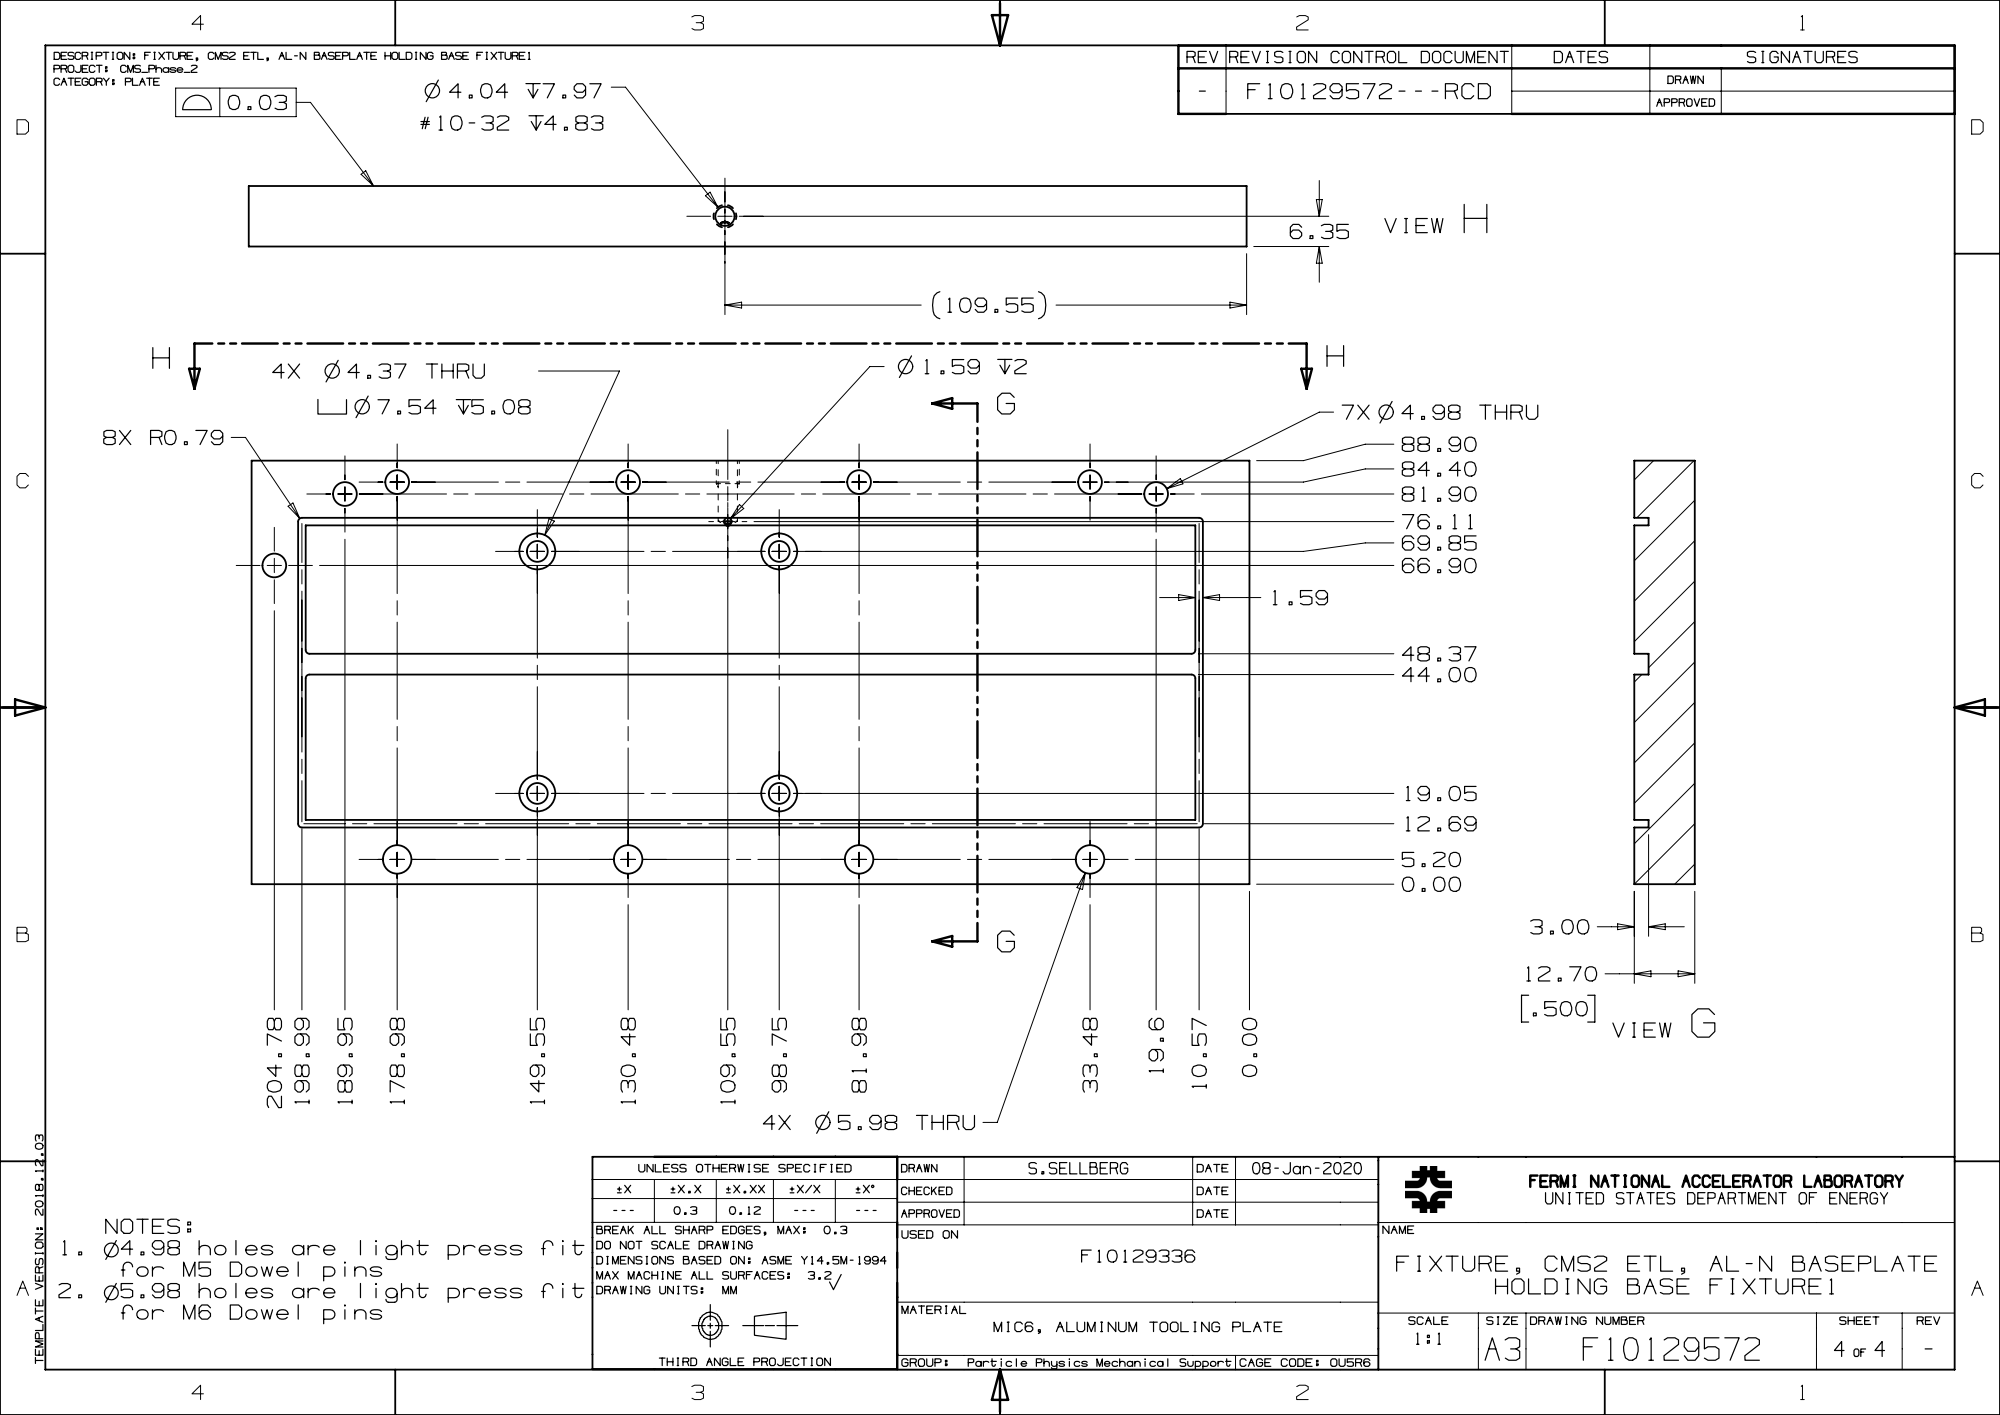
[picture p69: page 1]
