nebraska-silicon-lab/Hardware/ETL/FNAL Tooling Designs/Chuck/F10129574---DWG1.pdf

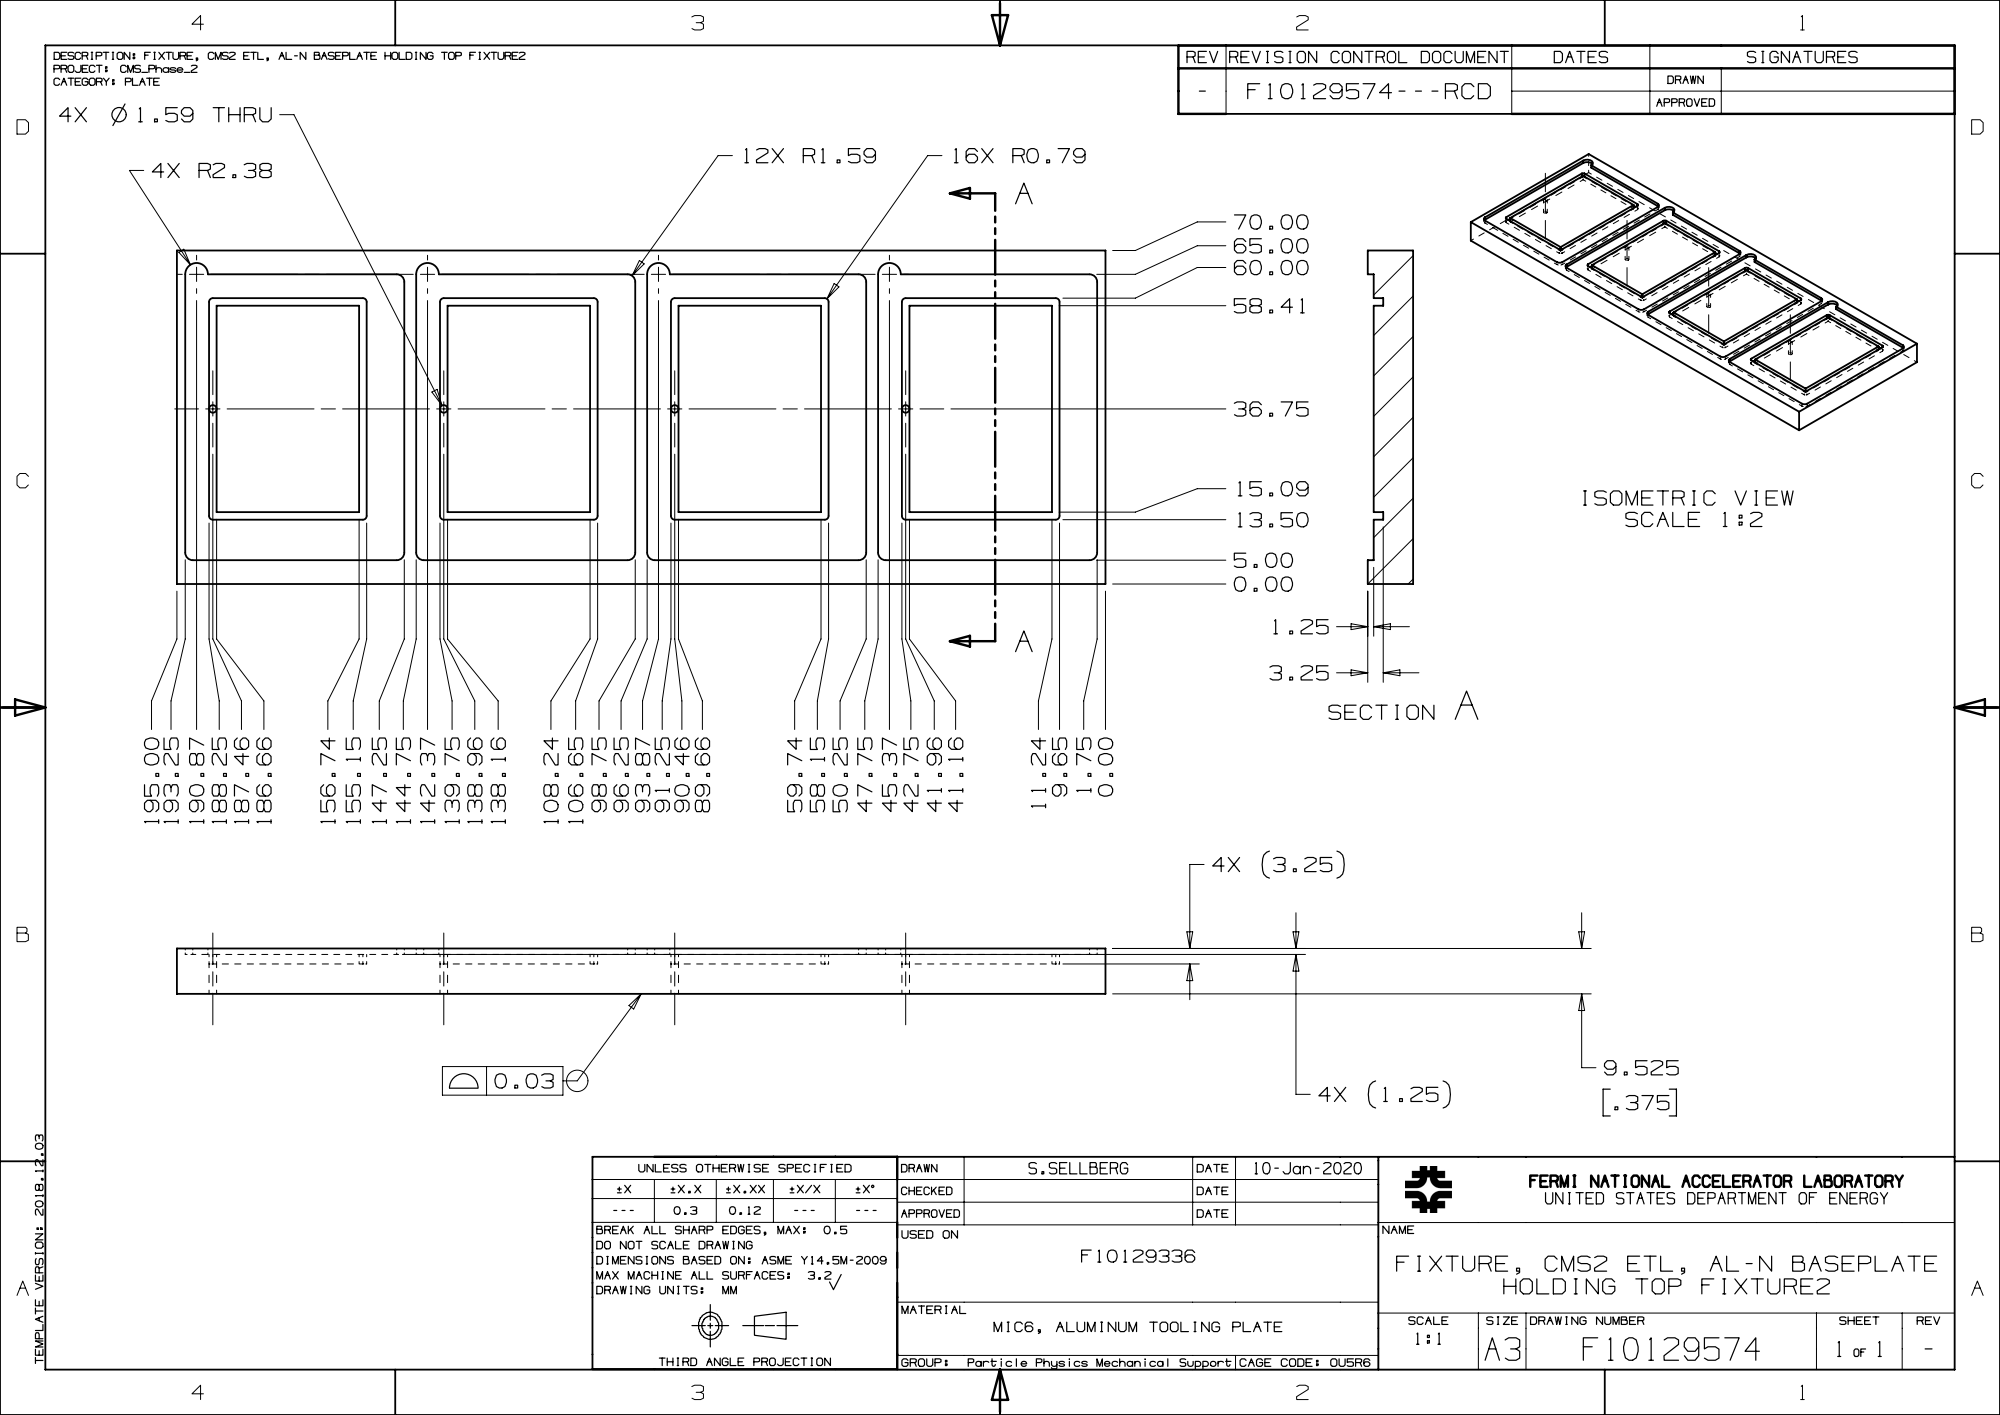
[picture p70: page 1]
