nebraska-silicon-lab/Hardware/ETL/FNAL Tooling Designs/Chuck/F10129575_-_PDF_1.pdf

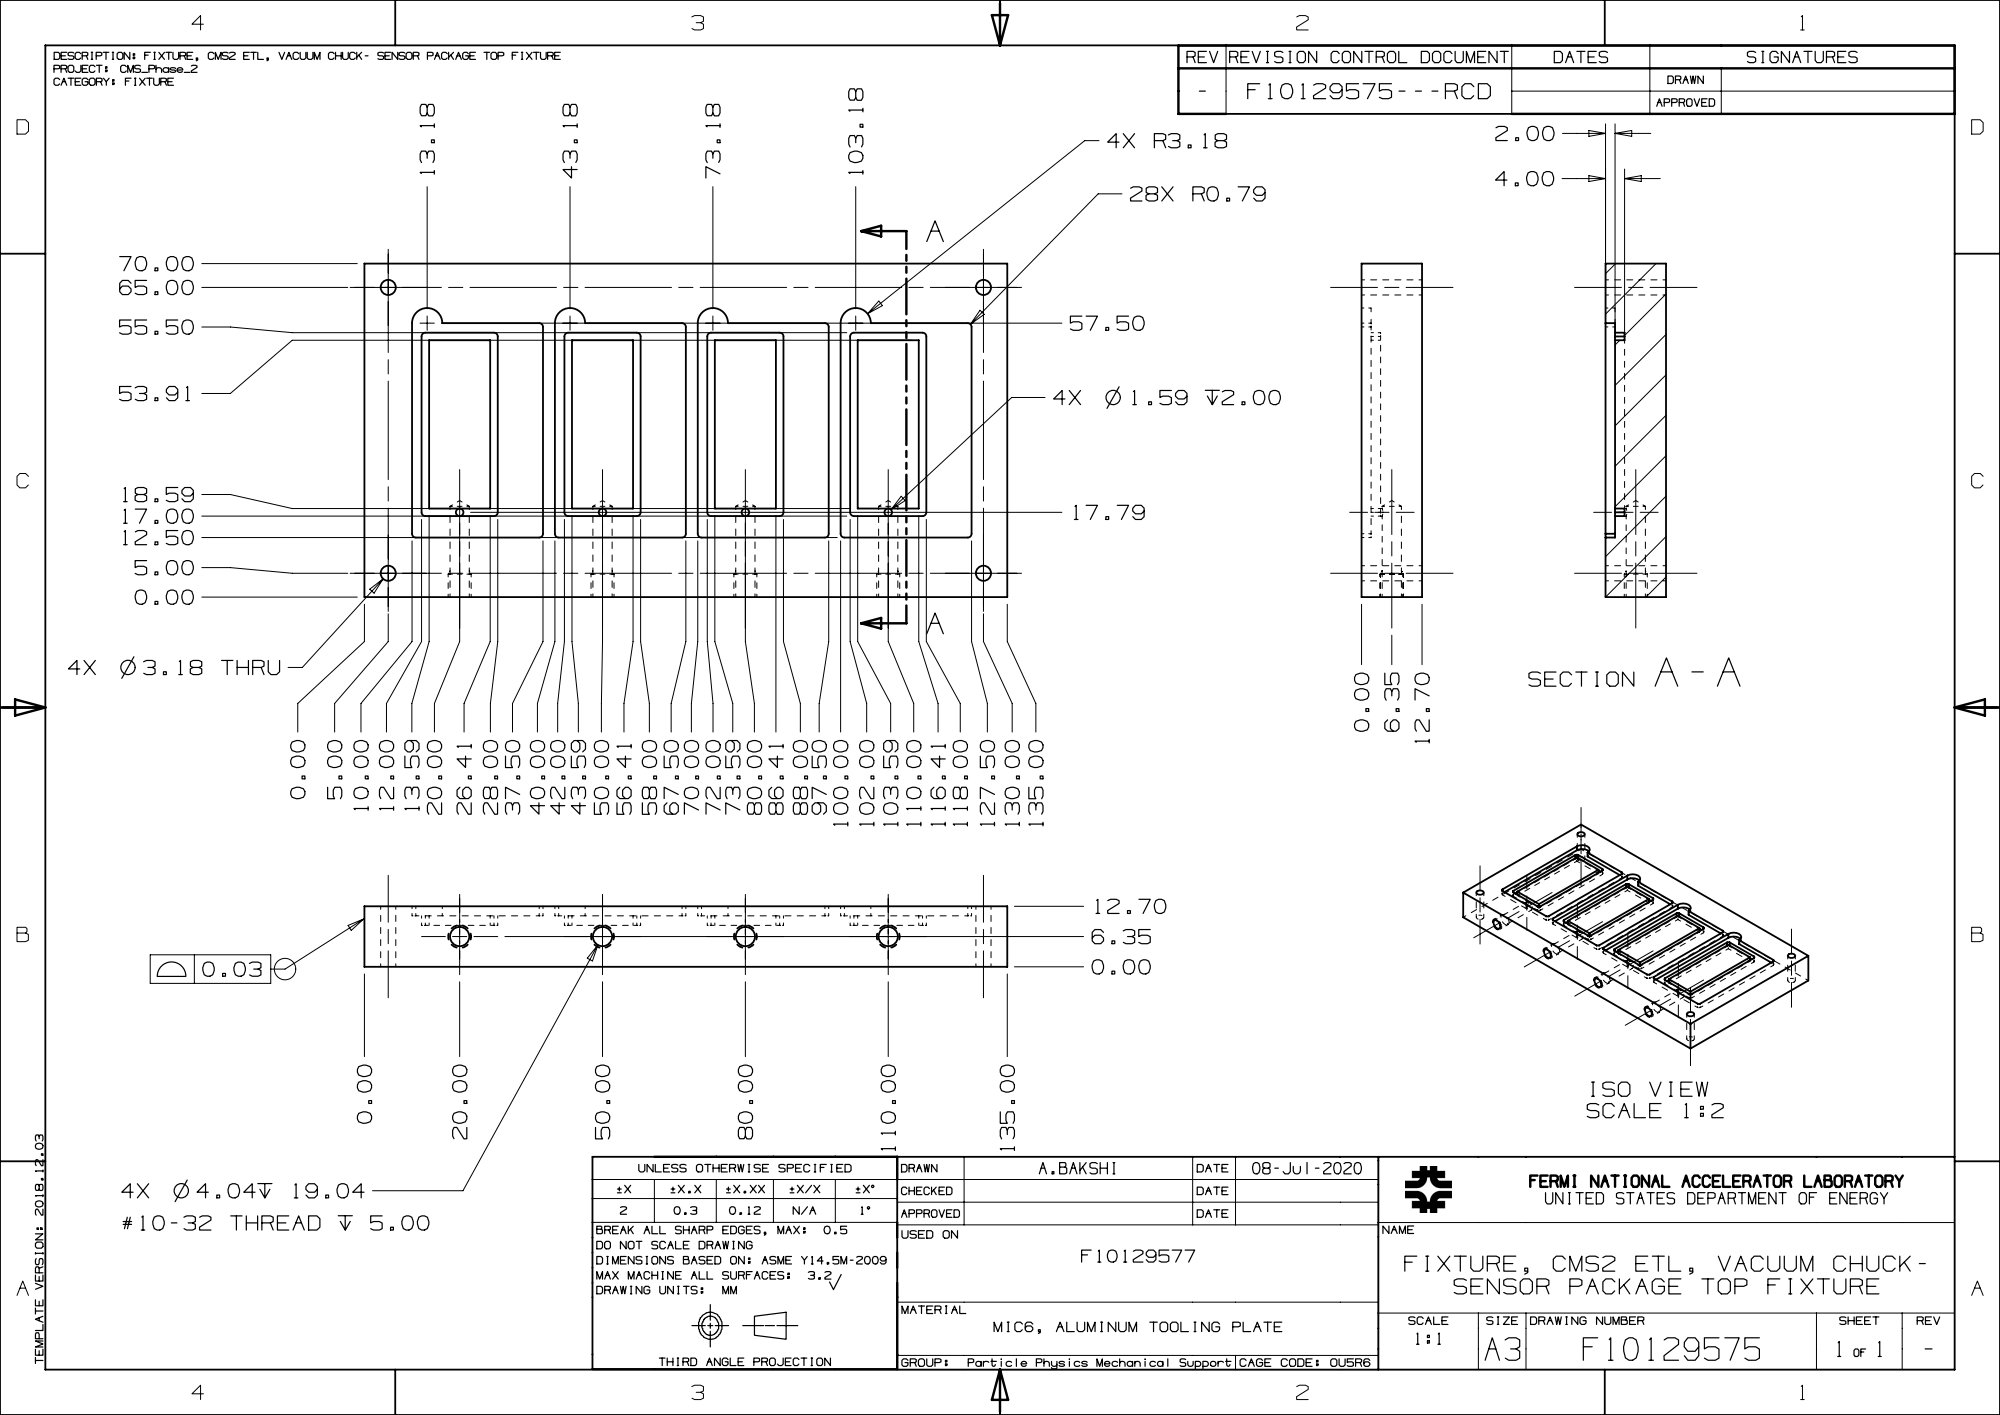
[picture p71: page 1]
