nebraska-silicon-lab/Hardware/ETL/FNAL Tooling Designs/Chuck/F10129576_-_PDF_1.pdf

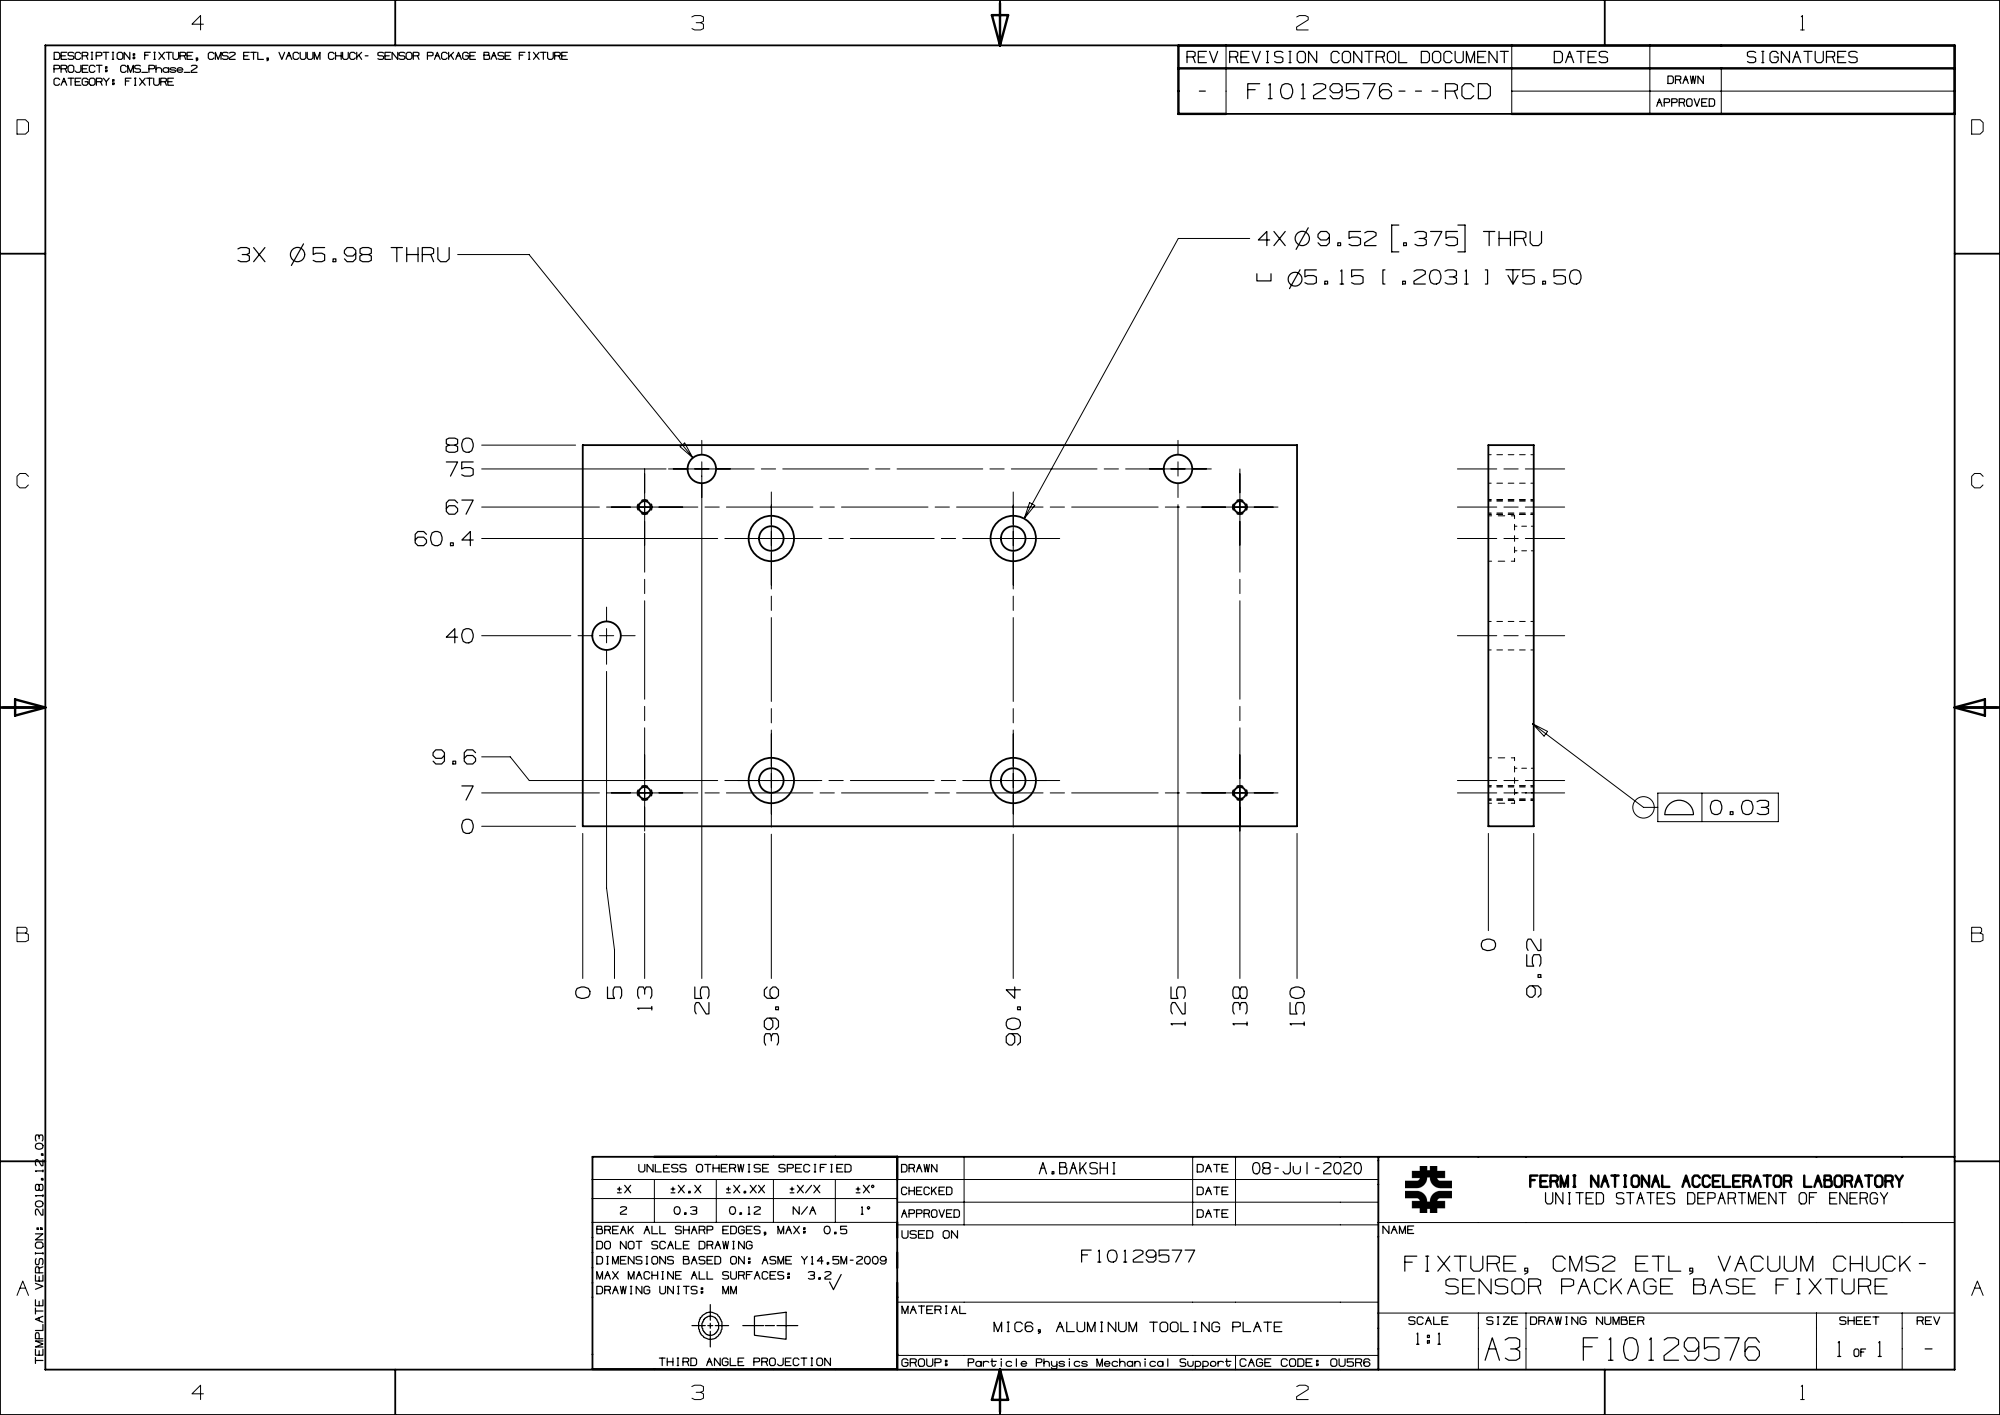
[picture p72: page 1]
