nebraska-silicon-lab/Hardware/General Gantry/Gantry Hub/Hub Router PCB/Hub Router PCB.kicad_pcb

## KiCad design General Gantry/Gantry Hub/Hub Router PCB/Hub Router PCB.kicad_pcb (2024-06-12)

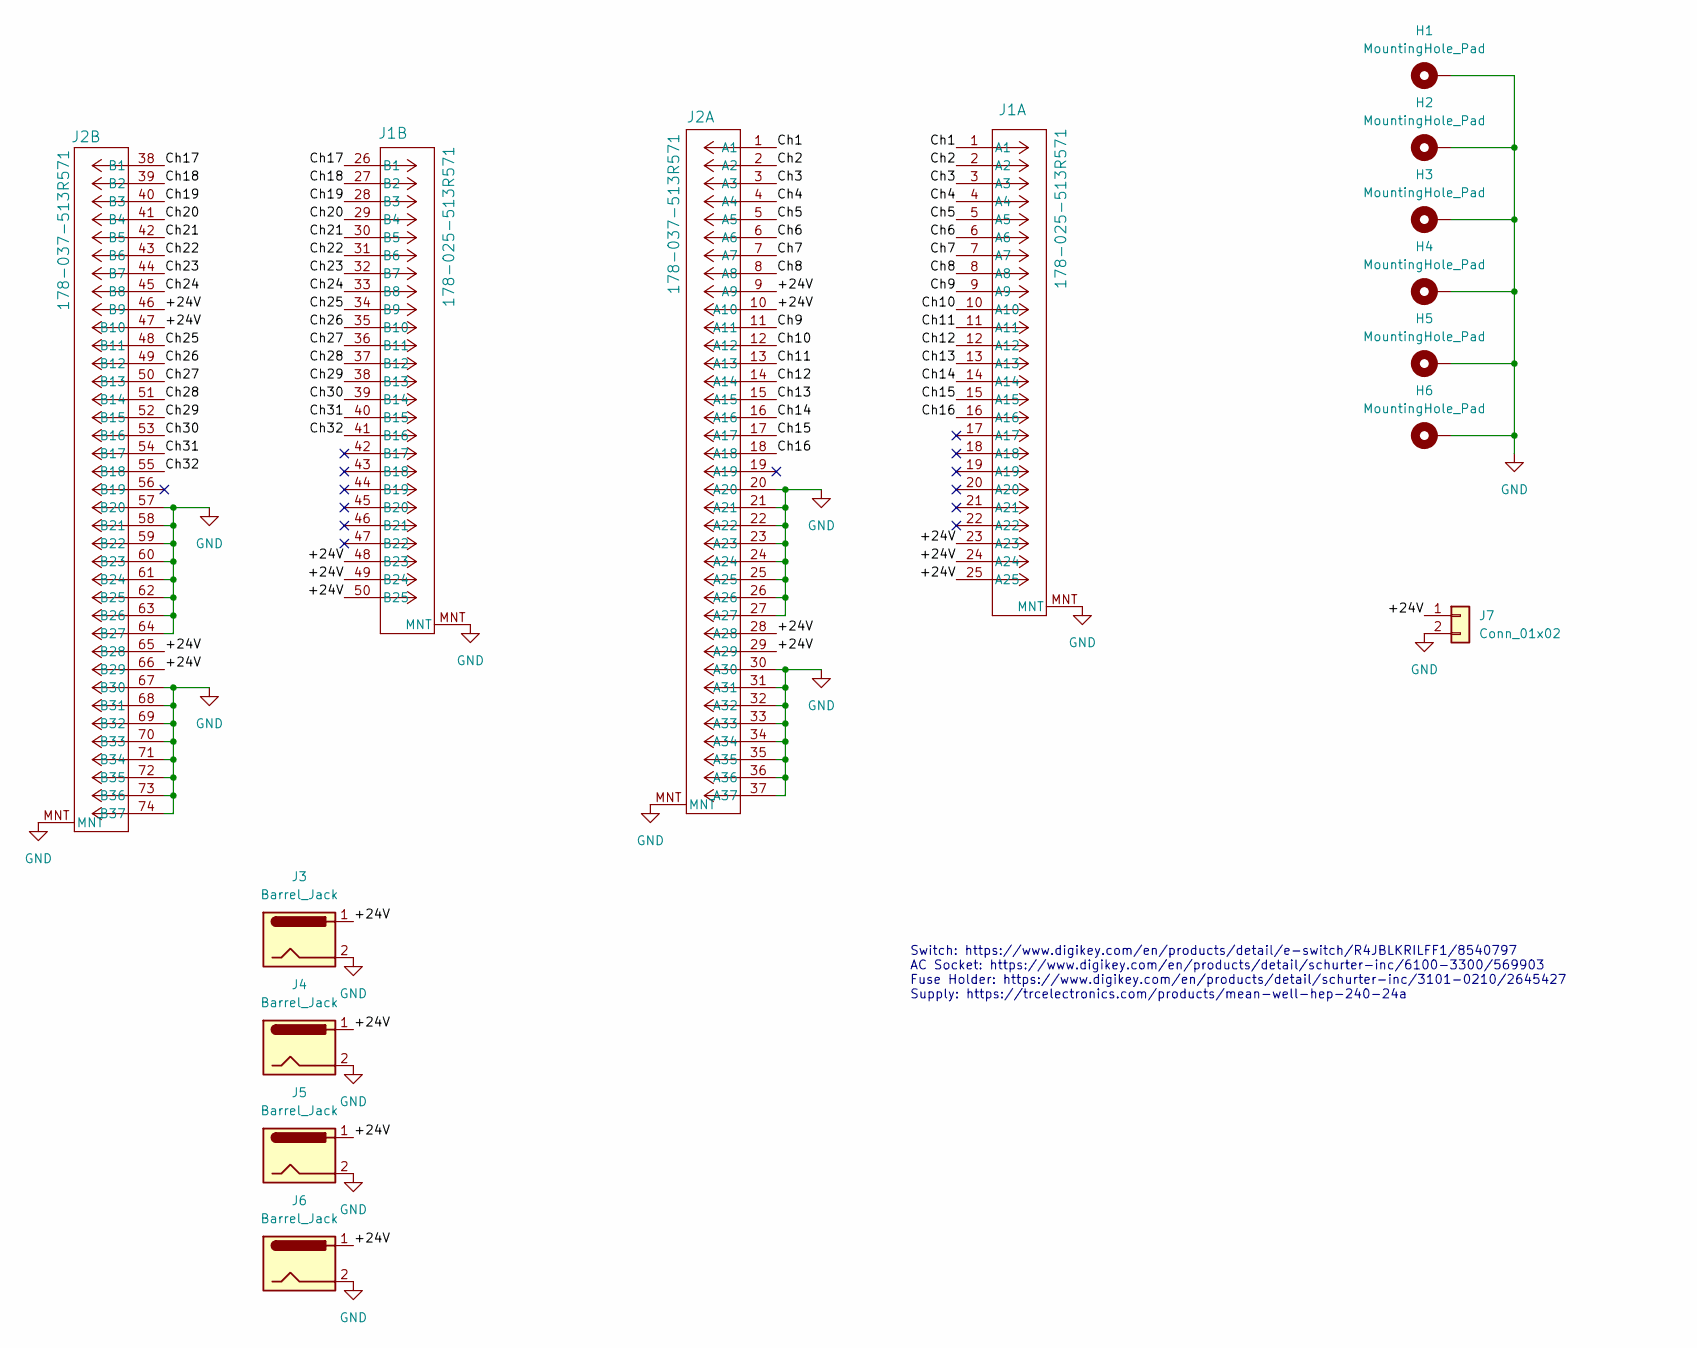
[picture p73: schematic Hub Router PCB.kicad_sch]

Parts:
H1, H2, H3, H4, H5, H6: MountingHole_Pad; MountingHole_3.2mm_M3_Pad_Via
J1: 178-025-513R571; CONN_178-025-513_NRC
J2: 178-037-513R571; CONN_178-037-513R571_NRC
J3, J4, J5, J6: Barrel_Jack; CUI PJ-037A
J7: Conn_01x02; HUB PCB Power Pads

Connections:
/+24V: J1.23 (A23), J1.24 (A24), J1.25 (A25), J1.48 (B23), J1.49 (B24), J1.50 (B25), J2.9 (A9), J2.10 (A10), J2.28 (A28), J2.29 (A29), J2.46 (B9), J2.47 (B10), J2.65 (B28), J2.66 (B29), J3.1, J4.1, J5.1, J6.1, J7.1
/Ch1: J1.1 (A1), J2.1 (A1)
/Ch2: J1.2 (A2), J2.2 (A2)
/Ch3: J1.3 (A3), J2.3 (A3)
/Ch4: J1.4 (A4), J2.4 (A4)
/Ch5: J1.5 (A5), J2.5 (A5)
/Ch6: J1.6 (A6), J2.6 (A6)
/Ch7: J1.7 (A7), J2.7 (A7)
/Ch8: J1.8 (A8), J2.8 (A8)
/Ch9: J1.9 (A9), J2.11 (A11)
/Ch10: J1.10 (A10), J2.12 (A12)
/Ch11: J1.11 (A11), J2.13 (A13)
/Ch12: J1.12 (A12), J2.14 (A14)
/Ch13: J1.13 (A13), J2.15 (A15)
/Ch14: J1.14 (A14), J2.16 (A16)
/Ch15: J1.15 (A15), J2.17 (A17)
/Ch16: J1.16 (A16), J2.18 (A18)
/Ch17: J1.26 (B1), J2.38 (B1)
/Ch18: J1.27 (B2), J2.39 (B2)
/Ch19: J1.28 (B3), J2.40 (B3)
/Ch20: J1.29 (B4), J2.41 (B4)
/Ch21: J1.30 (B5), J2.42 (B5)
/Ch22: J1.31 (B6), J2.43 (B6)
/Ch23: J1.32 (B7), J2.44 (B7)
/Ch24: J1.33 (B8), J2.45 (B8)
/Ch25: J1.34 (B9), J2.48 (B11)
/Ch26: J1.35 (B10), J2.49 (B12)
/Ch27: J1.36 (B11), J2.50 (B13)
/Ch28: J1.37 (B12), J2.51 (B14)
/Ch29: J1.38 (B13), J2.52 (B15)
/Ch30: J1.39 (B14), J2.53 (B16)
/Ch31: J1.40 (B15), J2.54 (B17)
/Ch32: J1.41 (B16), J2.55 (B18)
GND: H1.1, H2.1, H3.1, H4.1, H5.1, H6.1, J1.MNT, J2.20 (A20), J2.21 (A21), J2.22 (A22), J2.23 (A23), J2.24 (A24), J2.25 (A25), J2.26 (A26), J2.27 (A27), J2.30 (A30), J2.31 (A31), J2.32 (A32), J2.33 (A33), J2.34 (A34), J2.35 (A35), J2.36 (A36), J2.37 (A37), J2.57 (B20), J2.58 (B21), J2.59 (B22), J2.60 (B23), J2.61 (B24), J2.62 (B25), J2.63 (B26), J2.64 (B27), J2.67 (B30), J2.68 (B31), J2.69 (B32), J2.70 (B33), J2.71 (B34), J2.72 (B35), J2.73 (B36), J2.74 (B37), J2.MNT, J3.2, J4.2, J5.2, J6.2, J7.2

Notes on the sheet:
Switch: https://www.digikey.com/en/products/detail/e-switch/R4JBLKRILFF1/8540797 AC Socket: https://www.digikey.com/en/products/detail/schurter-inc/6100-3300/569903 Fuse Holder: https://www.digikey.com/en/products/detail/schurter-inc/3101-0210/2645427 Supply: https://trcelectronics.com/products/mea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

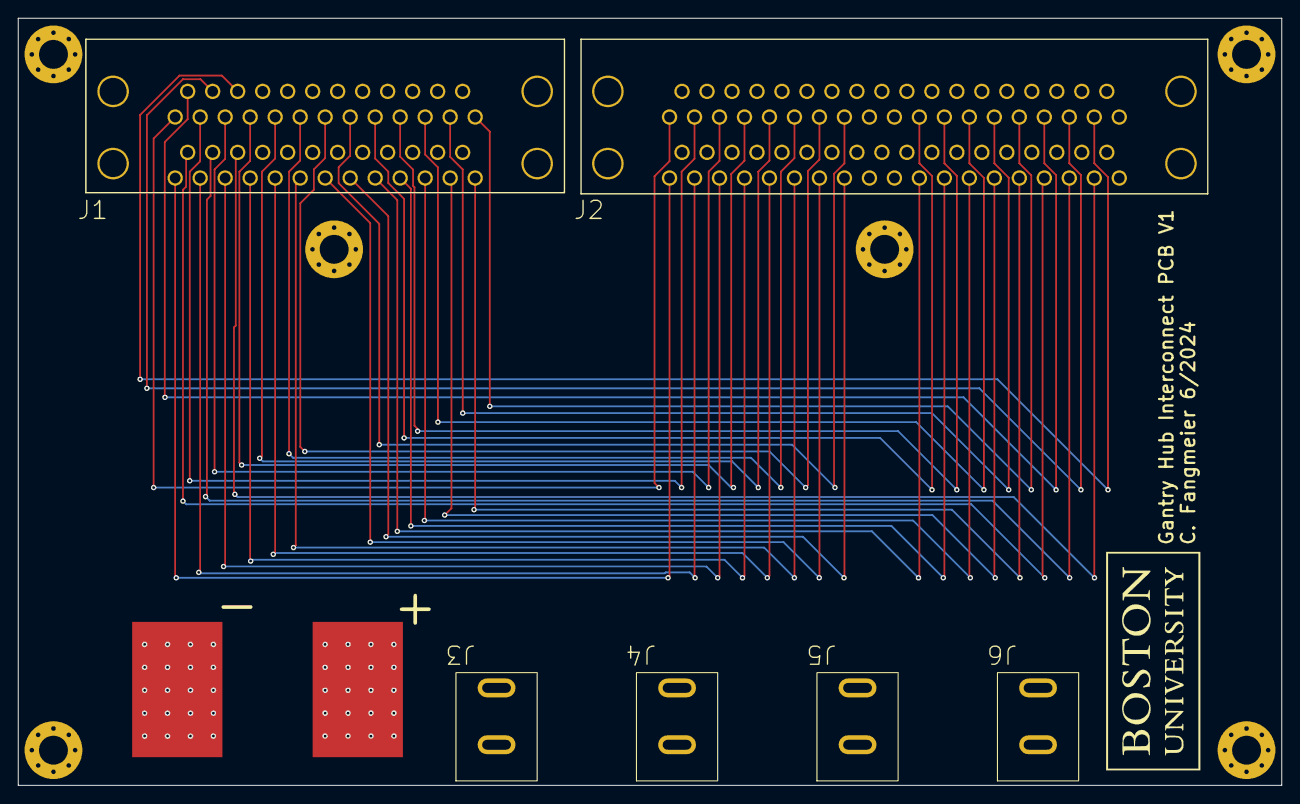
[picture p74: board Hub Router PCB.kicad_pcb from above]

Board: 4 copper layers, 140.0 x 85.0 mm, 13 parts (0 on the bottom side), 34 nets.
