nebraska-silicon-lab/Hardware/(commit log)

2020-06-05 Adds partial thermal conductivity tester design
    [thermal_cond_tester.FCStd]
2020-06-05 Adds cold side of ETL thermal tester
    [thermal_cond_tester.FCStd]
2020-06-09 Adds shelf layout for new dry air cabinet
    [bigcab-shelf_layout.FCStd]
2020-07-22 Adds drawings of Phase I gantry tooling
    [5454K63_0.125ID_Tube_Barb.ipt, 5454K740_0.0625ID_Tube_Barb.ipt, 84985A15.iam, 84985A58.iam, 91251A831.ipt, 91772A030.ipt, 92125A211.ipt, 92210A151.ipt]
2020-07-22 Adds ETL Chuck prototype design
    [F10112938--_1-MODULE_ CMS2 ETL_ SENSOR COVER PLT.ipt, F10129336--_1-ASSY_ CMS2 ETL_ AL-N BASEPLATE HOLDING ASSEMBLY.stp, F10129572--_1-FIXTURE_ CMS2 ETL_ AL-N BASEPLATE HOLDING BASE FIXTURE1.stp, F10129574--_1-FIXTURE_ CMS2 ETL_ AL-N BASEPLATE HOLDING TOP FIXTURE2.stp, F10129575--_1-FIXTURE_ CMS2 ETL_ VACUUM CHUCK- SENSOR PACKAGE TOP FIXTURE.ipt, F10129575--_1-FIXTURE_ CMS2 ETL_ VACUUM CHUCK- SEN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]
2020-07-29 Adds modified Tool Holder
    [ToolHolder1.STEP]
2020-08-03 Adds Phase II dry air cabinet drawing
    [bigcab-shelf_layout.FCStd]
2020-08-26 Adds ASIC Alignment Tool.stp
    [ASIC Alignment Tool.stp]
2020-09-21 module engineering drawings, tdr design, version 1
    [F10110887--_1-MODULE_ CMS2 ETL_ FULL DBL-SENSOR MOUNTED ASSY.stp, F10110887--_1-MODULE_ CMS2 ETL_ HALF-SENSOR MOUNTED ASSY.stp]
2020-09-22 Adds disk section and Phase II Tool Holder
    [ASIC Alignment Tool.stp, ETL thermal mockup.iam, F10129336--_1-ASSY_ CMS2 ETL_ AL-N BASEPLATE HOLDING ASSEMBLY.stp, F10129572--_1-FIXTURE_ CMS2 ETL_ AL-N BASEPLATE HOLDING BASE FIXTURE1.stp, F10129574--_1-FIXTURE_ CMS2 ETL_ AL-N BASEPLATE HOLDING TOP FIXTURE2.stp, F10129575--_1-FIXTURE_ CMS2 ETL_ VACUUM CHUCK- SENSOR PACKAGE TOP FIXTURE.stp, F10129576--_1-FIXTURE_ CMS2 ETL_ VACUUM CHUCK- SENSOR P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]
2020-10-10 tdr drawings of SH
    [F10110887--_1-MODULE_ CMS2 ETL_ FULL DBL-SENSOR MOUNTED ASSY.stp, F10110887--_1-MODULE_ CMS2 ETL_ HALF-SENSOR MOUNTED ASSY.stp]
2020-10-10 move files
    [F10110887--_1-MODULE_ CMS2 ETL_ FULL DBL-SENSOR MOUNTED ASSY.stp, F10110887--_1-MODULE_ CMS2 ETL_ HALF-SENSOR MOUNTED ASSY.stp]
2020-11-13 Adds Pull Tester, ETL Glue Reservoir, and Glue Spreader Jig
    [8472A110_PRESS-FIT LOCATING PIN.STEP, 8472A110_PRESS-FIT LOCATING PIN.ipt, 8472A190_PRESS-FIT LOCATING PIN.STEP, 8472A190_PRESS-FIT LOCATING PIN.ipt, 90128A211_ZNC-PLTD ALLOY STL SCKT HEAD CAP SCREW.STEP, 90128A211_ZNC-PLTD ALLOY STL SCKT HEAD CAP SCREW.ipt, 90128A263_ZNC-PLTD ALLOY STL SCKT HEAD CAP SCREW.STEP, 90128A263_ZNC-PLTD ALLOY STL SCKT HEAD CAP SCREW.ipt]
2020-11-13 Updates to glue spreader
    [Assembly1.0004.iam, Assembly1.0005.iam, Assembly1.iam, main body.0004.ipt, main body.0006.ipt, main body.ipt]
2021-01-08 Moves Phase I documents to "FPIX"
    [Baugruppe1.iam, Baugruppe1.idw, Delvotec-Saughalterung.ipt, SuctionblockDelcotec.iam, UNLHEP-14-01-A-001_BonderChuckWplate.iam, UNLHEP-14-01-A-002_GantryChuckWplate.iam, UNLHEP-14-01-A-003_ChuckW4modules.iam, UNLHEP-14-01-A-004_ChuckOnTrspChuck.iam]
2021-01-08 Adds ETL Stamp, Grabber Tool, and Picker Tool
    [1795N140_STATIC-DISSIPATIVE VACUUM CUP.STEP, 1795N140_STATIC-DISSIPATIVE VACUUM CUP.ipt, 91292A113_TYPE 18-8 SS SOCKET HEAD CAP SCREW.STEP, 91292A113_TYPE 18-8 SS SOCKET HEAD CAP SCREW.ipt, 91590A115_STAINLESS STEEL EXTERNAL RETAINING RING.STEP, 91590A115_STAINLESS STEEL EXTERNAL RETAINING RING.ipt, 91828A211_TYPE 18-8 STAINLESS STEEL HEX NUT.STEP, 91828A211_TYPE 18-8 STAINLESS STEEL HEX NUT.ipt]
2021-01-08 Finishes designs of Picker Tool
    [91290A119_BLACK-OXIDE CLASS 12.9 SOCKET HEAD CAP SCREW.STEP, 91290A119_BLACK-OXIDE CLASS 12.9 SOCKET HEAD CAP SCREW.ipt, 92220A311_ALLOY STEEL LOW-PROFILE SOCKET HEAD SCREW.STEP, 92220A311_ALLOY STEEL LOW-PROFILE SOCKET HEAD SCREW.ipt, 9452K160_OIL-RESISTANT BUNA-N MULTIPURPOSE O-RING.STEP, 9452K160_OIL-RESISTANT BUNA-N MULTIPURPOSE O-RING.ipt, Picker Tool.0005.iam, Picker Tool.0007.iam]
2021-01-12 Adds designs for gantry fixtures (chuck and plates) for ETL module assembly
    [44555K151_BRASS BARBED TUBE FITTING FOR VACUUM.0001.ipt, 44555K151_BRASS BARBED TUBE FITTING FOR VACUUM.STEP, 44555K151_BRASS BARBED TUBE FITTING FOR VACUUM.ipt, 90128A212_ZNC-PLTD ALLOY STL SCKT HEAD CAP SCREW.STEP, 90128A212_ZNC-PLTD ALLOY STL SCKT HEAD CAP SCREW.ipt, 90128A253_ZNC-PLTD ALLOY STL SCKT HEAD CAP SCREW.STEP, 90128A253_ZNC-PLTD ALLOY STL SCKT HEAD CAP SCREW.ipt, Assembly Plate Asse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]
2021-01-12 Adds adjustable mounting for ETL chucks
    [4464K562_TYPE 304 STAINLESS STL THREADED PIPE FITTING.STEP, 4464K562_TYPE 304 STAINLESS STL THREADED PIPE FITTING.ipt, Assembly Plate Assembly.0005.iam, Assembly Plate Assembly.iam, Chuck Assembly.0001.iam, Chuck Assembly.0004.iam, Chuck Assembly.0005.iam, Chuck Assembly.iam]
2021-01-14 Updates Pull tester for new chuck design
    [8472A110_PRESS-FIT LOCATING PIN.STEP, 8472A110_PRESS-FIT LOCATING PIN.ipt, 8472A190_PRESS-FIT LOCATING PIN.STEP, 8472A190_PRESS-FIT LOCATING PIN.ipt, 90128A211_ZNC-PLTD ALLOY STL SCKT HEAD CAP SCREW.STEP, 90128A263_ZNC-PLTD ALLOY STL SCKT HEAD CAP SCREW.STEP, Assembly Plate Assembly.0005.iam, Assembly Plate Assembly.0006.iam]
2021-01-15 Adds Assembly Plate drawings
    [Assembly Plate Assembly.0003.iam, Assembly Plate Assembly.0006.iam, Assembly Plate Assembly.0009.iam, Assembly Plate Assembly.iam, Assembly Plate.0001.dwg, Assembly Plate.0002.ipt, Assembly Plate.0003.ipt, Assembly Plate.dwg]
2021-01-20 Adds Wirebonder chuck design (and moves everything under 1 inventor project)
    [44555K151_BRASS BARBED TUBE FITTING FOR VACUUM.STEP, 44555K151_BRASS BARBED TUBE FITTING FOR VACUUM.ipt, 4464K562_TYPE 304 STAINLESS STL THREADED PIPE FITTING.STEP, 4464K562_TYPE 304 STAINLESS STL THREADED PIPE FITTING.ipt, 90128A211_ZNC-PLTD ALLOY STL SCKT HEAD CAP SCREW.ipt, 90128A212_ZNC-PLTD ALLOY STL SCKT HEAD CAP SCREW.STEP, 90128A216_ZNC-PLTD ALLOY STL SCKT HEAD CAP SCREW.ipt, 90128A253_ZN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]
2021-01-23 Updates pull tester to make everything fit together
    [92421A642_BRASS FLARED-COLLAR KNURLED-HEAD THUMB SCREWS.ipt, Chuck.ipt, FTK100.ipt, PUll Tester with ETL Plate.iam, PUll Tester with TFPX Plate.iam, Pull Tester.iam, step_12692.ipt]
2021-01-27 Simplifies assembly plate design
    [Assembly Plate Assembly.0009.iam, Assembly Plate Assembly.iam, Assembly Plate.0003.ipt, Assembly Plate.ipt, Board_Geoms_e3a6.iam, Board_Geoms_e720.iam, Chuck Assembly.0005.iam, Chuck Assembly.iam]
2021-01-28 Updates ETL Modules Carrier
    [99607A272_SS FLARED-COLLAR KNURLED-HEAD THUMB SCREW.ipt, Assembly Plate Assembly.iam, Assembly Plate with Cover.iam, Assembly Plate.ipt, Chuck Assembly.0001.iam, Chuck Assembly.iam, Chuck.0014.ipt, Chuck.dwg]
2021-02-04 Adds blank work orders and README of how to do
    [ETL_blank_workorder.xlsx, TFPX_blank_workorder.xlsx]
2021-02-04 Adds Camera+Stand to pull tester
    [49985A240_ANY-WHICH-WAY POSITIONING ARM.ipt, 49985A250_ANY-WHICH-WAY POSITIONING ARM.ipt, Camera Clip.ipt, Camera with Clip.iam, Camera.ipt, Pull Tester.iam]
2021-02-05 Adds electronics shop blank work orders
    [ETL_blank_elec_workorder.xlsx, ETL_blank_inst_workorder.xlsx, TFPX_blank_elec_workorder.xlsx, TFPX_blank_inst_workorder.xlsx]
2021-02-08 Add simple weight for HDI with more holes
2021-02-12 Minor updates to ETL designs
    [Assembly Plate Assembly.iam, Assembly Plate Assembly.stp, BBM Staging Plate Assembly.0002.iam, BBM Staging Plate Assembly.iam, Chuck Assembly.iam, ETL thermal mockup.iam, ST1189262_01.ipt, ST1189731_01.ipt]
2021-02-22 Adds  2021_02_ETL_Second-Cooling-Plate.pdf
2021-03-05 Adds Chuck V2 and knock-on changes
    [44555K147_BRASS BARBED TUBE FITTING FOR VACUUM.ipt, 44555K151_BRASS BARBED TUBE FITTING FOR VACUUM.ipt, 4464K561_TYPE 304 STAINLESS STL THREADED PIPE FITTING.ipt, 4464K562_TYPE 304 STAINLESS STL THREADED PIPE FITTING.ipt, 90128A212_ZNC-PLTD ALLOY STL SCKT HEAD CAP SCREW.ipt, 90128A253_ZNC-PLTD ALLOY STL SCKT HEAD CAP SCREW.ipt, Assembly with Weights.iam, BBM Staging Plate Assembly.iam]
2021-03-08 Adds updated gantry chuck designs
    [44555K147_BRASS BARBED TUBE FITTING FOR VACUUM.ipt, 4464K561_TYPE 304 STAINLESS STL THREADED PIPE FITTING.ipt, 90128A212_ZNC-PLTD ALLOY STL SCKT HEAD CAP SCREW.ipt, 90128A253_ZNC-PLTD ALLOY STL SCKT HEAD CAP SCREW.ipt, Chuck - Octopocket.iam, Chuck - Octopocket.ipt, Chuck - OctopocketF.iam, Chuck - OctopocketF.ipt]
2021-03-09 Updates TFPX Wirebonding plate dimensions to be consistent with available stock materials
    [BBM.ipt, HDI on BBM.iam, HDI.ipt, Plate Assembly.0001.iam, Plate Assembly.iam, TFPX Plate.0004.ipt, TFPX Plate.ipt, pad alignment.ipt]
2021-04-07 Updates to ETL Module Assembly tooling for easier fabrication
    [BBM Staging Plate Assembly.iam, BBM Staging Plate Assembly.stp, BBM Staging Plate Stencil.0005.ipt, BBM Staging Plate Stencil.ipt, BBM Staging Plate.ipt, Chuck - Octopocket.iam, Chuck - Octopocket.ipt, Chuck - Octopocket.stp]
2021-04-21 Adds TFPX Module Carrier
    [Carrier.ipt, Plate Assembly.iam]
2021-04-21 Updates to tool holder
    [9396K153 Silicone O-Ring .ipt, 9396K27 Silicone O-Ring.ipt, Tool Holder Assembly.iam, ToolHolder1.STEP, ToolHolder1.ipt]
2021-04-21 Updates to ETL Module Assembly
    [Assembly Plate - boss mounting.dwg, Assembly Plate - boss mounting.iam, Assembly Plate - boss mounting.ipt, BBM Staging Plate Assembly.iam, Chuck - Octopocket.iam, Chuck - Octopocket.ipt, Cover.ipt, Gantry Table With Chucks - V2.iam]
2021-05-21 Updates FNAL chucks to match V2 design and adds FNAL tool holder adapter
    [44555K147_BRASS BARBED TUBE FITTING FOR VACUUM.ipt, 44555K151_BRASS BARBED TUBE FITTING FOR VACUUM.0001.ipt, 4464K561_TYPE 304 STAINLESS STL THREADED PIPE FITTING.ipt, 90128A212_ZNC-PLTD ALLOY STL SCKT HEAD CAP SCREW.ipt, 90128A253_ZNC-PLTD ALLOY STL SCKT HEAD CAP SCREW.ipt, Chuck - Multipocket.ipt, Chuck - OctopocketF.iam, Chuck - OctopocketF.ipt]
2021-07-19 Many updates - including Tamale Assembly Plate
    [90910A443_BUTTON HEAD TORX SCREWS.ipt, 91585A353_18-8 STAINLESS STEEL DOWEL PIN.STEP, 91585A353_18-8 STAINLESS STEEL DOWEL PIN.ipt, Assembly with Weights.iam, Board to board, F.ipt, Bottom Surface.stp, Chuck - OctopocketF.stp, Chuck - V2F.stp]
2021-09-08 Adds updates TFPX weight tool
    [cpc_module_weight_tool_1x2_v2 - modified.ipt, cpc_module_weight_tool_1x2_v2 - original.ipt]
2021-09-08 Adds ETL Jig designs
    [F10148122--_1-ASSY_ CMS2 ETL_ SENSOR _ FLEX FILMS MONUTING ASSY.stp, F10148123--_1-FIXTURE_ CMS2 ETL_ AL-N BASE HOLDING FIXTURE.stp, F10148124--_1-FIXTURE_ CMS2 ETL_ SENSOR FILM HOLDING FIXTURE.stp, F10148125--_1-ASSY_ CMS2 ETL_ SENSOR FILM HOLDING FIXTURE ASSY.stp, F10161928--_1-FIXTURE_ CMS2 ETL_ 16X16 SENSOR SUB-ASSY ALIGNMENT FIXTURE.stp, F10161929--_1-PIN_ CMS2 ETL_ 16X16 FIXTURE ALIGNMENT P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]
2021-10-14 Updates ETL Tamale assembly plate design
    [90910A443_BUTTON HEAD TORX SCREWS.ipt, 91585A353_18-8 STAINLESS STEEL DOWEL PIN.STEP, 91585A353_18-8 STAINLESS STEEL DOWEL PIN.ipt, 95278-501A10LF.iam, Board to board, F.ipt, COMPOUND.ipt, COMPOUND_1.ipt, COMPOUND_2.ipt]
2021-10-29 Adds MilliQan PMT mounts and wrap patterns
    [4880K76_Standard-Wall PVC Pipe Fitting for Water.STEP, 5372K161_Plastic Barbed Tube Fitting for Air and Water.STEP, 8627K91_White Delrin® Acetal Resin Tube.STEP, 8627K91_White Delrin® Acetal Resin Tube.ipt, Slab Mount Assembly - Fabricated - V1.iam, Slab Template- 1 piece v1.f3d, Slab Template- 1 piece v2.ipt, Slab Template- 1 piece v2.step]
2021-11-08 Adds designs for fabricated PMT mounts & associated work order
    [4880K76_Standard-Wall PVC Pipe Fitting for Water.STEP, 4880K76_Standard-Wall PVC Pipe Fitting for Water.ipt, 5372K161_Plastic Barbed Tube Fitting for Air and Water.STEP, 8585K291_Impact-Resistant Polycarbonate Round Tube.STEP, 8585K291_Impact-Resistant Polycarbonate Round Tube.ipt, 8627K91_White Delrin® Acetal Resin Tube.STEP, 8627K91_White Delrin® Acetal Resin Tube.ipt, Adapter.ipt]
2021-11-09 Adds V2 designs of various ETL gantry hardware
    [44555K147_BRASS BARBED TUBE FITTING FOR VACUUM.ipt, 4464K561_TYPE 304 STAINLESS STL THREADED PIPE FITTING.ipt, 90128A212_ZNC-PLTD ALLOY STL SCKT HEAD CAP SCREW.ipt, 90128A253_ZNC-PLTD ALLOY STL SCKT HEAD CAP SCREW.ipt, Assembly Plate Assembly.iam, BBM Staging Plate - V2.ipt, BBM Staging Plate Assembly - V2.iam, BBM Staging Plate Stencil - V2.ipt]
2021-12-01 Adds ETL Baseplate Staging Plate
    [8472A51_Locating Pin.STEP, 8472A51_Locating Pin.ipt, BBM Staging Plate - V2.ipt, BBM Staging Plate Assembly - V2.iam, BBM Staging Plate Stencil - V2.ipt, Baseplate Staging Plate - V1.ipt, Baseplate Staging Plate Assembly - V1.iam, Chuck - 16-pocket.iam]
2021-12-01 Replaces "locating pins" with simple dowel pins in the Baseplate Staging Plate - V1
    [8472A51_Locating Pin.STEP, 8472A51_Locating Pin.ipt, 98381A304_Dowel Pin.STEP, 98381A304_Dowel Pin.ipt, Baseplate Staging Plate - V1.ipt, Baseplate Staging Plate Assembly - V1.iam]
2022-01-28 Adds recent work - Mostly ETL gantry tooling
    [43685K12_Low-Pressure Socket-Connect Unthreaded Pipe Fitting.STEP, 43685K12_Low-Pressure Socket-Connect Unthreaded Pipe Fitting.ipt, 4378K512_Thin-Wall 316 316L Stainless Steel Unthreaded Pipe.STEP, 4378K512_Thin-Wall 316 316L Stainless Steel Unthreaded Pipe.ipt, 4813K469_Standard-Wall 304 304L Stainless Steel Pipe.STEP, 4813K469_Standard-Wall 304 304L Stainless Steel Pipe.ipt, 91290A184_Black-Ox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]
2022-02-09 Adds updated tamale design CAD file
    [BBM.iam, ETL Sensor.ipt, ETROC2.ipt, K3D-WP7B-P050VA1-V3_JAE_Proprietary v1_11.iam, Mock Module PCB - V2.iam, Mock Module PCB - V2.ipt, Mock Module PCB.iam, Mock Module PCB.ipt]
2022-02-10 Updates to Pull Tester
    [46555K747_On Off Valve for Chemicals.STEP, 46555K747_On Off Valve for Chemicals.ipt, 7397N48_Universal-Thread Push-to-Connect Tube Fittings.STEP, 7397N48_Universal-Thread Push-to-Connect Tube Fittings.ipt, Chuck.ipt, Pull Tester.iam, Royce 610 Base.ipt]
2022-02-14 updates Grabber tool V2 and adds Glue Reservoir Plate V2
    [Glue Reservoir Plate - V2.iam, Glue Reservoir Plate - V2.ipt, Glue Reservoir Plate - V2.stp, Grabber Tool - V2.iam, Grabber Tool - V2.stp]
2022-02-14 Adds Glue Reservoir Work Order
2022-02-23 Adds prospective wirebond pad patterns to Tamale mockup
    [BBM.iam, ETL Sensor.ipt, ETROC2.ipt, Mock Module PCB - V2p1.iam, Mock Module PCB - V2p1.ipt, Short Wirebond.ipt, Tamale - V1.iam, Tamale - V1p1.iam]
2022-03-23 Updates to ETL tooling and module designs
    [5427A624_Vacuum Cup.ipt, 91251A550_Black-Oxide Alloy Steel Socket Head Screw.STEP, 91771A054_Passivated 18-8 Stainless Steel Phillips Flat Head Screw.STEP, 91771A054_Passivated 18-8 Stainless Steel Phillips Flat Head Screw.ipt, Assembly Plate PCB.ipt, Assembly Plate PCB.step, BBM.iam, Baseplate Extended.ipt]
2022-03-24 Updates ETL cost objects in work orders
    [ETL_blank_elec_workorder.xlsx, ETL_blank_inst_workorder.xlsx]
2022-03-24 Adds ETL Tamale Assembly Plate V3
    [5427A624_Vacuum Cup.ipt, 90910A443_BUTTON HEAD TORX SCREWS.ipt, Tamale Assembly Plate Assembly V3.iam, Tamale Assembly Plate V3.ipt, spacer.ipt]
2022-03-29 Final touches on Tamale Assembly Plate V3
    [Tamale Assembly Plate Assembly V3.iam, Tamale Assembly Plate V3.ipt]
2022-04-04 Adds ETL Module Tamale v1.3
    [BBM.iam, Baseplate v1.3.ipt, Coverplate Film.ipt, ETL Sensor.ipt, ETROC2.ipt, K3D-WP7B-P050VA1-V3_JAE_Proprietary v1_11.iam, Long Wirebond A.ipt, Long Wirebond B.ipt]
2022-04-07 Updates to Tamale v1p3
    [90910A910_Button Head Torx Screws.STEP, 91292A004_18-8 Stainless Steel Socket Head Screw.STEP, Baseplate v1.3.ipt, Tamale - v1p3.iam]
2022-04-14 Adds initial ideas for module carrier designs
    [91185A570_Plastic-Head Thumb Screws.STEP, 91185A570_Plastic-Head Thumb Screws.ipt, Carrier Clip V1.ipt, Carrier Plate V1.ipt, ETL Module Carrier V1.iam]
2022-04-20 Adds TFPX Platform A
    [Platform A.ipt, Platform A.stp]
2022-04-20 Adds updates to Milliqan PMT Mounts
    [48925K96_Standard-Wall Unthreaded Rigid PVC Pipe for Water.STEP, 48925K96_Standard-Wall Unthreaded Rigid PVC Pipe for Water.ipt, Slab Mount Assembly - Fabricated - V2.iam, Slab Mount Assembly - Fabricated - V2.stp, U Channel.ipt]
2022-04-20 Adds V1 ETL Module Carrier
    [91185A559_Plastic-Head Thumb Screws.STEP, 91185A559_Plastic-Head Thumb Screws.ipt, 91770A073_Extra-Wide Truss Head Phillips Screws.STEP, 91770A073_Extra-Wide Truss Head Phillips Screws.ipt, 91771A066_Passivated 18-8 Stainless Steel Phillips Flat Head Screw.STEP, 91771A066_Passivated 18-8 Stainless Steel Phillips Flat Head Screw.ipt, Carrier Clip V1.ipt, Carrier Plate V1.ipt]
2022-05-19 Adds throughput testing components
    [BBM Assembly v1p1.iam, BBM Assembly.iam, Throughput Mockup Assembly v1p1.iam, Throughput Mockup Assembly.iam, etl_etroc_mockup_v1.step, etl_etroc_mockup_v1p1.step, etl_lgad_mockup_v1.step, etl_lgad_mockup_v1p1.step]
2022-05-24 Adds FNAL's 16-pocket chuck design and picker tool V2
    [3766A81_Extreme-Temperature Food Industry Vacuum Cup.STEP, 3766A81_Extreme-Temperature Food Industry Vacuum Cup.ipt, 44555K147_BRASS BARBED TUBE FITTING FOR VACUUM.ipt, 4464K561_TYPE 304 STAINLESS STL THREADED PIPE FITTING.ipt, 90128A212_ZNC-PLTD ALLOY STL SCKT HEAD CAP SCREW.ipt, 90128A253_ZNC-PLTD ALLOY STL SCKT HEAD CAP SCREW.ipt, Bellows Assembly.0004.iam, Bellows Assembly.iam]
2022-05-25 Adds work orders and designs for ETL picker tool modification and cam lock installation on 16-pocket chuck
    [Picker Tool - V2.iam, Picker Tool - V2.stp, Picker Tool - V2p1.stp, Platform A - V2.ipt, Platform Assembly - V2.iam, Platform B - V2.ipt]
2022-06-23 Adds hinge-based Jig design
    [51025K323_Brass Push-to-Connect Tube Fitting for Air.STEP, 51025K323_Brass Push-to-Connect Tube Fitting for Air.ipt, 91099A104_Passivated 18-8 Stainless Steel Phillips Flat Head Screw.STEP, 91099A104_Passivated 18-8 Stainless Steel Phillips Flat Head Screw.ipt, 91772A238_Passivated 18-8 Stainless Steel Pan Head Phillips Screw.STEP, 91772A238_Passivated 18-8 Stainless Steel Pan Head Phillips Screw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]
2022-10-10 Oct 10 update
    [51025K323_Brass Push-to-Connect Tube Fitting for Air.STEP, 91099A104_Passivated 18-8 Stainless Steel Phillips Flat Head Screw.STEP, 91185A559_Plastic-Head Thumb Screws.STEP, 91185A570_Plastic-Head Thumb Screws.STEP, 91770A073_Extra-Wide Truss Head Phillips Screws.STEP, 91771A066_Passivated 18-8 Stainless Steel Phillips Flat Head Screw.STEP, 91772A238_Passivated 18-8 Stainless Steel Pan Head Phill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]
2023-01-24 Weight Applier for Modules added and all the parts needed to make it
    [90044A111_Black-Oxide Alloy Steel Socket Head Screw.STEP, 90044A111_Black-Oxide Alloy Steel Socket Head Screw.ipt, 90272A972_Zinc-Plated Steel Pan Head Phillips Screw.ipt, 91251A094_Black-Oxide Alloy Steel Socket Head Screw.STEP, 91251A094_Black-Oxide Alloy Steel Socket Head Screw.ipt, 91375A773_Alloy Steel Cup-Point Set Screw.STEP, 91375A773_Alloy Steel Cup-Point Set Screw.ipt, 91590A137_Externa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]
2023-03-06 Commit of recent work
    [3766A81_Extreme-Temperature Food Industry Vacuum Cup.STEP, 3766A81_Extreme-Temperature Food Industry Vacuum Cup.ipt, 51025K323_Brass Push-to-Connect Tube Fitting for Air.ipt, 5427A604_Vacuum Cup.ipt, 90910A443_BUTTON HEAD TORX SCREWS.ipt, 91099A104_Passivated 18-8 Stainless Steel Phillips Flat Head Screw.ipt, 91251A168_Black-Oxide Alloy Steel Socket Head Screw.STEP, 91251A168_Black-Oxide Alloy St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]
2023-03-15 Adds TFPX Carrier Wirebonding Plate
    [Carrier Assembly.iam, Carrier Wirebonding Plate Assembly.iam, Carrier Wirebonding Plate.ipt, Carrier.ipt, Pigtail.ipt, Sensor Mount Film Applicator - V2.iam, Tamale - V1p5 - keepouts.stp, Tamale - V1p5.iam]
2023-06-12 Updates to ETL tooling
    [436500212.ipt, 5427A604_Vacuum Cup.ipt, 6186659312.iam, 7198086272.iam, 7198089072.iam, 7198090112.iam, 7198090992.iam, 7198092272.iam]
2023-06-12 Adds Hose Clamp
    [91772A537_Passivated 18-8 Stainless Steel Pan Head Phillips Screw.STEP, 91772A537_Passivated 18-8 Stainless Steel Pan Head Phillips.ipt, Hose Clamp V2.ipt, Hose Clamp V2.stl, Hose Clamp V3.ipt, Hose Clamp V3.stl, Hose Clamp.iam, Hose Clamp.ipt]
2023-07-11 Update July 11
    [90044A111_Black-Oxide Alloy Steel Socket Head Screw.ipt, 90272A972_Zinc-Plated Steel Pan Head Phillips Screw.ipt, 91251A094_Black-Oxide Alloy Steel Socket Head Screw.ipt, 91375A773_Alloy Steel Cup-Point Set Screw.ipt, 91590A137_External Retaining Ring.ipt, 94051A206_Titanium Washer.ipt, 9533T5_Self-Aligning Linear Sleeve Bearing.ipt, 9634K37_Extension Spring Stud Anchor.ipt]
2023-10-05 Cleans up WAM assembly
    [91590A137_External Retaining Ring.ipt, 9533T5_Self-Aligning Linear Sleeve Bearing.ipt, LockMechanism_v3.iam, Rod.ipt, Weight Applier for Modules v4.iam, Weight Applier for Modules v4.stp, handle handle.ipt, handle.ipt]
2024-03-21 Adds module cover for ETL V0 Module PCB
    [Cover V1.ipt]
2024-04-16 Adds ETL module irradiation fixture
    [91420A003_Steel Phillips Flat Head Screws.STEP, 91420A003_Steel Phillips Flat Head Screws.ipt, Beam Profile.ipt, Glass Slide Spacer V1.ipt, Irradiation Fixture V1.iam, Kapton Cover.ipt, Module Cradle Base V1.ipt, Module Cradle Left V1.ipt]
2024-04-16 Adds Vacuum Passthrough/new tool holder
    [1174N104_Oil-Resistant Soft Buna-N O-Rings.STEP, 1174N104_Oil-Resistant Soft Buna-N O-Rings.ipt, 5111K594_Push-to-Connect Tube Fitting for Air and Water.STEP, 5111K594_Push-to-Connect Tube Fitting for Air and Water.ipt, 90967A180_External Retaining Ring.STEP, 90967A180_External Retaining Ring.ipt, 92010A326_Passivated 18-8 Stainless Steel Phillips Flat .ipt, 92010A326_Passivated 18-8 Stainless St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]
2024-05-14 Adds Picker Tool V2
    [91290A099_Alloy Steel Socket Head Screw.STEP, 91290A099_Alloy Steel Socket Head Screw.ipt, 91290A104_Alloy Steel Socket Head Screw.STEP, 91290A104_Alloy Steel Socket Head Screw.ipt, 98541A116_External Retaining Ring.STEP, 98541A116_External Retaining Ring.ipt, Picker Tool - V2.dwg, Picker Tool - V2.iam]
2024-05-14 Adds 16 pocket Chuck V2
    [44555K147_BRASS BARBED TUBE FITTING FOR VACUUM.ipt, 4464K561_TYPE 304 STAINLESS STL THREADED PIPE FITTING.ipt, 5111K573_Push-to-Connect Tube Fitting for Air and Water.STEP, 90128A212_ZNC-PLTD ALLOY STL SCKT HEAD CAP SCREW.ipt, 90128A253_ZNC-PLTD ALLOY STL SCKT HEAD CAP SCREW.ipt, Chuck - 16-pocket - V2.iam, Chuck - 16-pocket - V2.ipt, Chuck with BBM Staging Plate.iam]
2024-05-14 Adds Chuck V3
    [44555K147_BRASS BARBED TUBE FITTING FOR VACUUM.ipt, 4464K561_TYPE 304 STAINLESS STL THREADED PIPE FITTING.ipt, 5486K121_Weld-Spatter-Resistant Push-to-Connect Tube Fitting.STEP, 5486K121_Weld-Spatter-Resistant Push-to-Connect Tube Fitting.ipt, 90128A212_ZNC-PLTD ALLOY STL SCKT HEAD CAP SCREW.ipt, 90128A253_ZNC-PLTD ALLOY STL SCKT HEAD CAP SCREW.ipt, 93600A304_316 Stainless Steel Dowel Pin.STEP, 9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]
2024-05-14 Updates to module design
    [BBM.iam, Baseplate v1.5.1.dwg, Baseplate v1.5.1.ipt, Baseplate v1.5.1b.ipt, Baseplate v1.5.dxf, Connector Cover.ipt, Connector Cover.stl, Module PCB V1b.step]
2024-06-04 Updates to irradiation fixture
    [91420A003_Steel Phillips Flat Head Screws.STEP, 93840A122_Off-White Nylon Slotted Flat Head Screws.ipt, Irradiation Fixture V1.iam, Module Cradle Base V1.ipt, Module Cradle Left V1.ipt, Module Cradle Right V1.ipt, Module Cradle V1.dwg, Module Cradle V1.iam]
2024-06-04 Syncing minor changes (inventor version mostly) to ETL module
    [Cover with Module.iam, Mock Module PCB - v1p4b.iam, Module Cover.ipt, Module Cover.stl, Tamale - V1p5p2.iam, Tamale - v1p4b.iam, Throughput Mockup Assembly.stp, etl_module_pcb_thermal_mockup_v3.ipt]
2024-06-12 Updates to Gantry hub box design files
    [178-025-513.STEP, 178-025-513.ipt, 178-037-513.STEP, 178-037-513.ipt, Back.ipt, Back.stp, Bottom.ipt, Bottom.stp]
2025-04-23 Adds Tamale v1.6
    [1.ipt, 10.ipt, 11.ipt, 12.ipt, 13.ipt, 14.ipt, 145897078002829.ipt, 15.ipt]
